MITHaystack/ASTRA/docs/help/README.md

## ASTRA HELP

### When Things Go Wrong

1. Try turning it off and back on again. 
2. Check for loose cables.
3. Try flipping cable orientations.
4. Align to zero, zero and cycle mount power. 

### Mechanical 
- [Stuff is Loose](astra-mechanical.md#Loose)
- [Stuff is Broken](astra-mechanical.md#Broken)
- [Wobbly Tripod](astra-mechanical.md#Tripod)
- [Swiveling Camera](astra-mechanical.md#Camera)
- [Detached Leveling Foot](astra-mechanical.md#Foot)

### Electrical
- [Out of Power](astra-electrical.md#Power)
- [Damaged cables](astra-electrical.md#Cable)
- [Battery is very hot](astra-electrical.md#BatteryHot)
- [Battery won't charge](astra-electrical.md#BatteryCharge)

### Radio
- [Lots of interference](astra-radio.md#Interference)
- [Lots of nothing](astra-radio.md#Nothing)
- [No calibrator](astra-radio.md#Calibrator)
- [No hydrogen line](astra-radio.md#Hline)

### Optical
- [There is Dirt on It](astra-optical.md#Cleaning)
- [The Camera came out](astra-optical.md#Loose)
- [The Camera won't focus](astra-optical.md#Focus)
- [The Images are always noise](astra-optica.md#Noisy)

### Computer
- [Abrupt shutdown](astra-computer.md#Shutdown)
- [SSH fails](astra-computer.md#SSH)
- [RDP fails](astra-computer.md#RDP)
- [RDP is small](astra-computer.md#RDPScreen)
- [No ASTRA hotspot](astra-computer.md#Hotspot)
- [Won't connect to network](astra-computer.md#Network)
- [Updates](astra-computer.md#Updates)

### User Interface
- [Known Issues](astra-ui.md#Bugs)
