MITHaystack/ASTRA/docs/hardware/sdr-carrier.md

# ASTRA - Compute and SDR Enclosure Build 

A dedicated computer and SDR enclosure can be used with ASTRA but it is
often easier to integrate directly into a combined DAQ and Energy unit
box.
