MITHaystack/ASTRA/docs/hardware/computer.md

# ASTRA - Computer 

ASTRA uses an AMD or Intel NUC style computer with a supporting metal case that provides an
NVME M.2 SSD drive. A small enough computer can fit into the Battery / DAQ enclosure. We have
tried comptuers such as the Raspberry Pi 5 but have had reliability and power issues.
