MITHaystack/ASTRA/docs/about/README.md

## About ASTRA

ASTRA occurred because of Joe Lind's Eagle Scout project needing to meet the requests and needs of
the potential users in his High School science program. They wanted a "teaching cart" for astronomy.
The existing Small Radio Telescope really wasn't suitable for their needs or location. At MIT Haystack Observatory, we didn't have quite the right thing so Joe and his father Dr. Frank Lind set out to create a solution and respond to the request. 

ASTRA is the result... 

_To help other people at all times_

# ASTRA History

ASTRA derives from earlier work on the Small Radio Telescope (SRT) and Very Small Radio Telescope (VSRT). These systems were initially developed by Dr. Alan Rogers of MIT Haystack Observatory and documented in his memo series. Many staff members of MIT Haystack Observatory have contributed to these systems and they have been the subject of a number of student projects. 

The specific ASTRA design was developed as part of a Haystack student project by Joe Lind of Groton Dunstable Region High School and Troop 1 West Groton. This project ultimately became a part of an Eagle Scout project by Joe to contribute the second prototype unit to Groton Dunstable Region High School (GDRHS). Early testing and construction of this unit involved contributions from members of Scouting America Troop 1 West Groton. Staff members at MIT Haystack Observatory also contributed to 
the concepts and technologies selected for implementation of ASTRA. These individuals include Ryan
Volz, John Swoboda, and Rigel Cappallo. 

Dr. Frank Lind developed the first prototype design and software in combination with early testing together and concept exploration with Joe Lind. The entire effort was in response to the science teachers of Groton Dunstable High School wanting a smaller and more portable system than an SRT. Hardware integration and system testing was a collaborative effort that spanned more than a year. The Eagle Scout project to duplicate and donate the system spanned about six months from approval to 
completion. 

## Acknowledgements

We would like to acknowledge all those who have donated funds and time to support the development ASTRA. This includes generous support for the donation of the second prototype unit to the GDRHS. Scouts from Troop 1 West Groton also contributed to the system by helping to replicate the prototype unit, assembling components, and helping with testing. The enthusiasm of Haystack staff members during
our testing on site was also welcome and very encouraging. 

Dr. Frank Lind also put in endless hours on nights and weekends testing hardware and developing the software for the system. The Lind family also financially supported aspects of the project outside of the Eagle scout project. 

_Labor omnia vincit_

Joe Lind also earned his stripes as an astronomer, testing in the middle of winter and well below zero, and the heat of summer with heat, humidity, and a lack of shade. 

_Sic itur ad astra_

# ASTRA Open Source Usage and Contributions

ASTRA leverages a number of other commercial and open source projects. 

- [Python]() We have been heavy duty python users since 2001! Read-write Lisp for the win.
- Assorted python packages such as numpy, scipy, aiomqtt, etc. 
- [DigitalRF]() Behind the scenes for RF data capture. Our own one here.
- [Skyplot]() A really first class python package for starcharts and plotting.
- [Nicegui]() As claimed, a really well done asyncio framework graphical interface platform.
- [Marimo]() Python notebooks for on platform manipulation and analysis of data. 

# ASTRA Use of Artificial Intelligence

The ASTRA user interface has made use of the Claude Sonnet 4.6 model for initial vibe coding of the astra-ui portion of the code base. This coding was guided by the Nice Vibes AI coding agent guidelines for the python NiceGUI user interface framework. Other code used in ASTRA has been hand developed. All of it has been modified or edited manually. 

### License

This system and software, unless otherwise noted, is licensed under the BSD 3-clause 
"New" or "Revised" license.
