MITHaystack/ASTRA/docs/projects/README.md

# ASTRA Projects

ASTRA projects are efforts requiring several observing sessions. 
Intermediate lessons require the reduction and analysis of data using on 
platform Marimo notebooks. Advanced lessons require the use of ASTRA
via command line tools and in combination with other software on and
off the platform. 

### Mini Projects - Basic
- [Observing the Sun](projects/astra-project-solar)
- [Observing the Moon](projects/astra-project-lunar)
- [Imaging Andromeda](projects/astra-project-andromeda)
- [Imaging the Pleiades](projects/astra-project-pleiades)
- [Star Cluster Survey](projects/astra-project-star-clusters)

### Mini Projects - Intermediate
- [Detecting Galactic Rotation Curve](projects/astra-project-rotation-curve-detection)
- [Observing Jupiter](projects/astra-project-jovian)
- [Measuring Radio Calibrators](projects/astra-project-calibrators)

### Mini Projects - Advanced
- [Imaging the Galactic Rotation Curve](projects/astra-project-rotation-curve-detection)
- [Imaging The Crab Nebula](projects/astra-project-crab-nebula)
