MITHaystack/ASTRA/docs/observations/radio-obs-example.md

## ASTRA Example Radio Observations

### Background RF

Background data pointed at the horizon with only interference lines visible. 

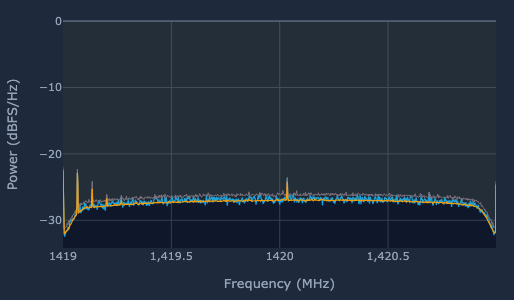
[picture p17: docs/observations/img/astra-background-rf-psd.png]


### Hydrogen Line Detection (Cygnus)

User interface example of live detected 1420.405 MHz Hydrogen Line (21 cm) signal. Pointing was
off of Cygnus. 

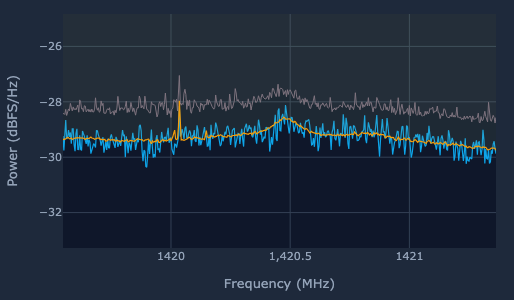
[picture p18: docs/observations/img/astra-hline-rf-example.png]


and a later time with more zoom and integration...

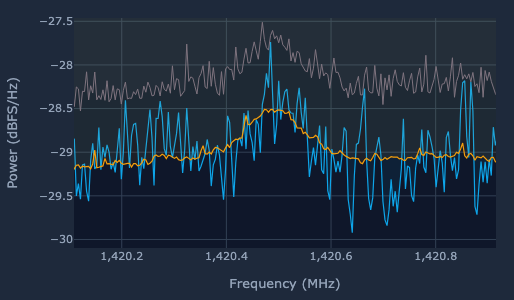
[picture p19: docs/observations/img/astra-hline-rf-zoom-example.png]


### DigitalRF Hydrogen Line (Examples)

Example towards polaris recorded as DigitalRF data capture and post processed with 1 second, 10 second, and 100 second integration lengths. A zoom in is shown for the 100 second data. This kind of
processing can be done on ASTRA itself using Marimo notebooks. 

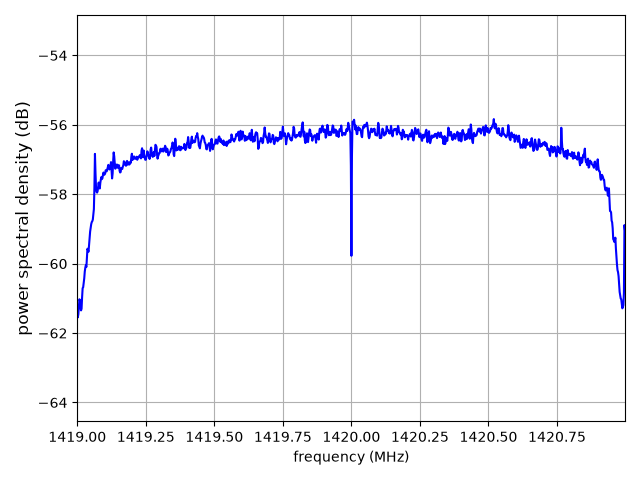
[picture p20: docs/observations/img/astra-polaris-hline-1sec.png]

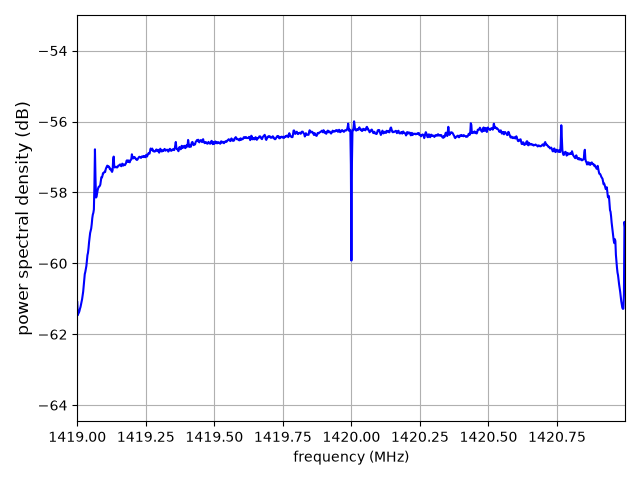
[picture p21: docs/observations/img/astra-polaris-hline-10sec.png]

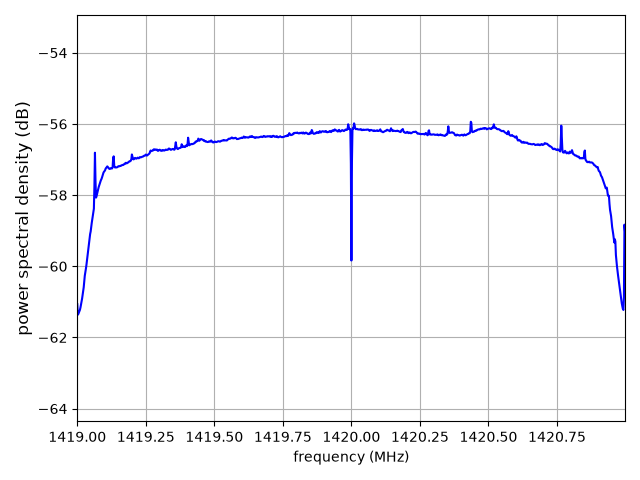
[picture p22: docs/observations/img/astra-polaris-hline-100sec.png]

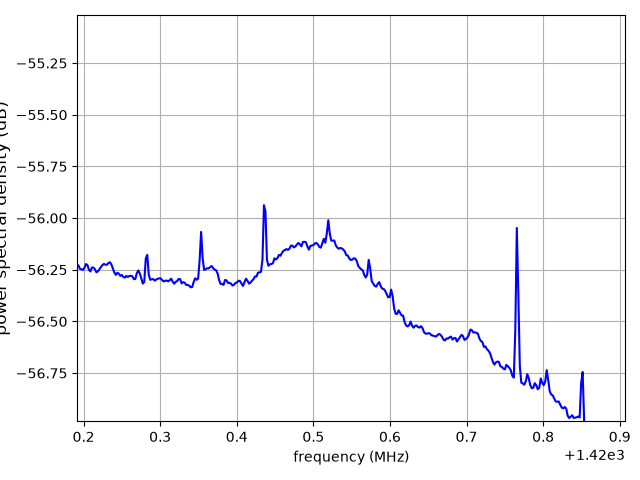
[picture p23: docs/observations/img/astra-polaris-hline-100sec-zoom.png]


Sharp line like features are generally local or self interference. Shielding and ferrites do help with
this in some cases. Getting away from local RFI is generally most effective. 

### Early Drift Scan

Example of DigitalRF collected and post processed zenith pointing drift scan from early testing.
