MITHaystack/ASTRA/docs/hardware/img/aiu/aiu-bracket-attachment.jpg

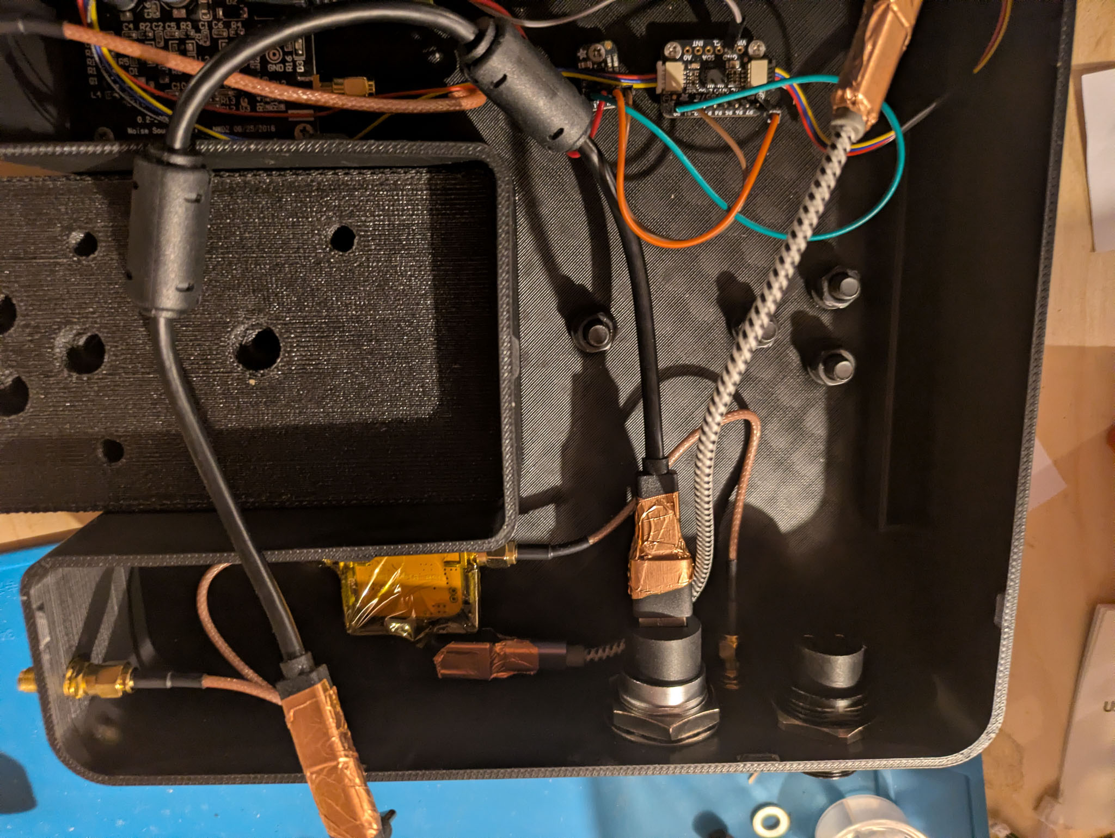
docs/hardware/img/aiu/aiu-bracket-attachment.jpg
