MITHaystack/ASTRA/docs/hardware/img/aiu/aiu-internal-complete.jpg

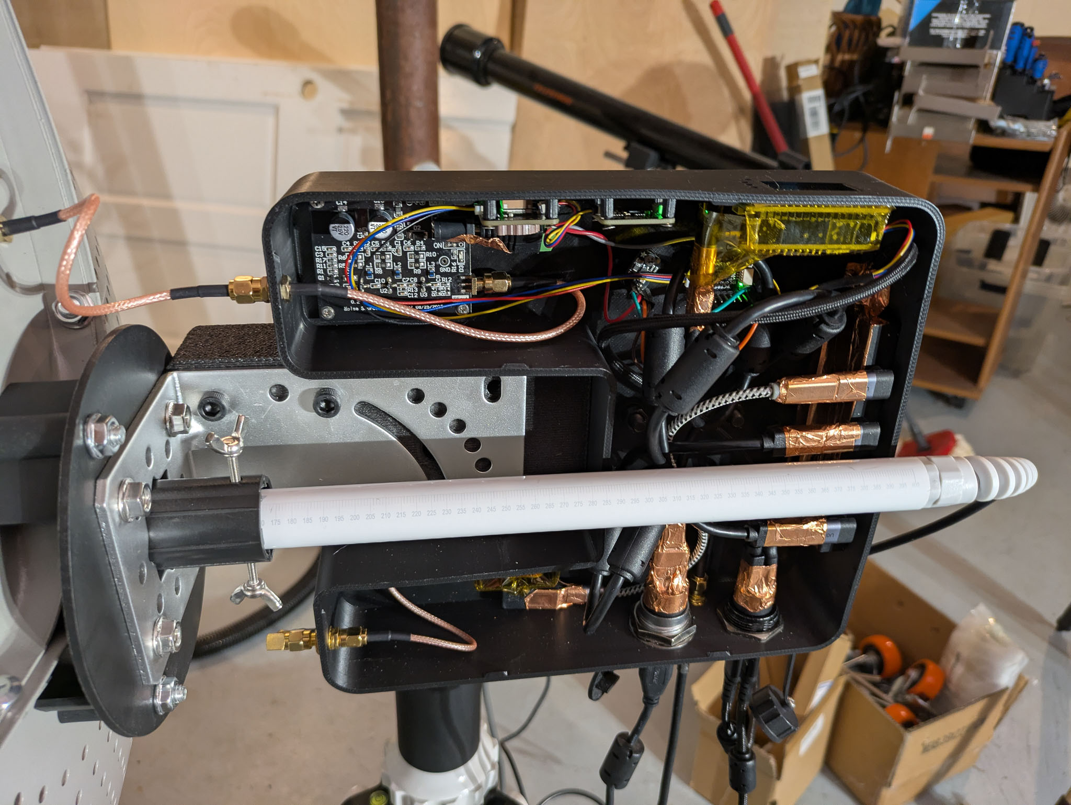
docs/hardware/img/aiu/aiu-internal-complete.jpg
