MITHaystack/ASTRA/docs/hardware/img/aiu/aiu-oled-external.jpg

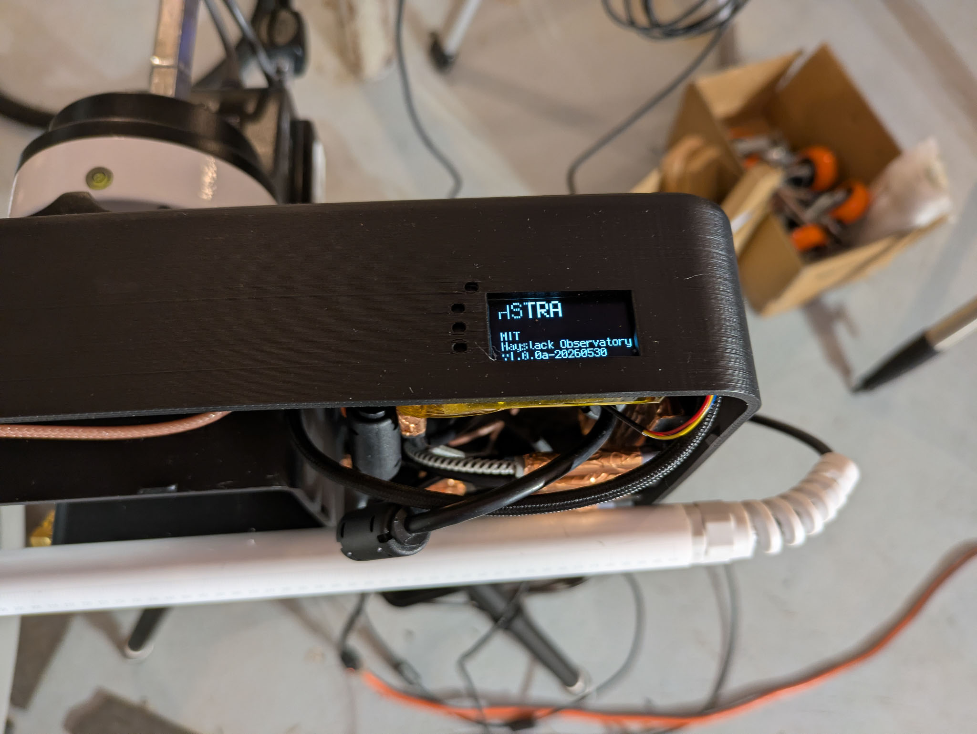
docs/hardware/img/aiu/aiu-oled-external.jpg
