MITHaystack/ASTRA/docs/hardware/img/aiu/aiu-sensors.jpg

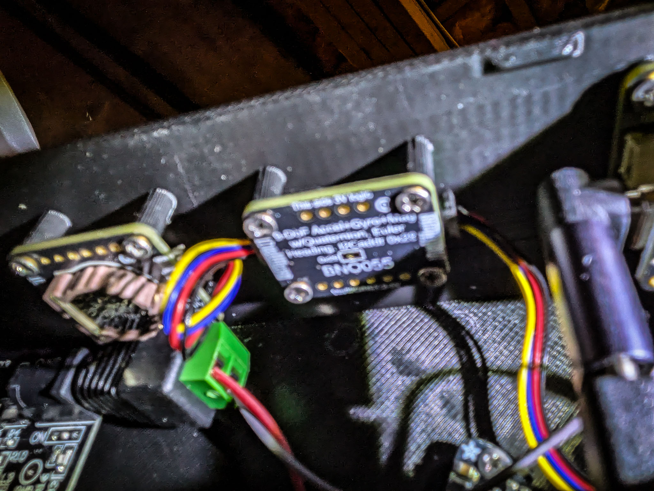
docs/hardware/img/aiu/aiu-sensors.jpg
