MITHaystack/ASTRA/docs/hardware/img/aiu/astra-aiu-internal.jpg

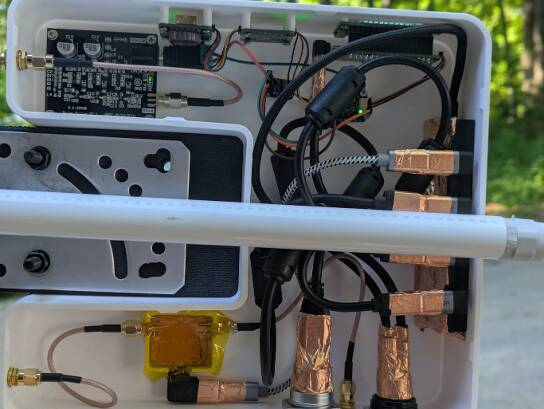
docs/hardware/img/aiu/astra-aiu-internal.jpg
