MITHaystack/ASTRA/docs/hardware/img/antenna/antenna-attachment-rear.jpg

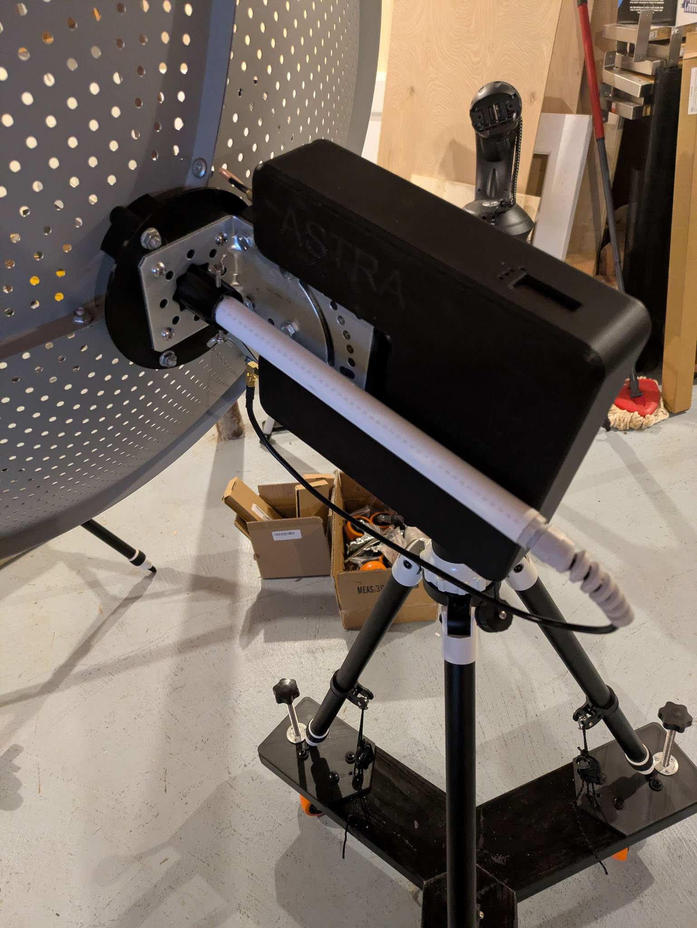
docs/hardware/img/antenna/antenna-attachment-rear.jpg
