MITHaystack/ASTRA/docs/hardware/img/antenna/antenna-dovetail-attachment.jpg

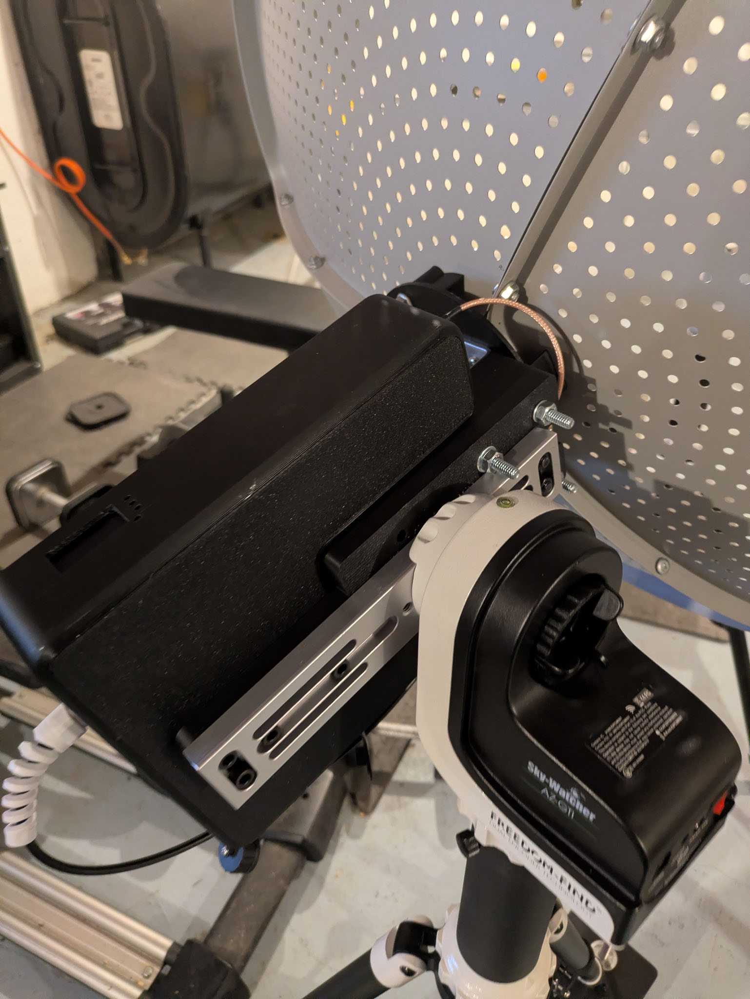
docs/hardware/img/antenna/antenna-dovetail-attachment.jpg
