MITHaystack/ASTRA/docs/hardware/img/antenna/antenna-feed-attachment.jpg

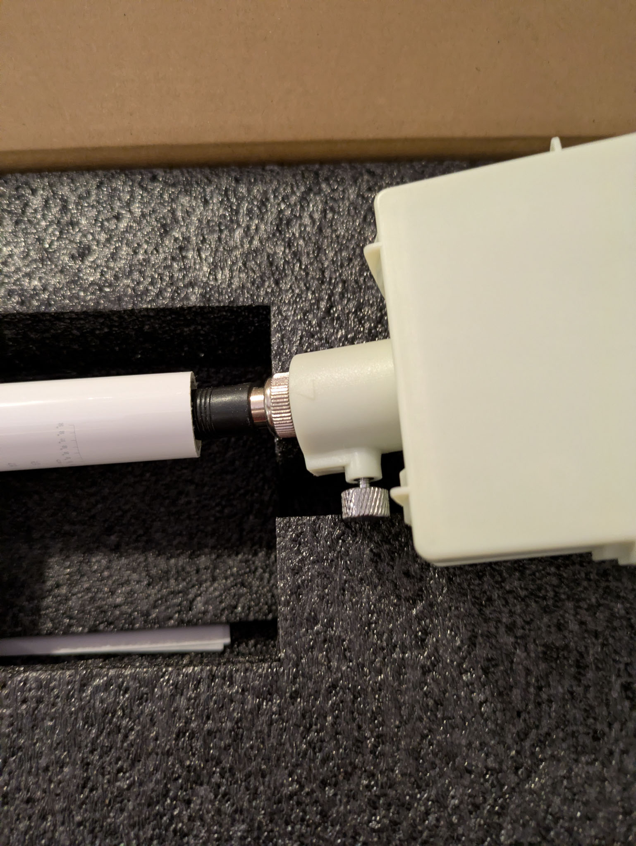
docs/hardware/img/antenna/antenna-feed-attachment.jpg
