MITHaystack/ASTRA/docs/hardware/img/antenna/antenna-feed-position.jpg

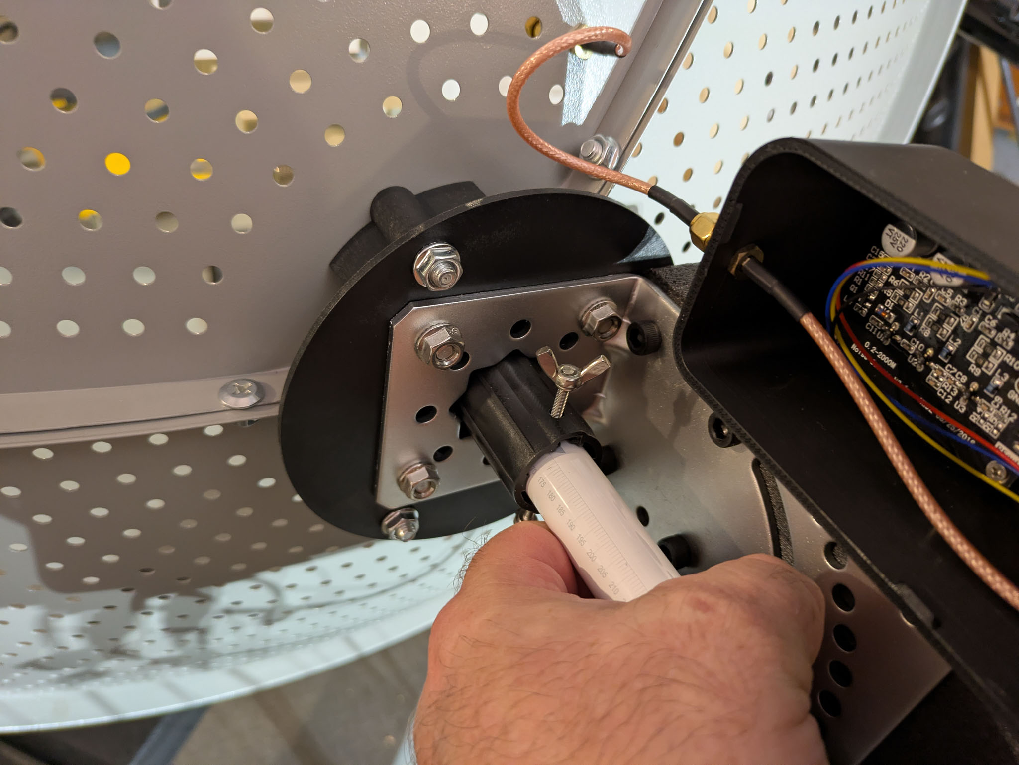
docs/hardware/img/antenna/antenna-feed-position.jpg
