MITHaystack/ASTRA/docs/hardware/img/antenna/antenna-feed-unboxing2.jpg

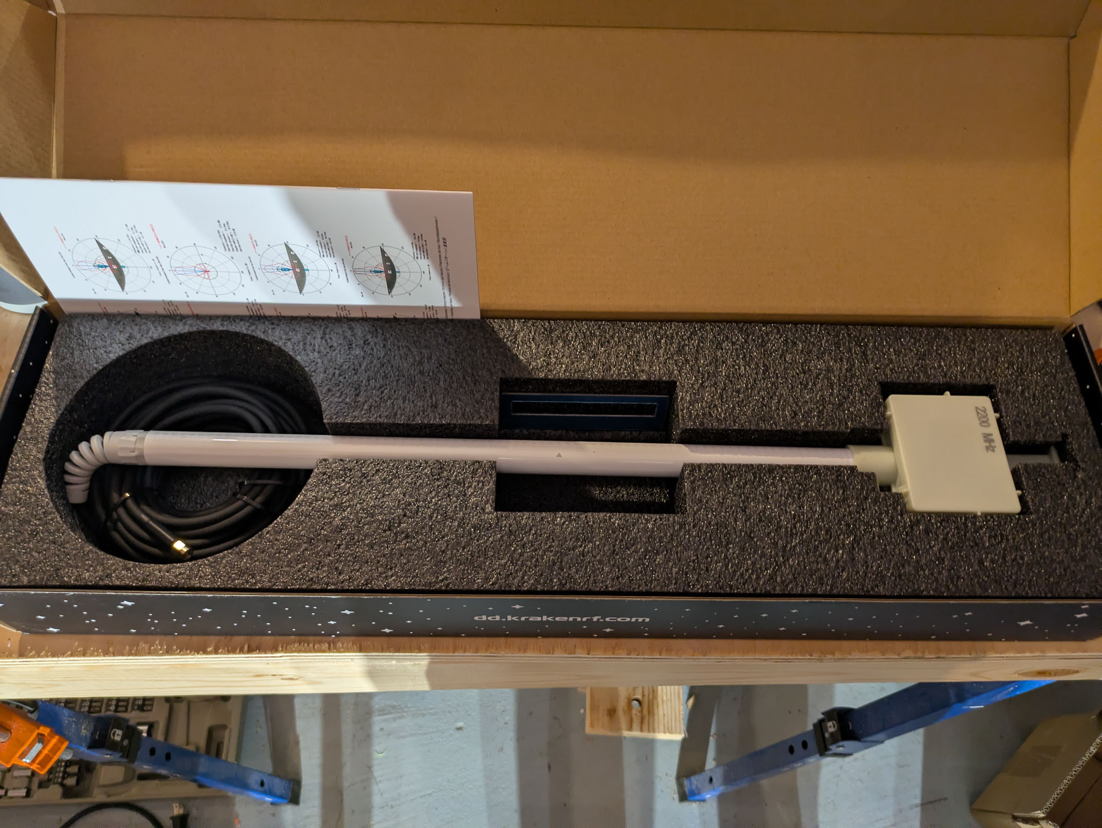
docs/hardware/img/antenna/antenna-feed-unboxing2.jpg
