MITHaystack/ASTRA/docs/hardware/img/antenna/antenna-feed-unboxing.jpg

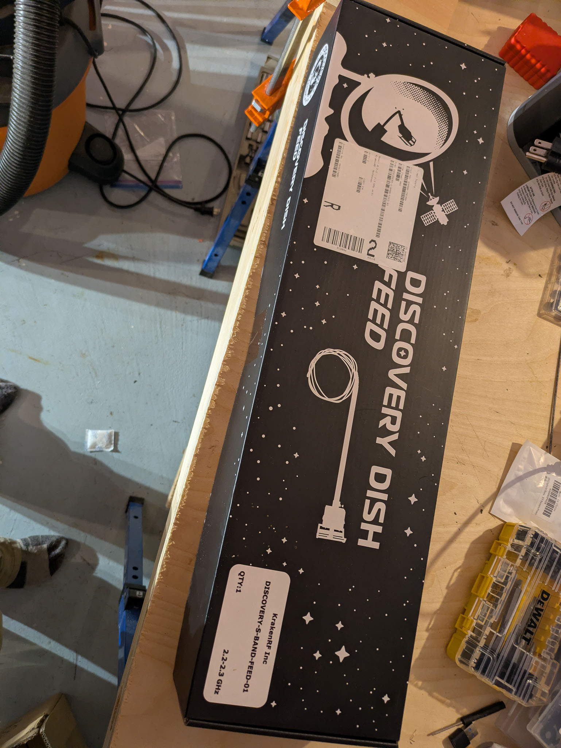
docs/hardware/img/antenna/antenna-feed-unboxing.jpg
