MITHaystack/ASTRA/docs/hardware/img/antenna/antenna-front.jpg

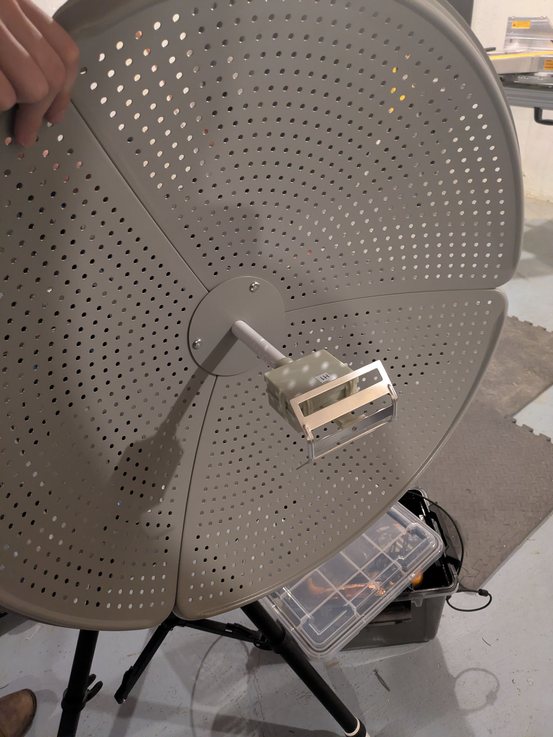
docs/hardware/img/antenna/antenna-front.jpg
