MITHaystack/ASTRA/docs/hardware/img/antenna/antenna-level.jpg

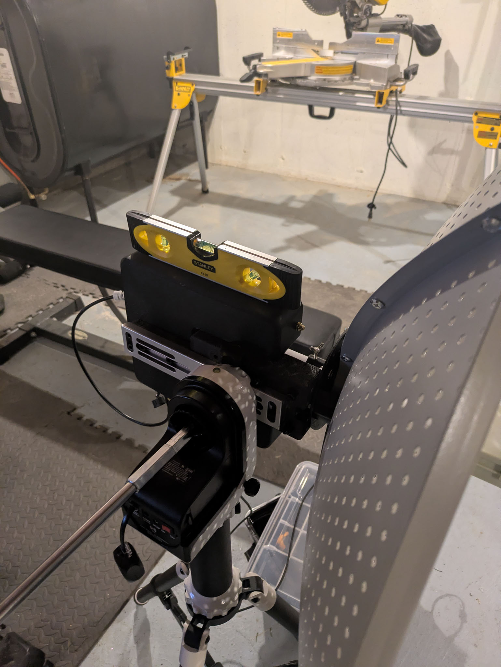
docs/hardware/img/antenna/antenna-level.jpg
