MITHaystack/ASTRA/docs/hardware/img/antenna/antenna-short-cable1.jpg

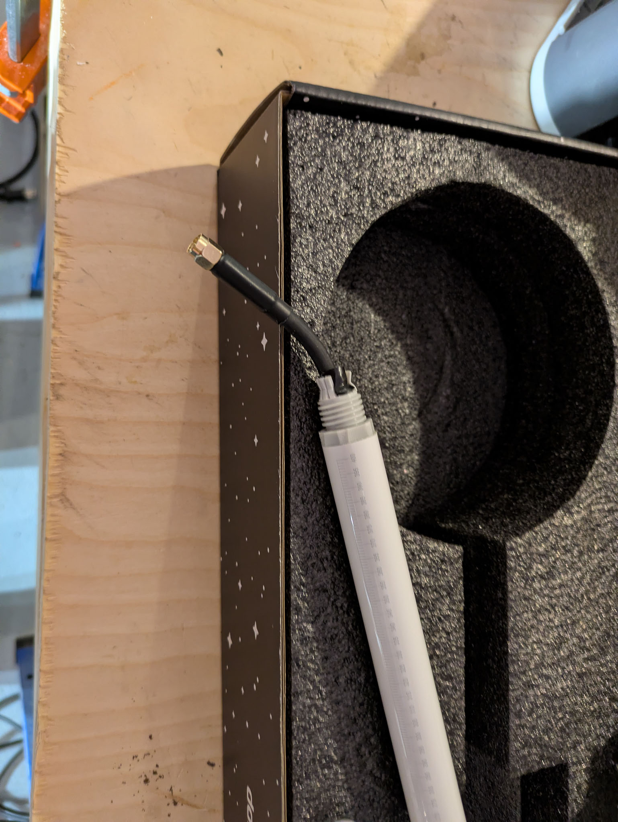
docs/hardware/img/antenna/antenna-short-cable1.jpg
