MITHaystack/ASTRA/docs/hardware/img/antenna/antenna-short-cable2.jpg

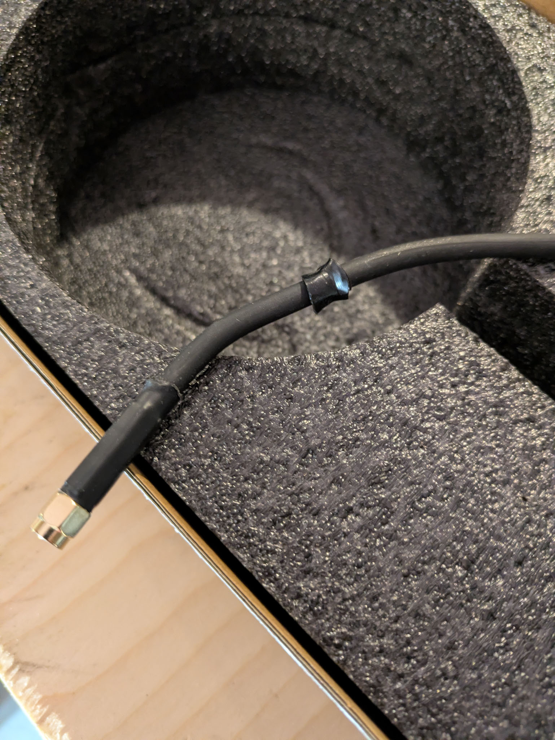
docs/hardware/img/antenna/antenna-short-cable2.jpg
