MITHaystack/ASTRA/docs/hardware/img/antenna/antenna-short-cable3.jpg

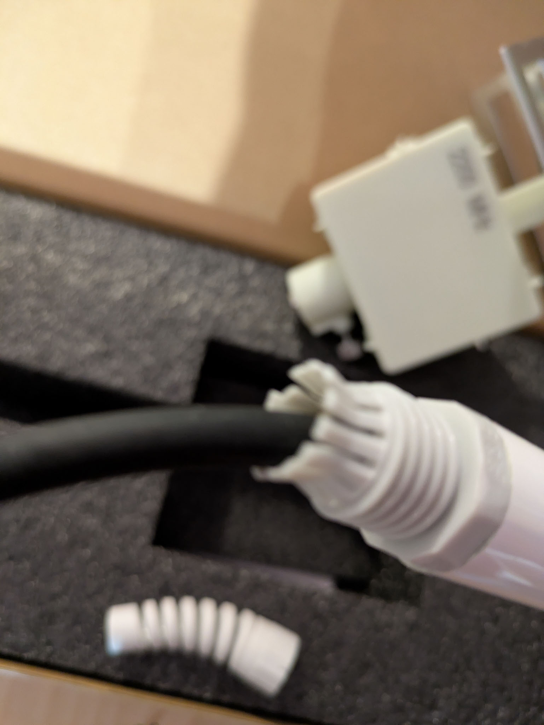
docs/hardware/img/antenna/antenna-short-cable3.jpg
