MITHaystack/ASTRA/docs/hardware/img/antenna/antenna-short-cable4.jpg

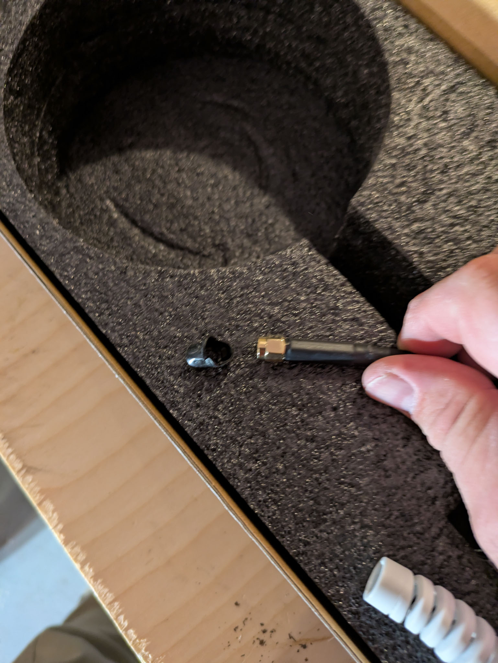
docs/hardware/img/antenna/antenna-short-cable4.jpg
