MITHaystack/ASTRA/docs/hardware/img/antenna/antenna-short-cable5.jpg

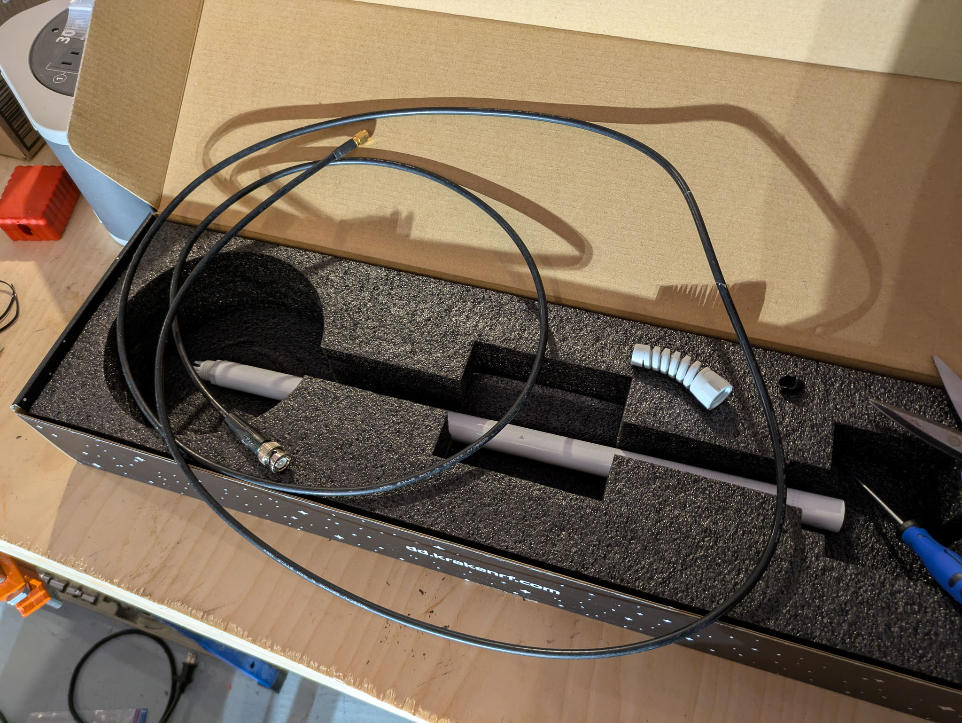
docs/hardware/img/antenna/antenna-short-cable5.jpg
