MITHaystack/ASTRA/docs/hardware/img/antenna/antenna-short-cable6.jpg

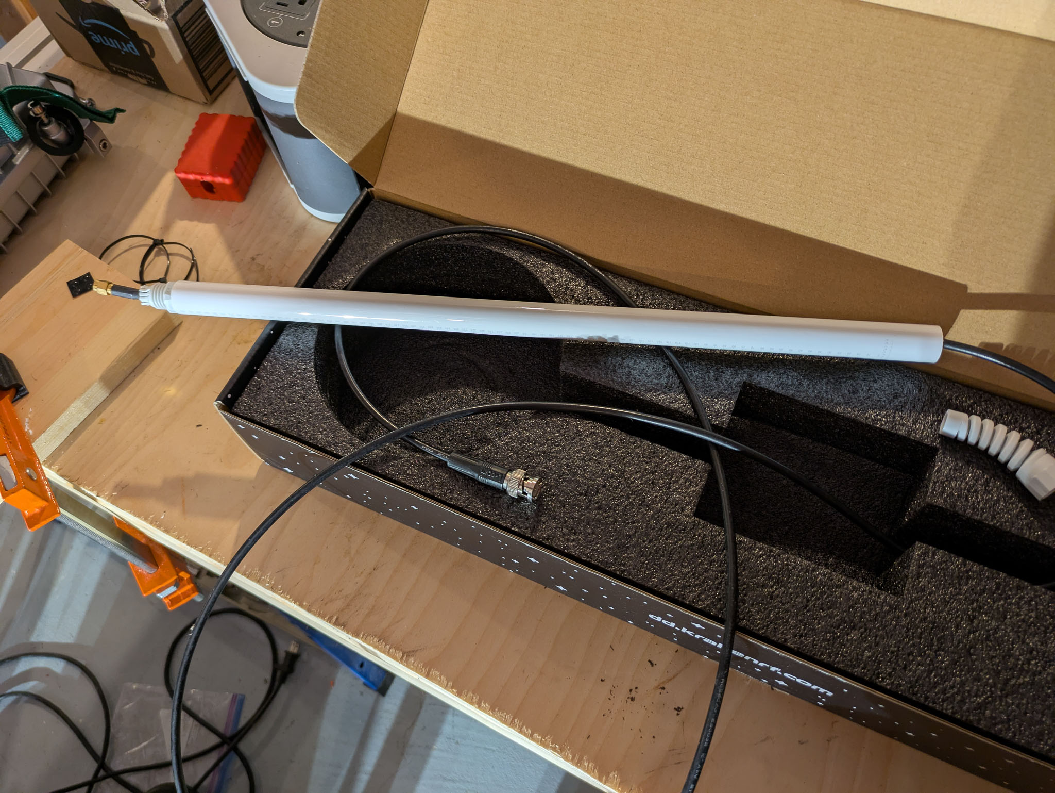
docs/hardware/img/antenna/antenna-short-cable6.jpg
