MITHaystack/ASTRA/docs/hardware/img/antenna/antenna-short-cable7.jpg

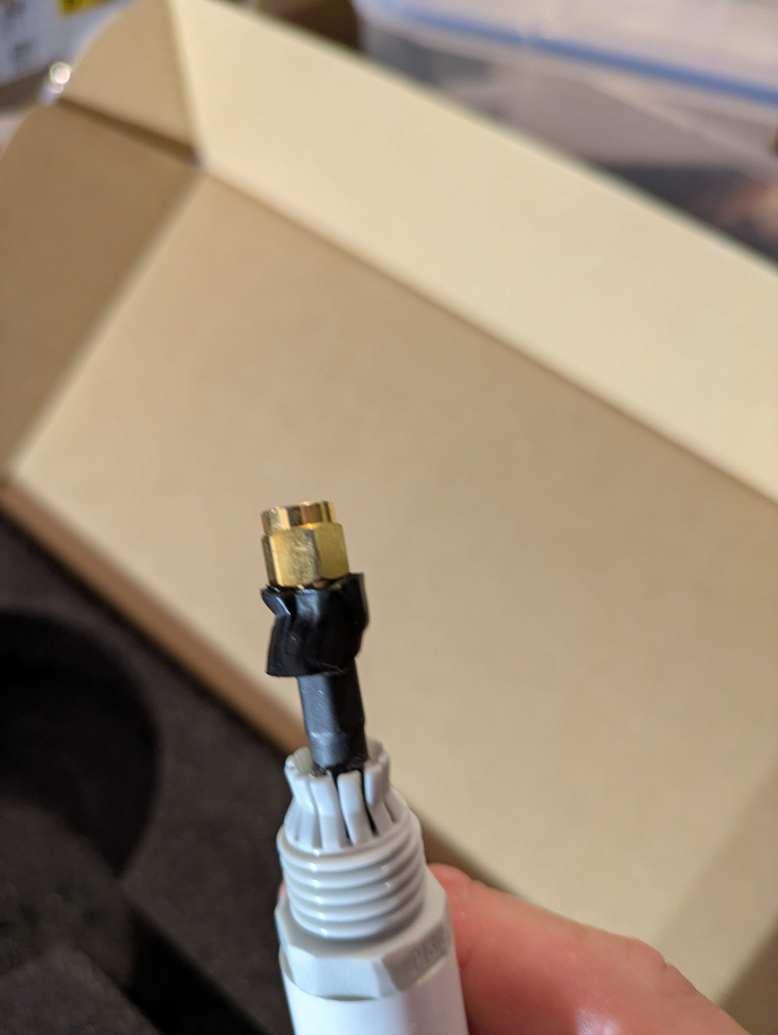
docs/hardware/img/antenna/antenna-short-cable7.jpg
