MITHaystack/ASTRA/docs/hardware/img/antenna/antenna-short-cable-feed.jpg

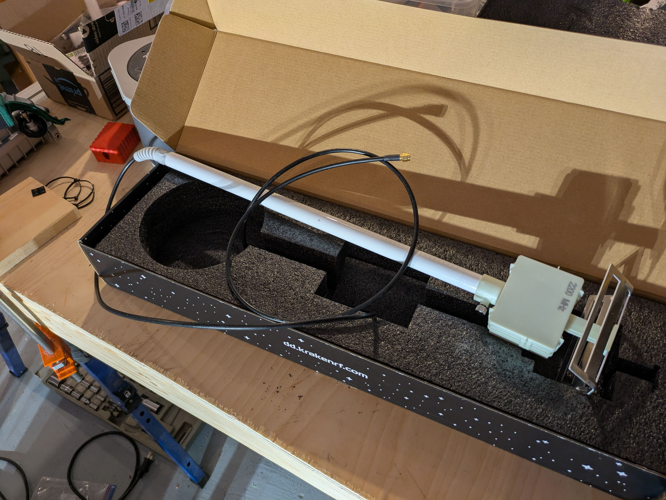
docs/hardware/img/antenna/antenna-short-cable-feed.jpg
