MITHaystack/ASTRA/docs/hardware/img/antenna/antenna-short-relief.jpg

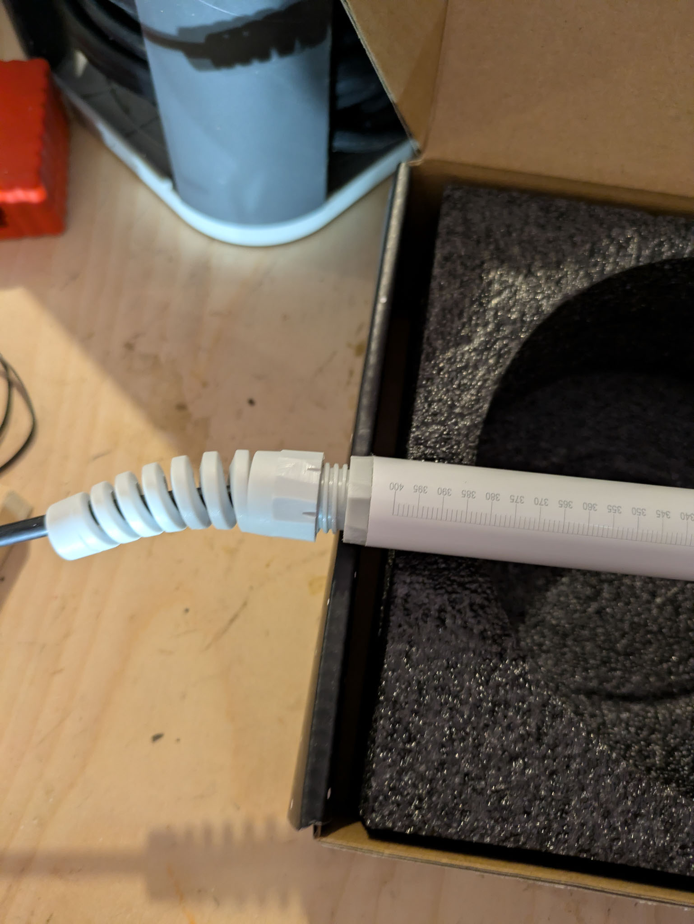
docs/hardware/img/antenna/antenna-short-relief.jpg
