MITHaystack/ASTRA/docs/hardware/img/base/base-align-glue.jpg

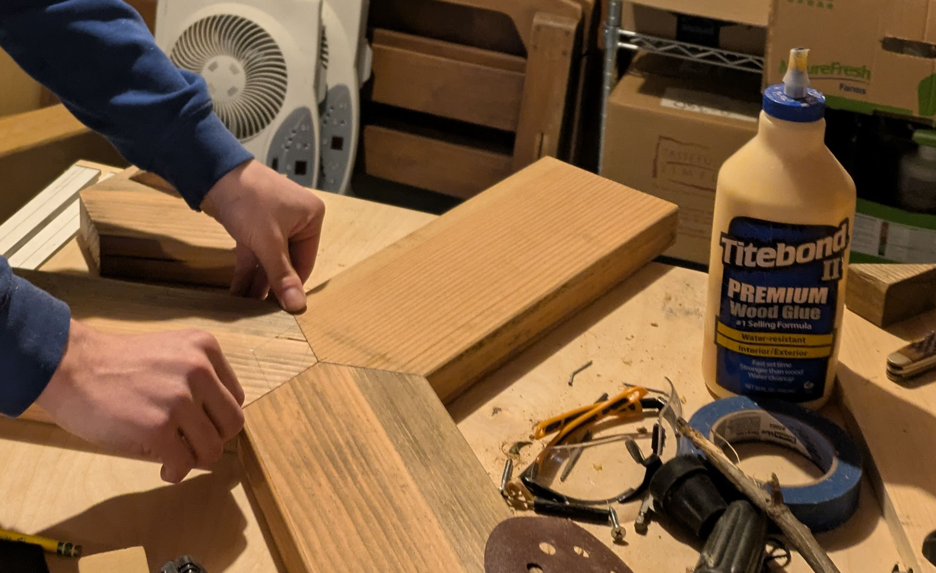
docs/hardware/img/base/base-align-glue.jpg
