MITHaystack/ASTRA/docs/hardware/img/base/base-center-connections.jpg

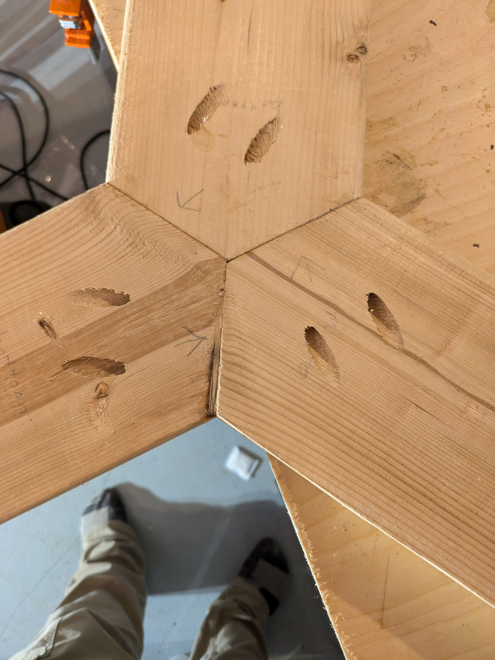
docs/hardware/img/base/base-center-connections.jpg
