MITHaystack/ASTRA/docs/hardware/img/base/base-cut-saw1.jpg

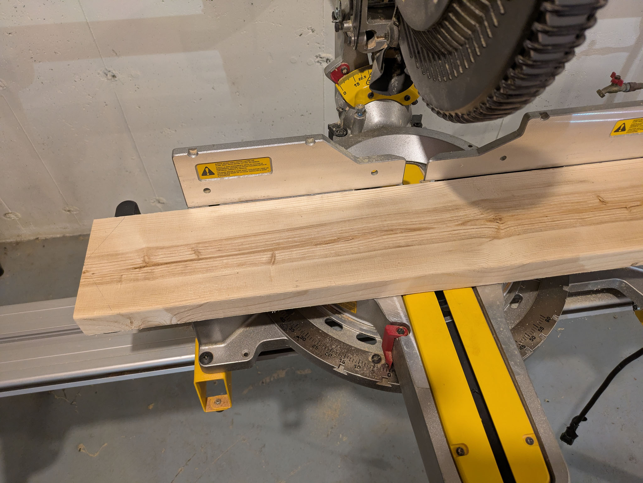
docs/hardware/img/base/base-cut-saw1.jpg
