MITHaystack/ASTRA/docs/hardware/img/base/base-cut-saw2.jpg

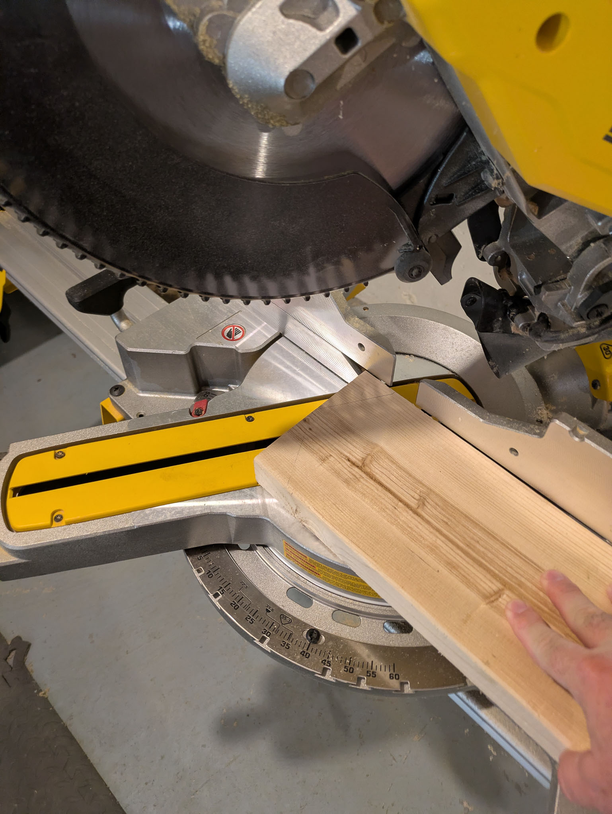
docs/hardware/img/base/base-cut-saw2.jpg
