MITHaystack/ASTRA/docs/hardware/img/base/base-cuts-marked.jpg

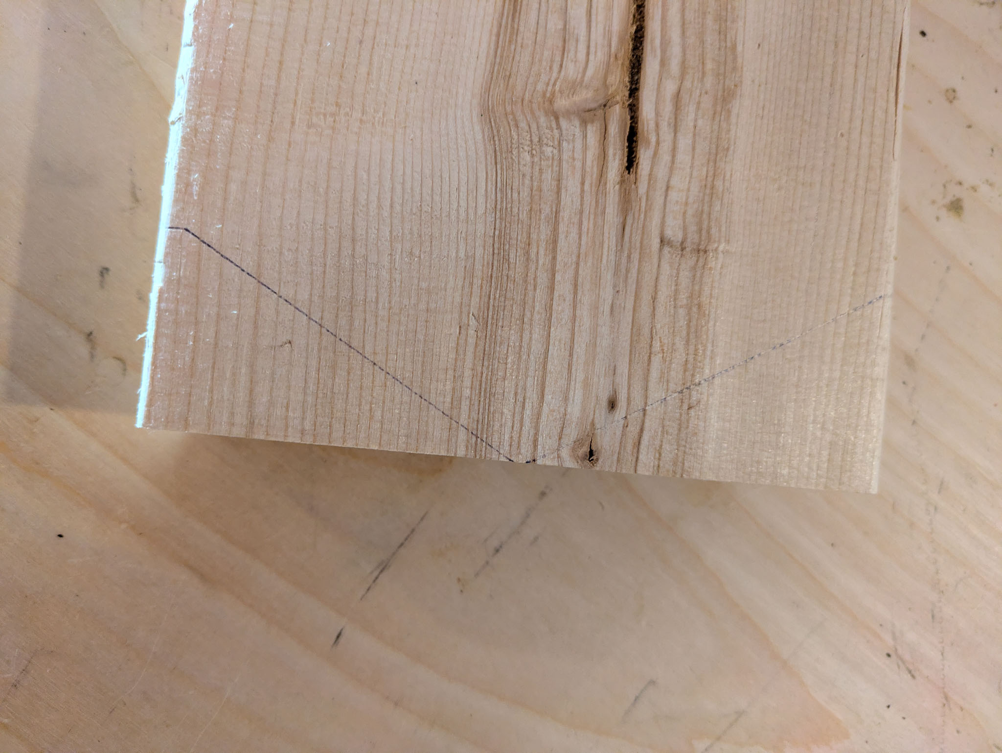
docs/hardware/img/base/base-cuts-marked.jpg
