MITHaystack/ASTRA/docs/hardware/img/base/base-foot-mount2.jpg

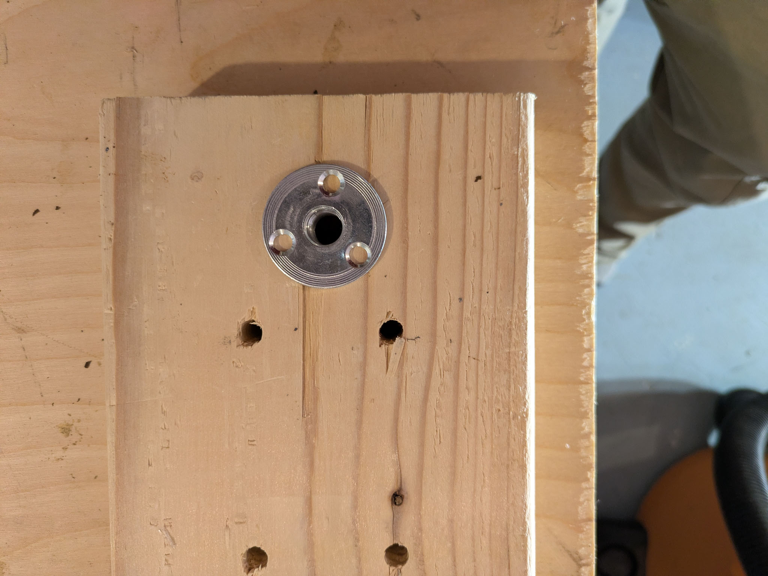
docs/hardware/img/base/base-foot-mount2.jpg
