MITHaystack/ASTRA/docs/hardware/img/base/base-foot-mount.jpg

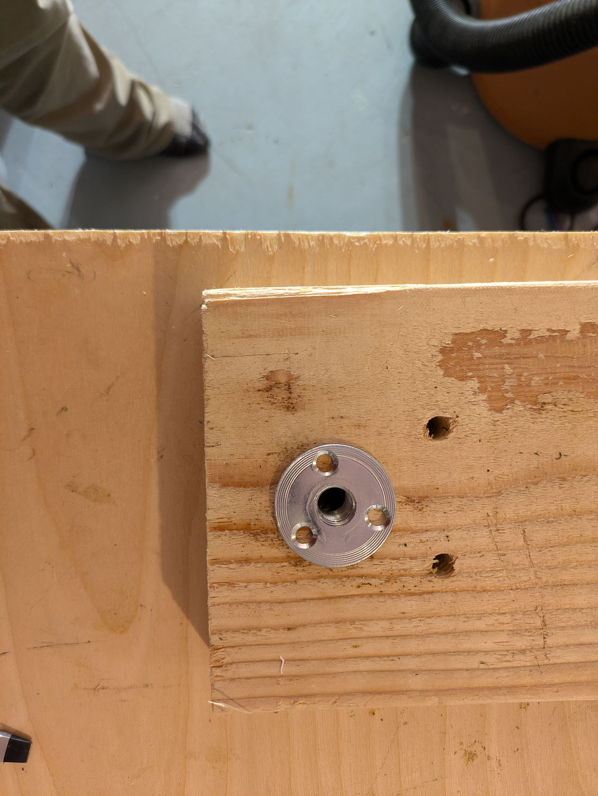
docs/hardware/img/base/base-foot-mount.jpg
