MITHaystack/ASTRA/docs/hardware/img/base/base-hole-pattern.jpg

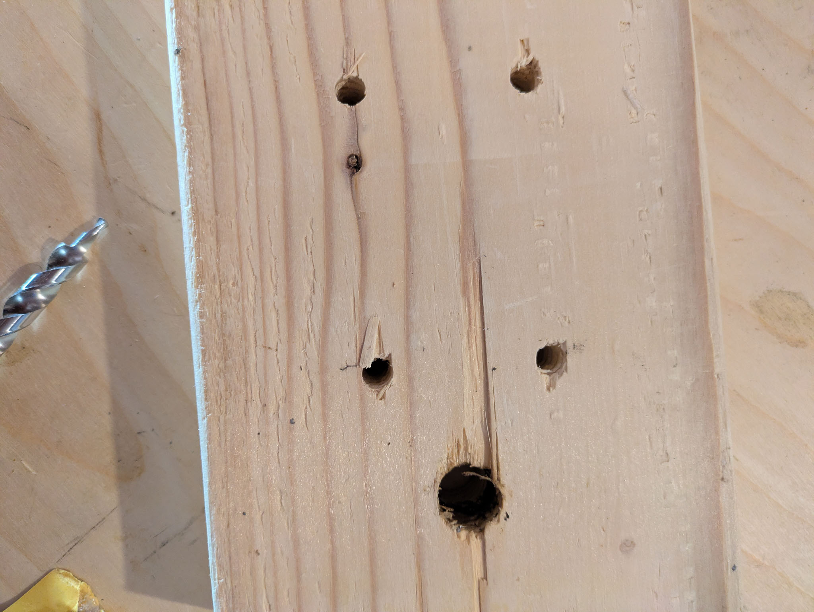
docs/hardware/img/base/base-hole-pattern.jpg
