MITHaystack/ASTRA/docs/hardware/img/base/base-large-wheel-option.jpg

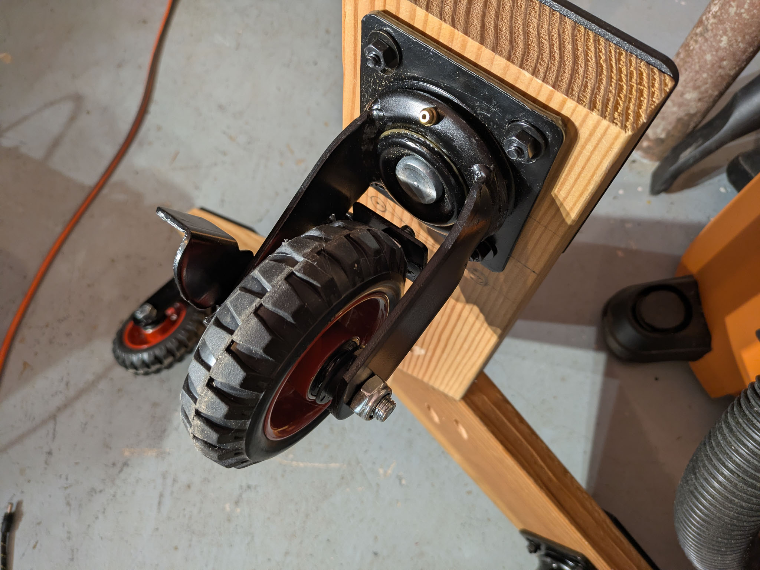
docs/hardware/img/base/base-large-wheel-option.jpg
