MITHaystack/ASTRA/docs/hardware/img/base/base-screw-jig.jpg

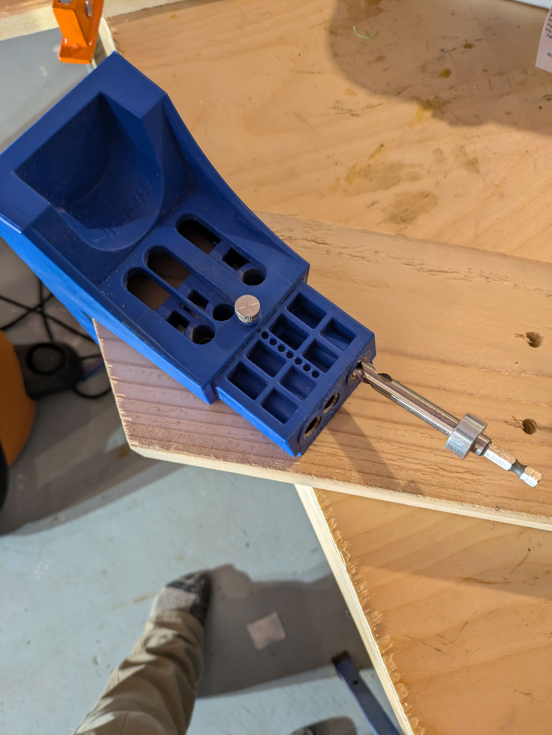
docs/hardware/img/base/base-screw-jig.jpg
