MITHaystack/ASTRA/docs/hardware/img/base/base-section.jpg

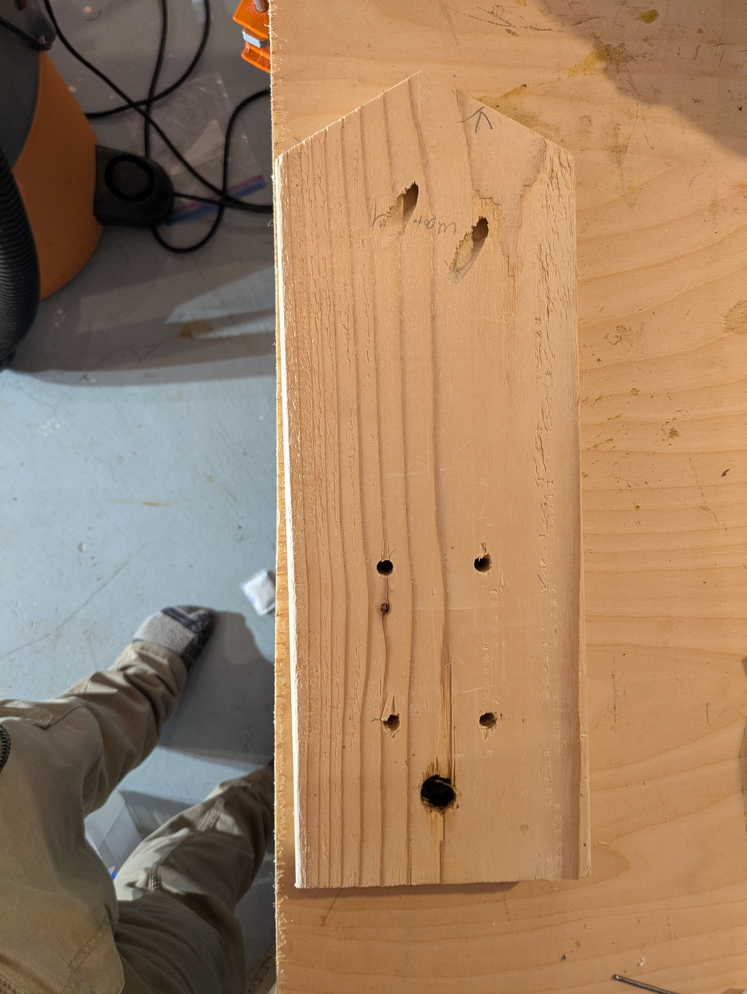
docs/hardware/img/base/base-section.jpg
