MITHaystack/ASTRA/docs/hardware/img/base/base-sections-cut2.jpg

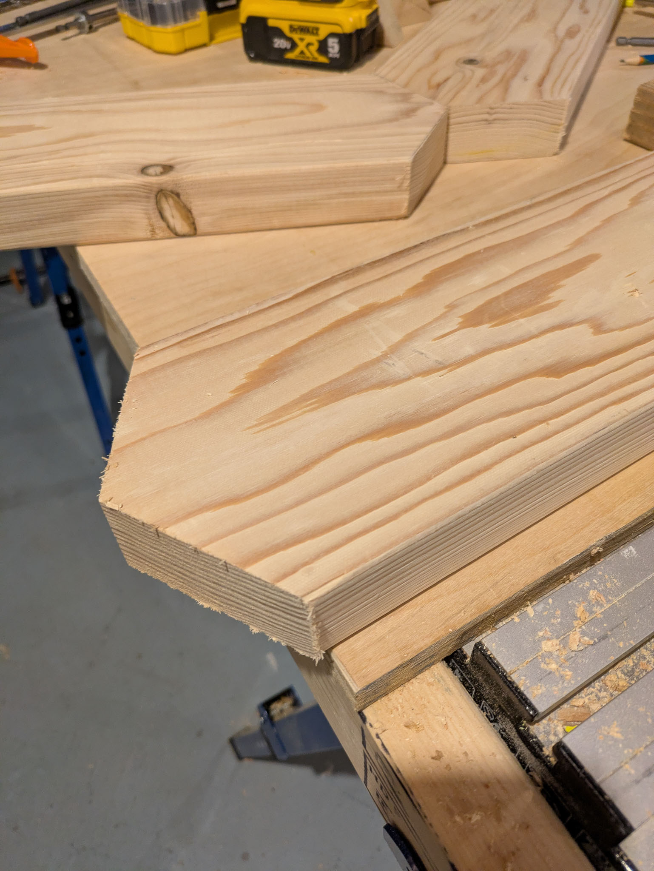
docs/hardware/img/base/base-sections-cut2.jpg
