MITHaystack/ASTRA/docs/hardware/img/base/base-sections-cut.jpg

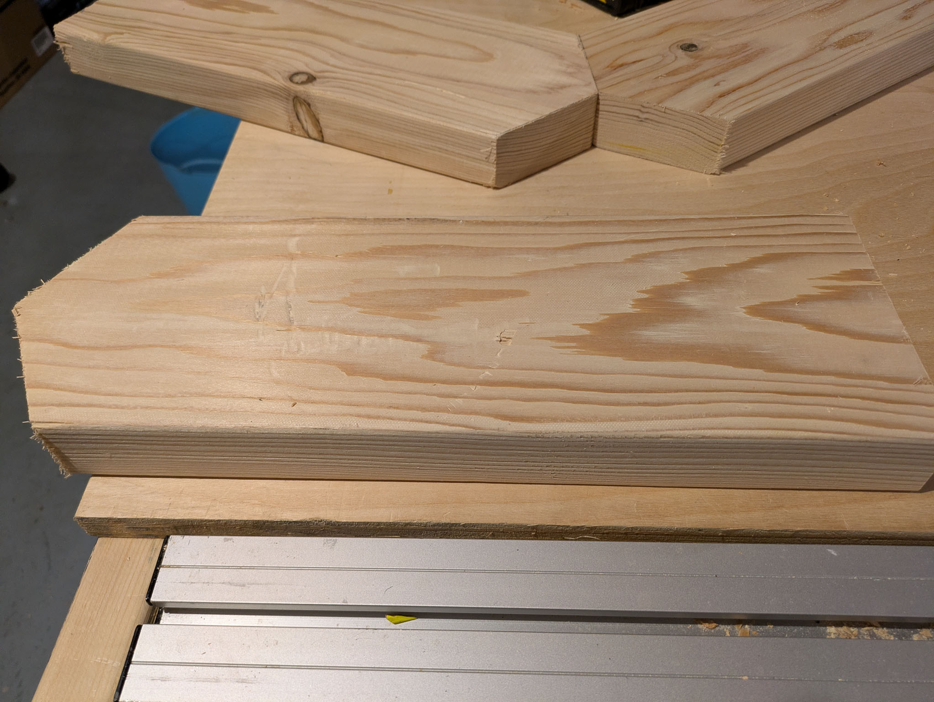
docs/hardware/img/base/base-sections-cut.jpg
