MITHaystack/ASTRA/docs/hardware/img/base/base-template1.jpg

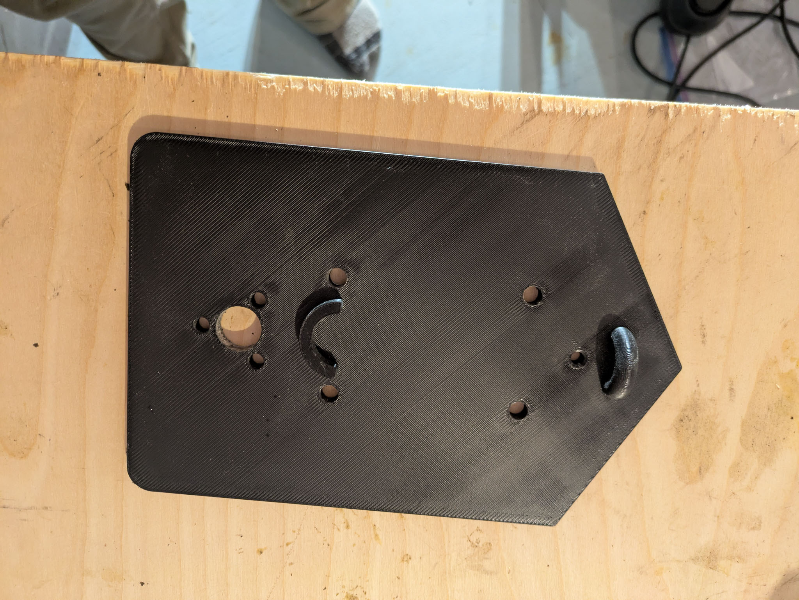
docs/hardware/img/base/base-template1.jpg
