MITHaystack/ASTRA/docs/hardware/img/base/base-template-edge-cuts.jpg

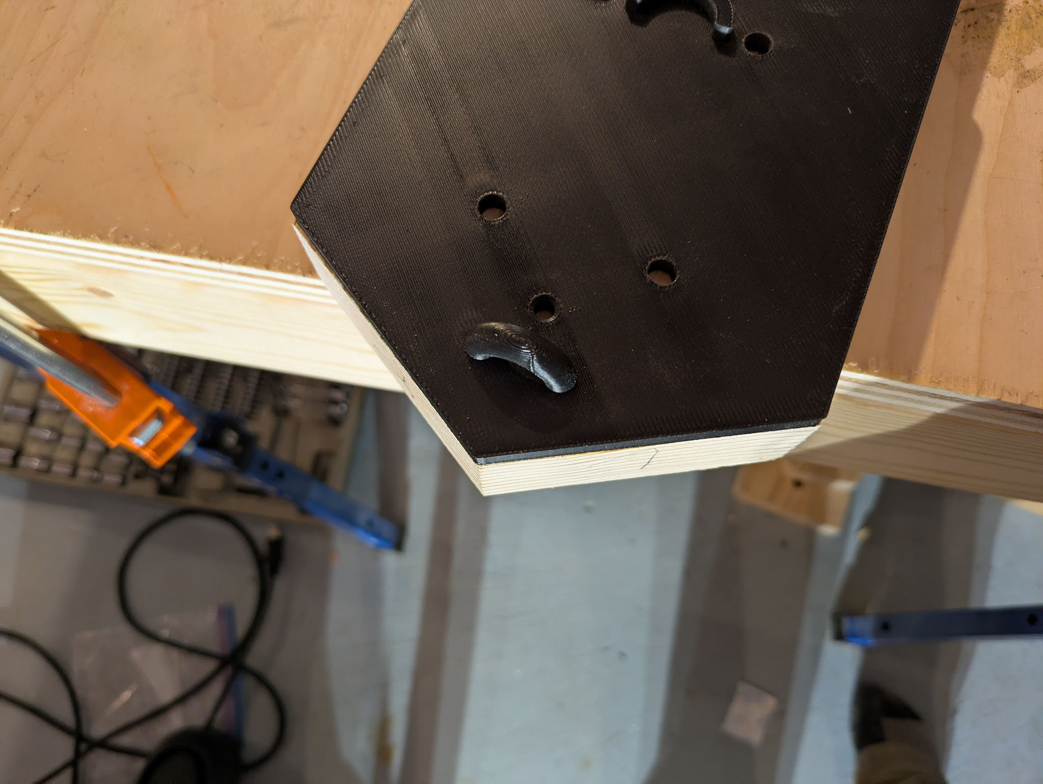
docs/hardware/img/base/base-template-edge-cuts.jpg
