MITHaystack/ASTRA/docs/hardware/img/base/base-template-holes-drilled.jpg

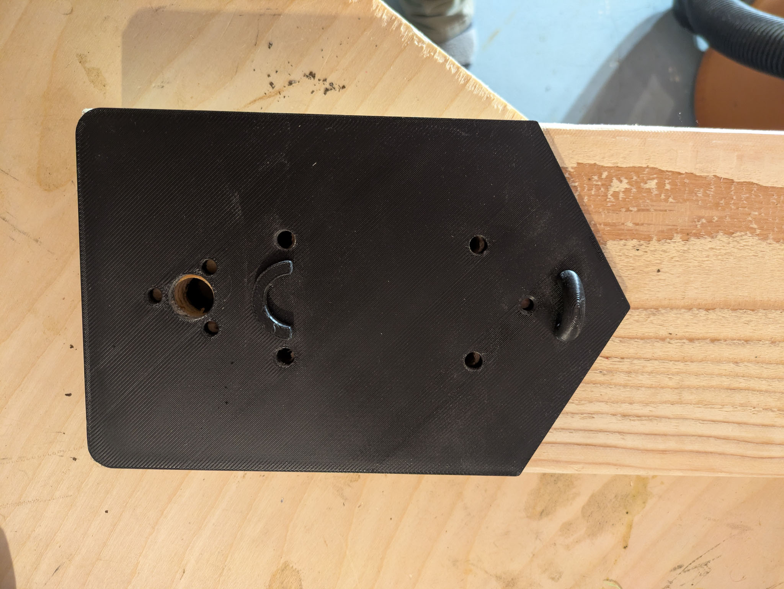
docs/hardware/img/base/base-template-holes-drilled.jpg
