MITHaystack/ASTRA/docs/hardware/img/base/base-template-marking-cuts2.jpg

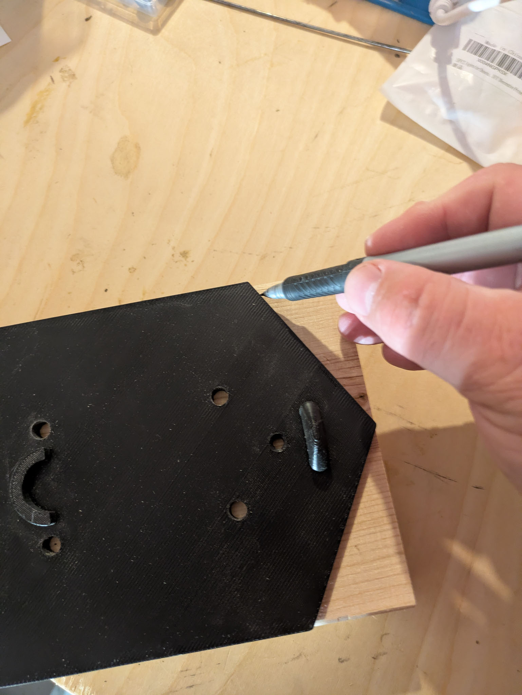
docs/hardware/img/base/base-template-marking-cuts2.jpg
