MITHaystack/ASTRA/docs/hardware/img/base/base-template-marking-cuts.jpg

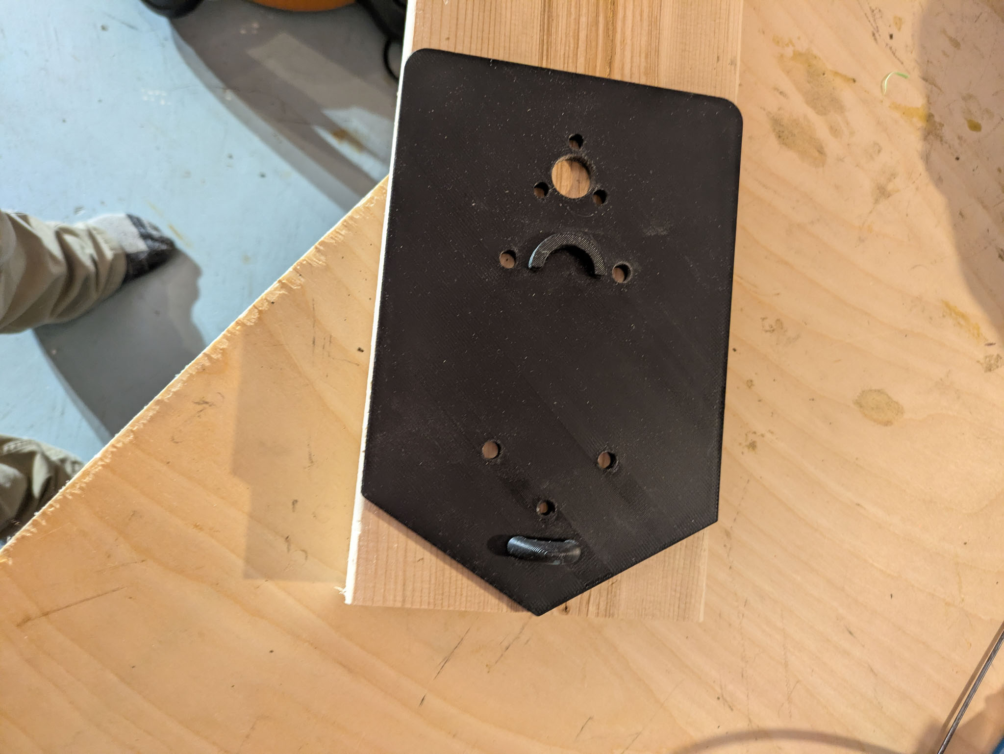
docs/hardware/img/base/base-template-marking-cuts.jpg
