MITHaystack/ASTRA/docs/hardware/img/daq-energy/astra-sdr-connections.jpg

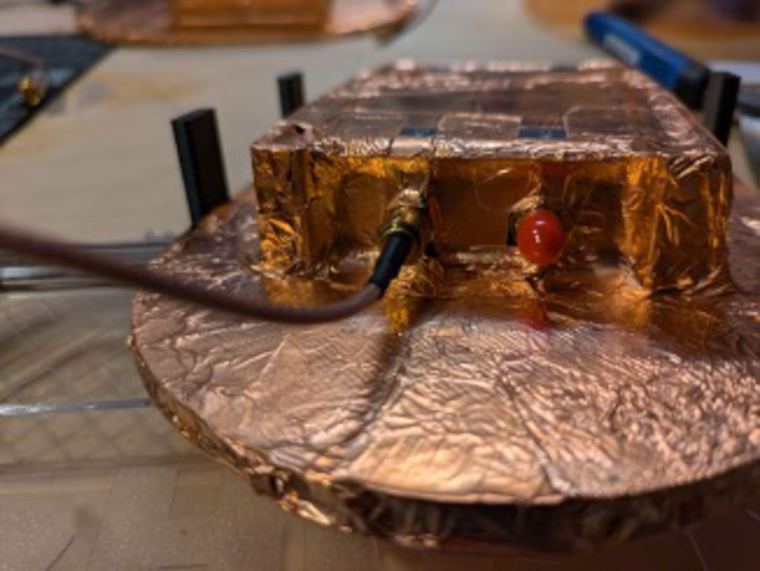
docs/hardware/img/daq-energy/astra-sdr-connections.jpg
