MITHaystack/ASTRA/docs/hardware/img/daq-energy/astra-sdr-cpu-foil.jpg

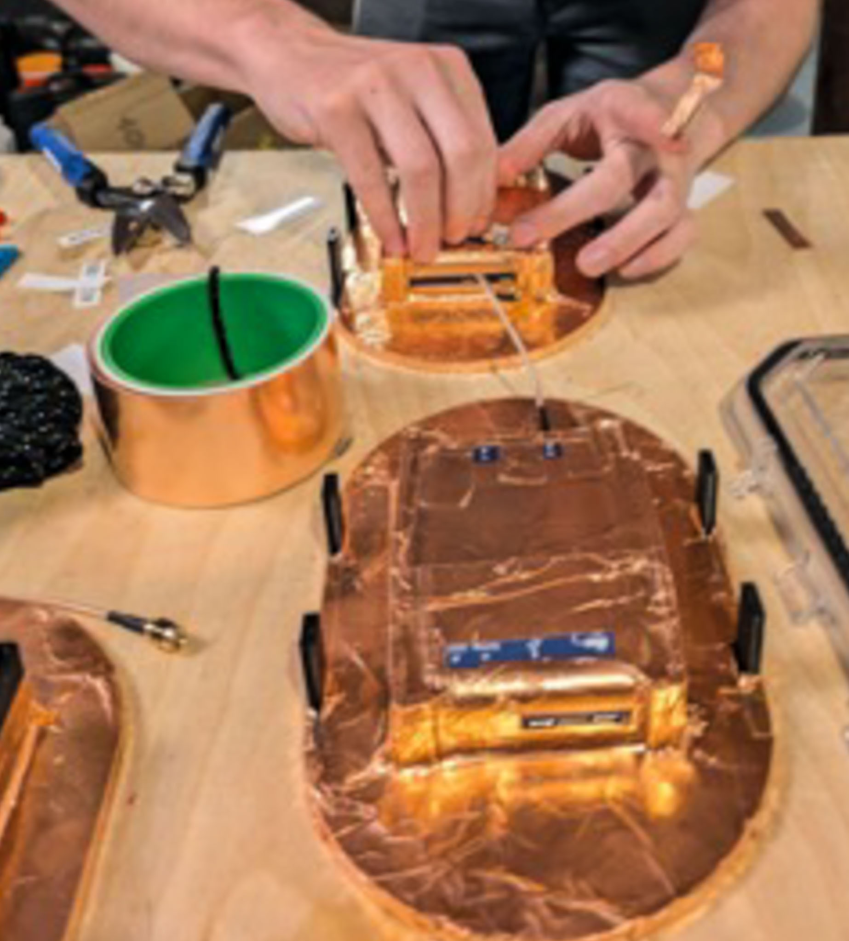
docs/hardware/img/daq-energy/astra-sdr-cpu-foil.jpg
