MITHaystack/ASTRA/docs/hardware/img/daq-energy/astra-sdr-foil1.jpg

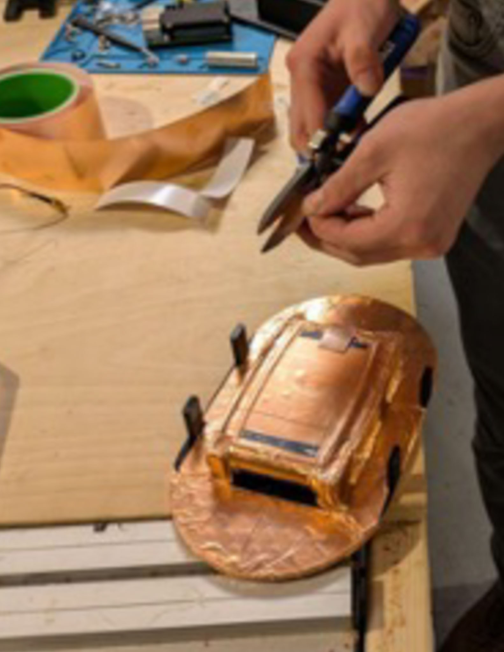
docs/hardware/img/daq-energy/astra-sdr-foil1.jpg
