MITHaystack/ASTRA/docs/hardware/img/daq-energy/daq-drill2.jpg

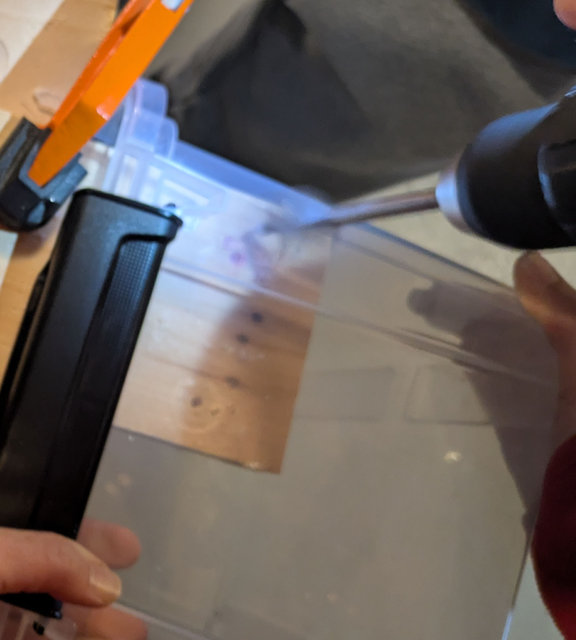
docs/hardware/img/daq-energy/daq-drill2.jpg
