MITHaystack/ASTRA/docs/hardware/img/daq-energy/daq-drill3.jpg

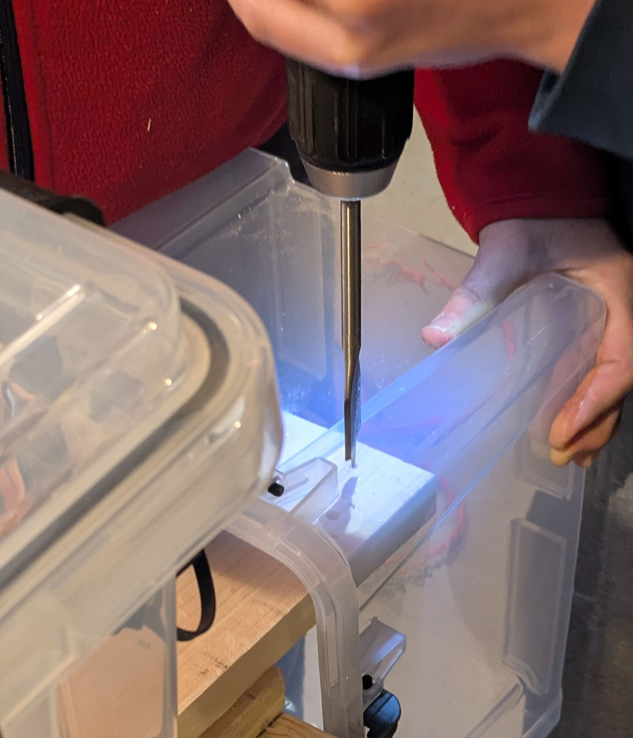
docs/hardware/img/daq-energy/daq-drill3.jpg
