MITHaystack/ASTRA/docs/hardware/img/daq-energy/daq-drill-marking2.jpg

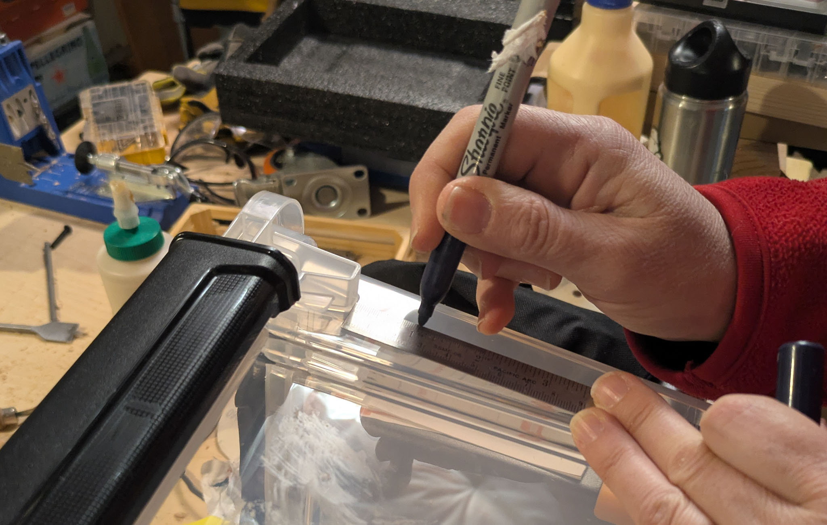
docs/hardware/img/daq-energy/daq-drill-marking2.jpg
