MITHaystack/ASTRA/docs/hardware/img/daq-energy/daq-drill-marking.jpg

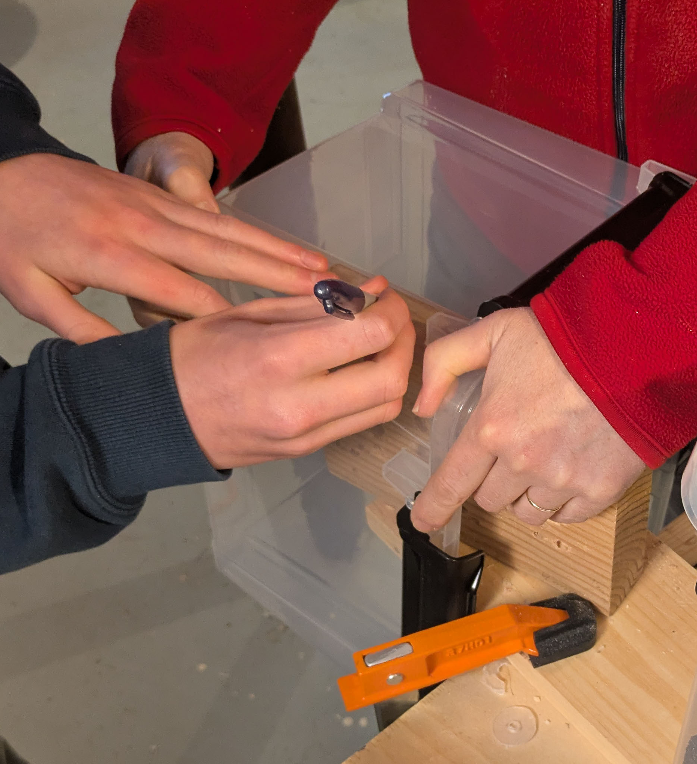
docs/hardware/img/daq-energy/daq-drill-marking.jpg
