MITHaystack/ASTRA/docs/hardware/img/daq-energy/daq-entry-drill1.jpg

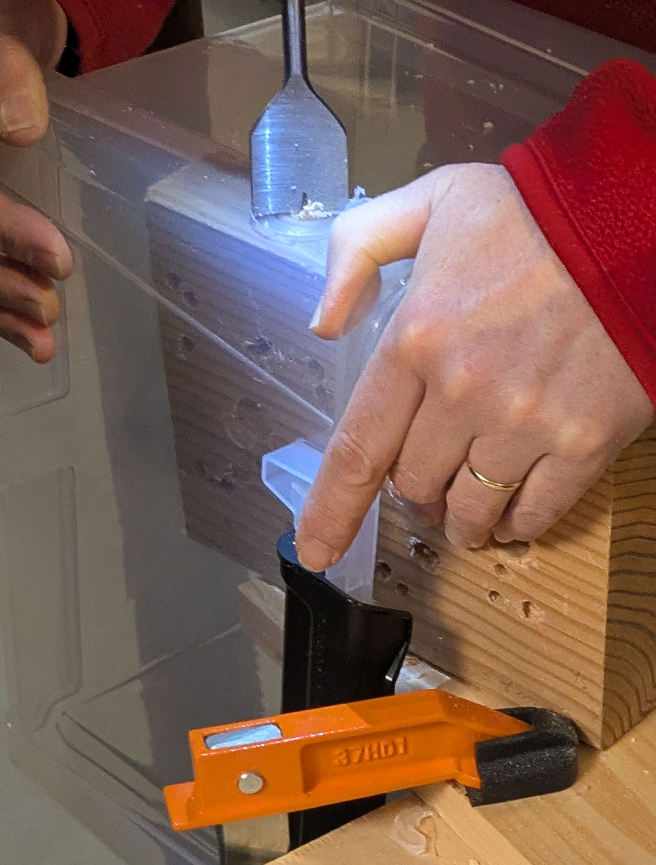
docs/hardware/img/daq-energy/daq-entry-drill1.jpg
