MITHaystack/ASTRA/docs/hardware/img/daq-energy/daq-eu1.jpg

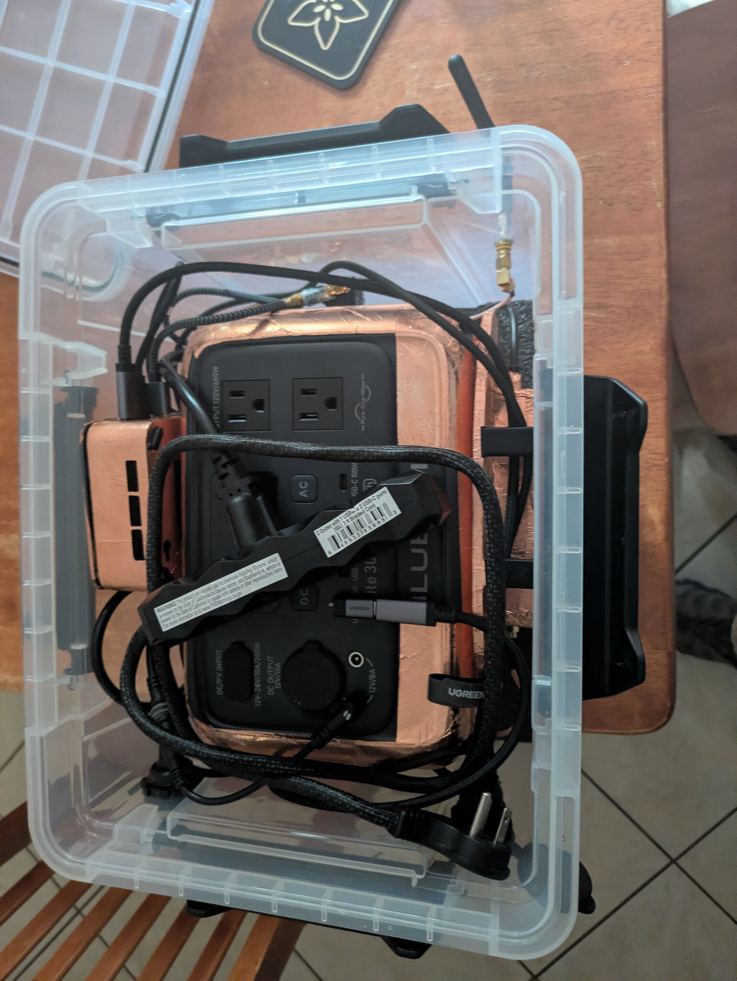
docs/hardware/img/daq-energy/daq-eu1.jpg
