MITHaystack/ASTRA/docs/hardware/img/daq-energy/daq-eu2.jpg

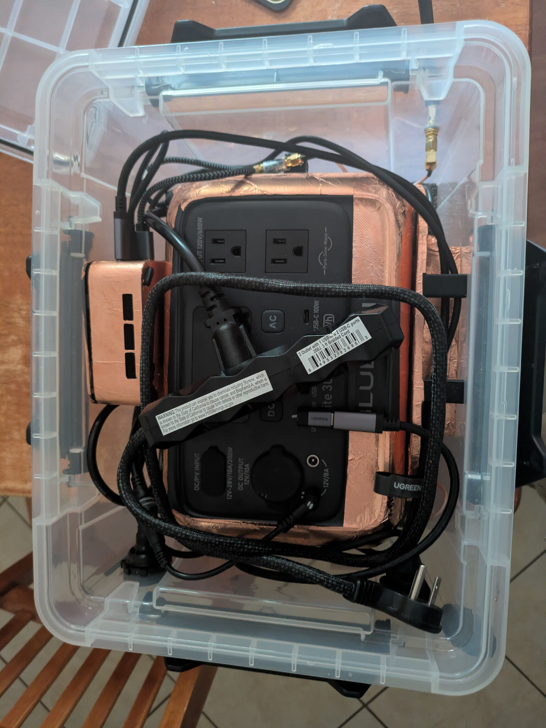
docs/hardware/img/daq-energy/daq-eu2.jpg
