MITHaystack/ASTRA/docs/hardware/img/daq-energy/daq-eu3.jpg

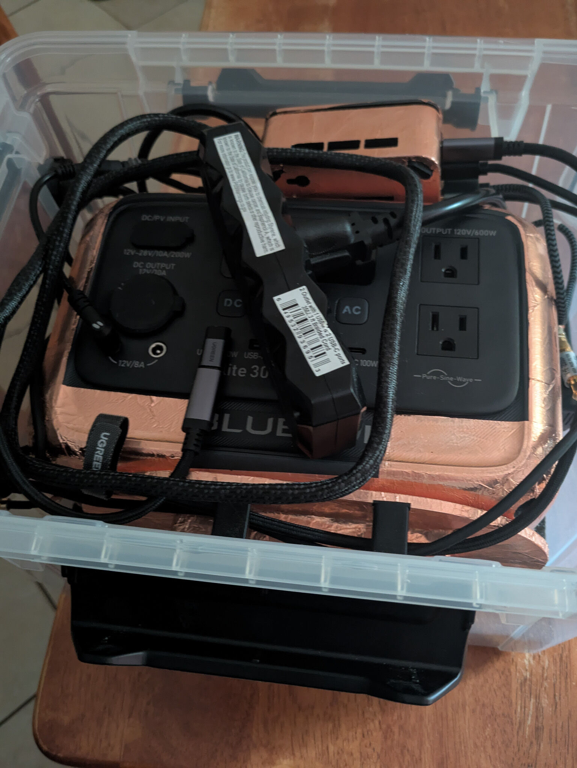
docs/hardware/img/daq-energy/daq-eu3.jpg
