MITHaystack/ASTRA/docs/hardware/img/daq-energy/daq-eu-cable-routing.jpg

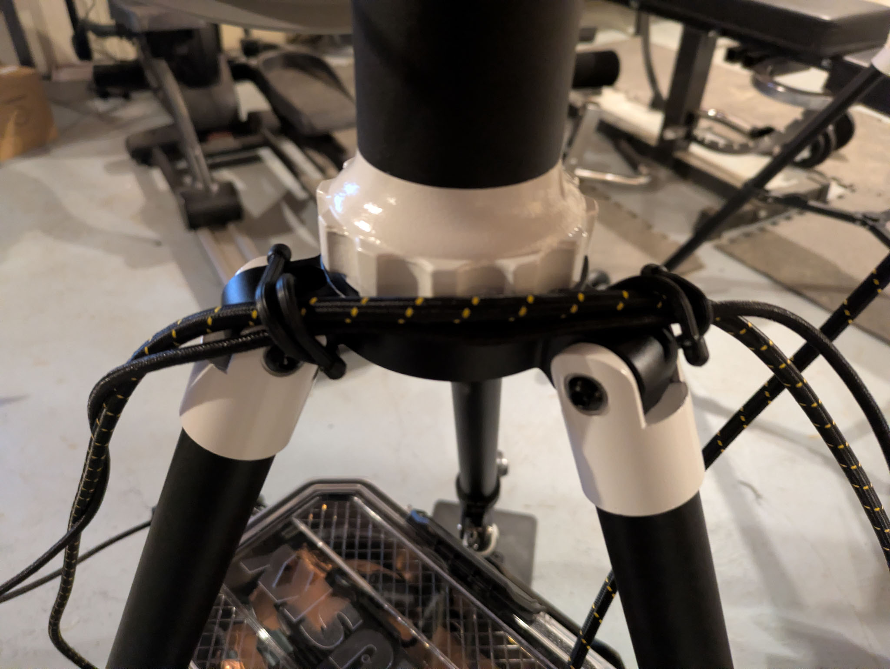
docs/hardware/img/daq-energy/daq-eu-cable-routing.jpg
