MITHaystack/ASTRA/docs/hardware/img/daq-energy/daq-eu-pecron-wired.jpg

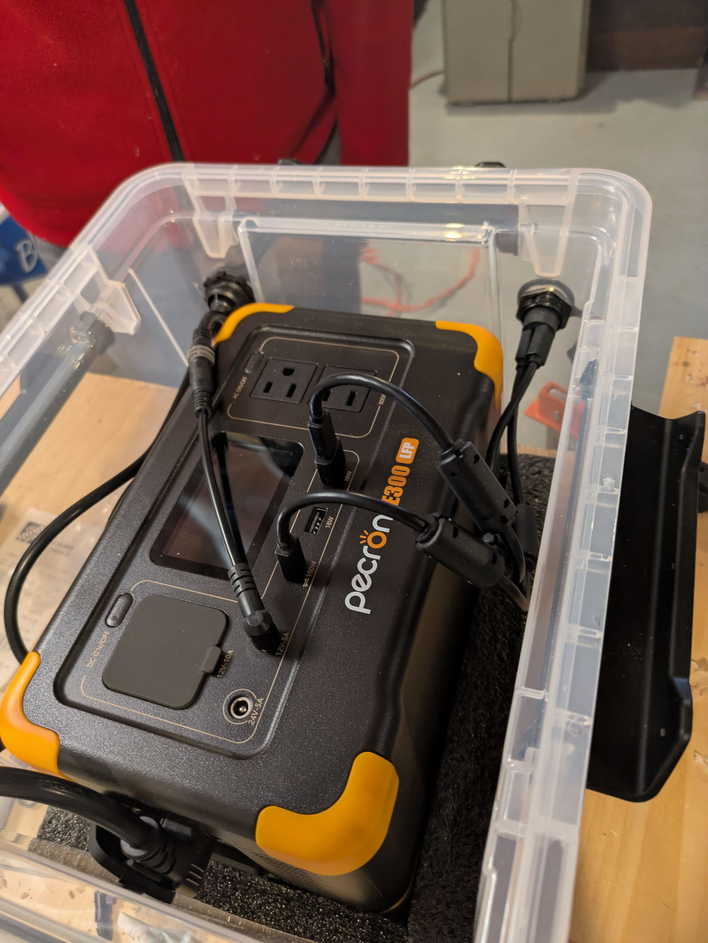
docs/hardware/img/daq-energy/daq-eu-pecron-wired.jpg
