MITHaystack/ASTRA/docs/hardware/img/daq-energy/daq-eu-pectron-usb.jpg

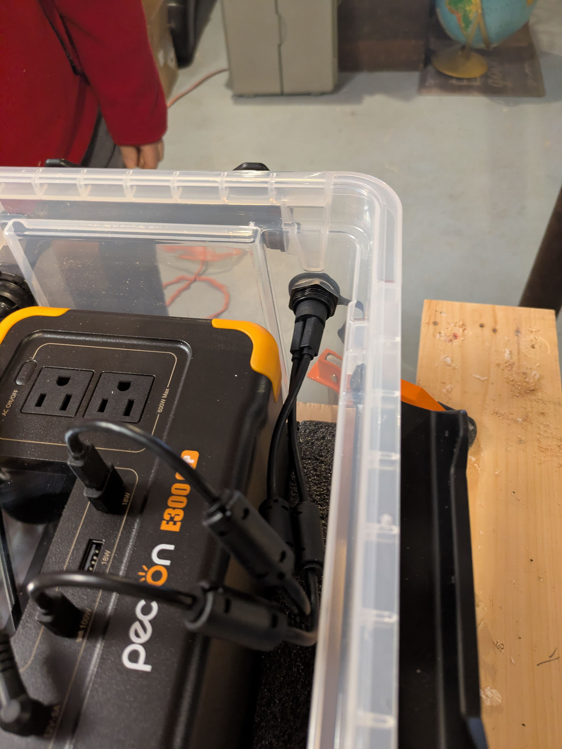
docs/hardware/img/daq-energy/daq-eu-pectron-usb.jpg
