MITHaystack/ASTRA/docs/hardware/img/daq-energy/daq-eu-power-entry.jpg

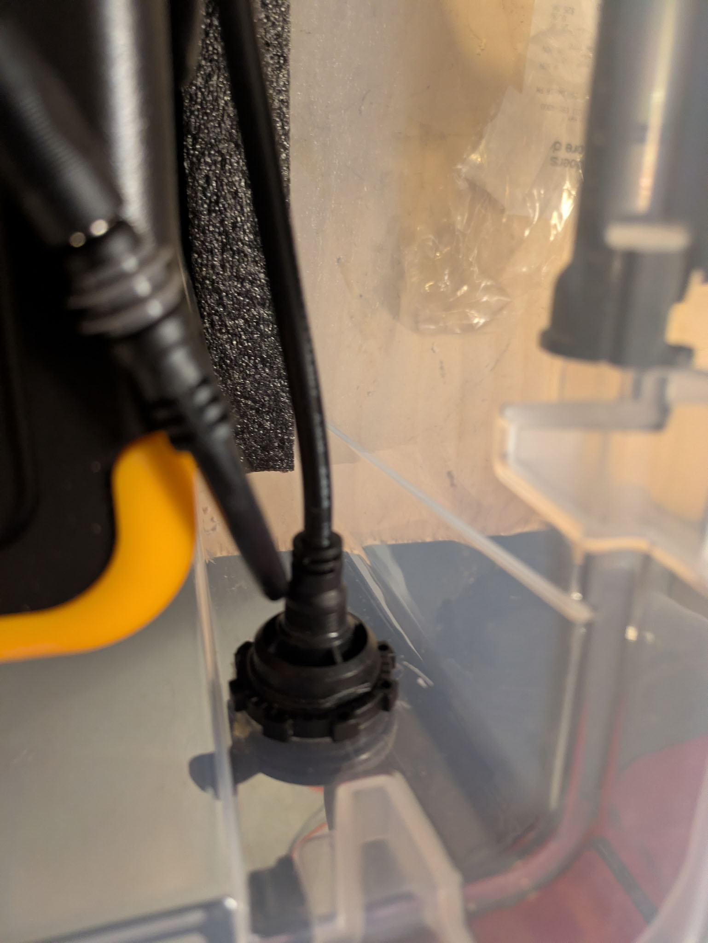
docs/hardware/img/daq-energy/daq-eu-power-entry.jpg
