MITHaystack/ASTRA/docs/hardware/img/daq-energy/daq-eu-usb-entry.jpg

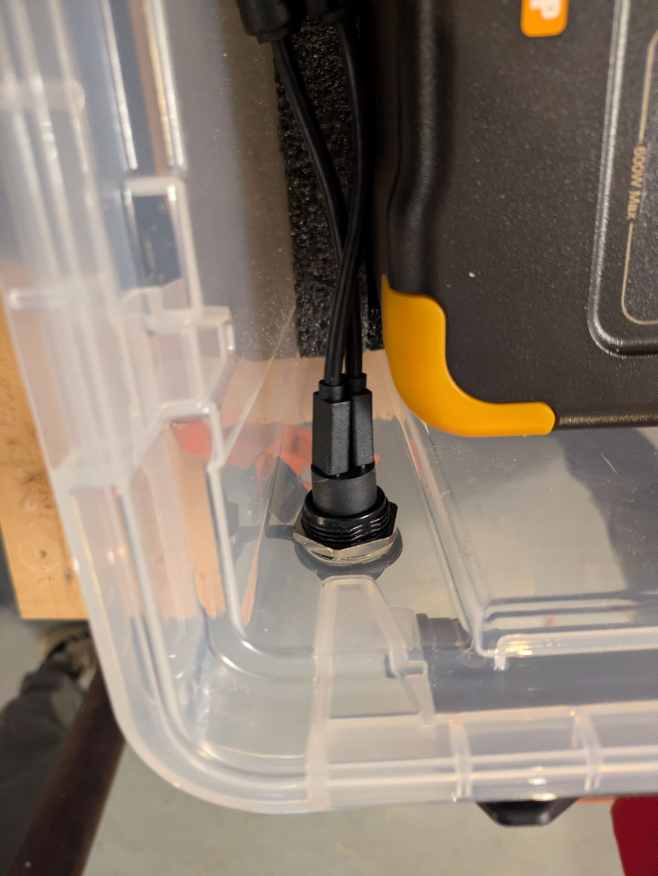
docs/hardware/img/daq-energy/daq-eu-usb-entry.jpg
