MITHaystack/ASTRA/docs/hardware/img/daq-energy/daq-sdr-bracket.jpg

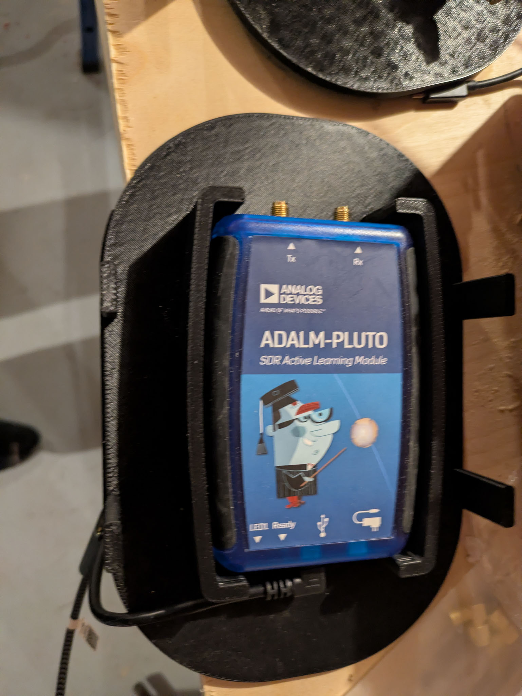
docs/hardware/img/daq-energy/daq-sdr-bracket.jpg
