MITHaystack/ASTRA/docs/hardware/img/daq-energy/daq-usb-entry-close.jpg

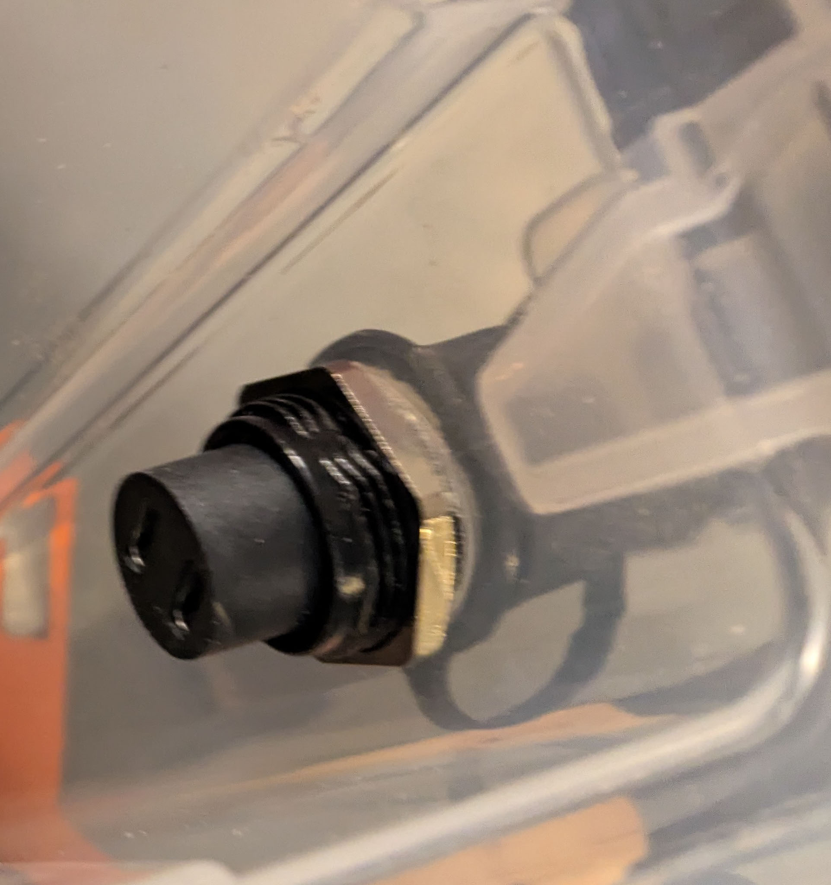
docs/hardware/img/daq-energy/daq-usb-entry-close.jpg
