MITHaystack/ASTRA/docs/hardware/img/mount/mount-attachment.jpg

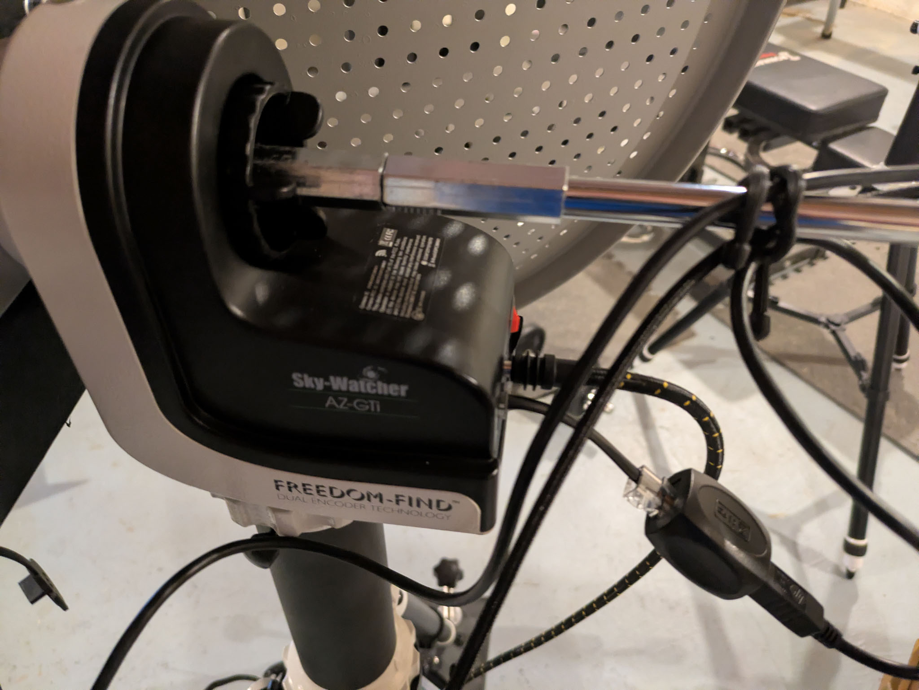
docs/hardware/img/mount/mount-attachment.jpg
