MITHaystack/ASTRA/docs/hardware/img/mount/mount-bracket-aiu-attach.jpg

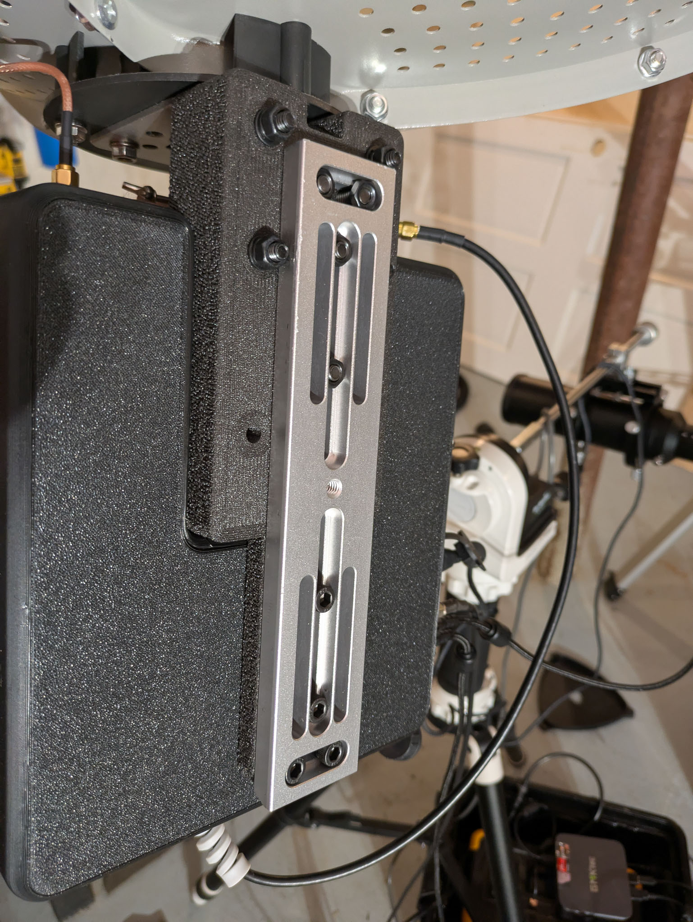
docs/hardware/img/mount/mount-bracket-aiu-attach.jpg
