MITHaystack/ASTRA/docs/hardware/img/mount/mount-bracket-dovetail-attach2.jpg

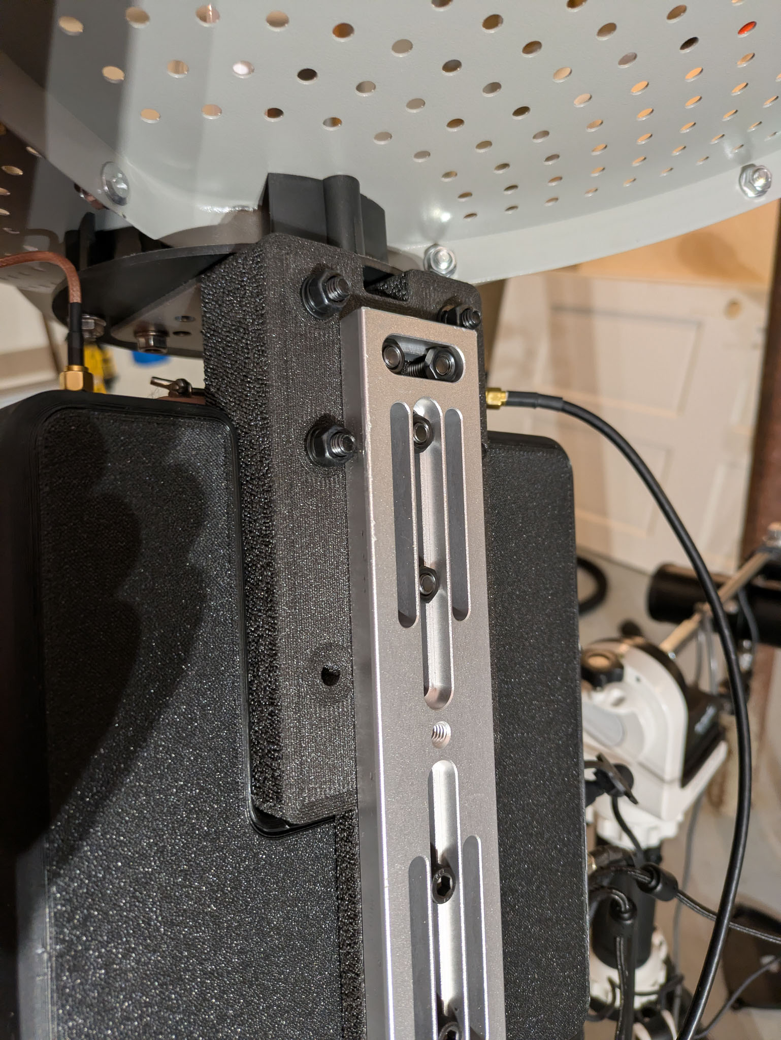
docs/hardware/img/mount/mount-bracket-dovetail-attach2.jpg
