MITHaystack/ASTRA/docs/hardware/img/mount/mount-bracket-dovetail-attach.jpg

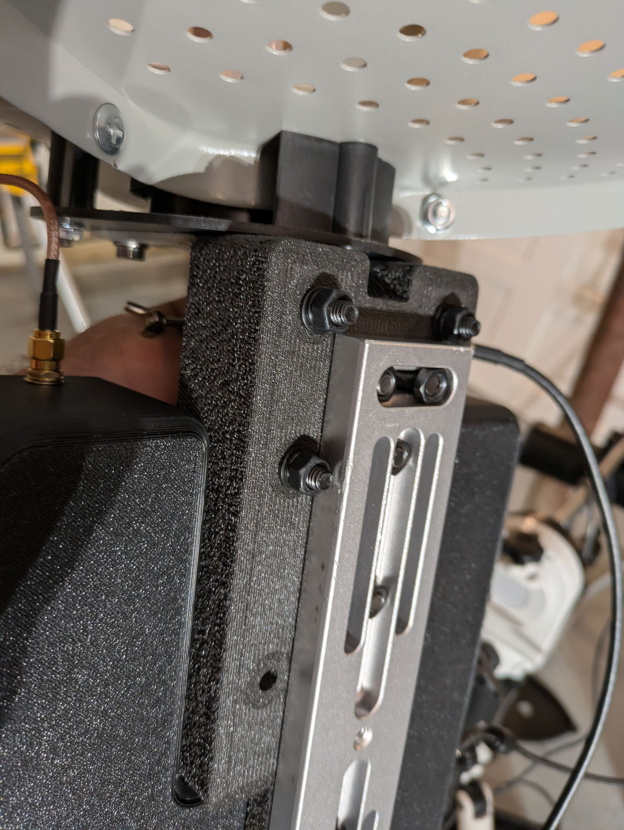
docs/hardware/img/mount/mount-bracket-dovetail-attach.jpg
