MITHaystack/ASTRA/docs/hardware/img/mount/mount-cables.jpg

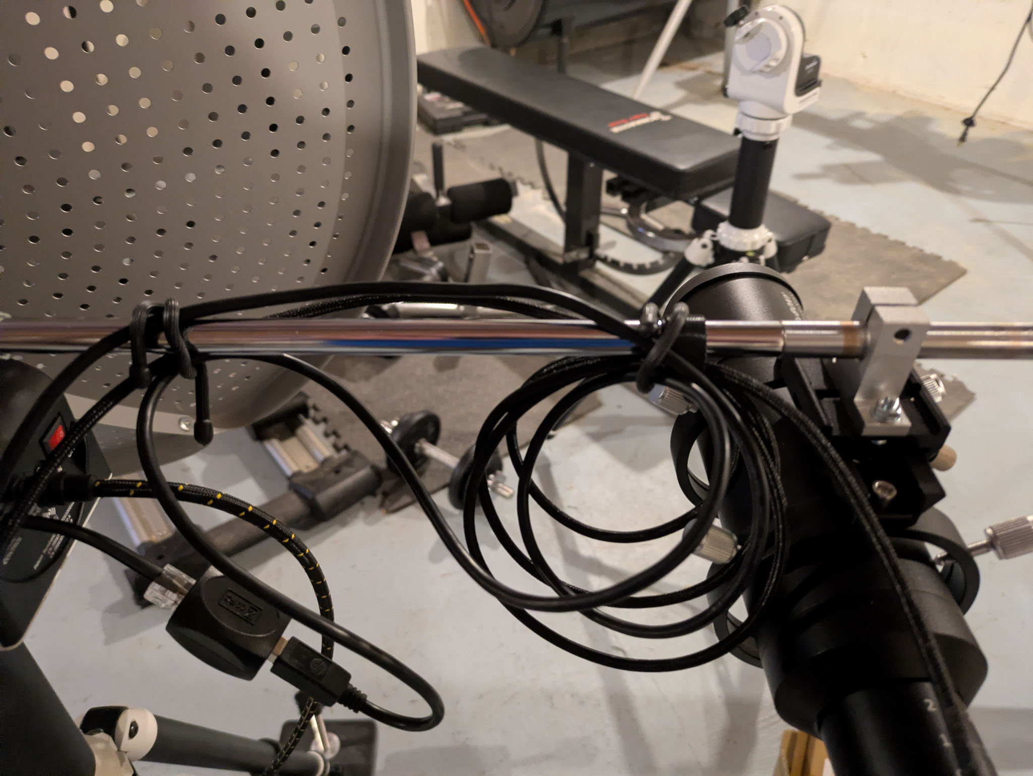
docs/hardware/img/mount/mount-cables.jpg
