MITHaystack/ASTRA/docs/hardware/img/mount/mount-connections.jpg

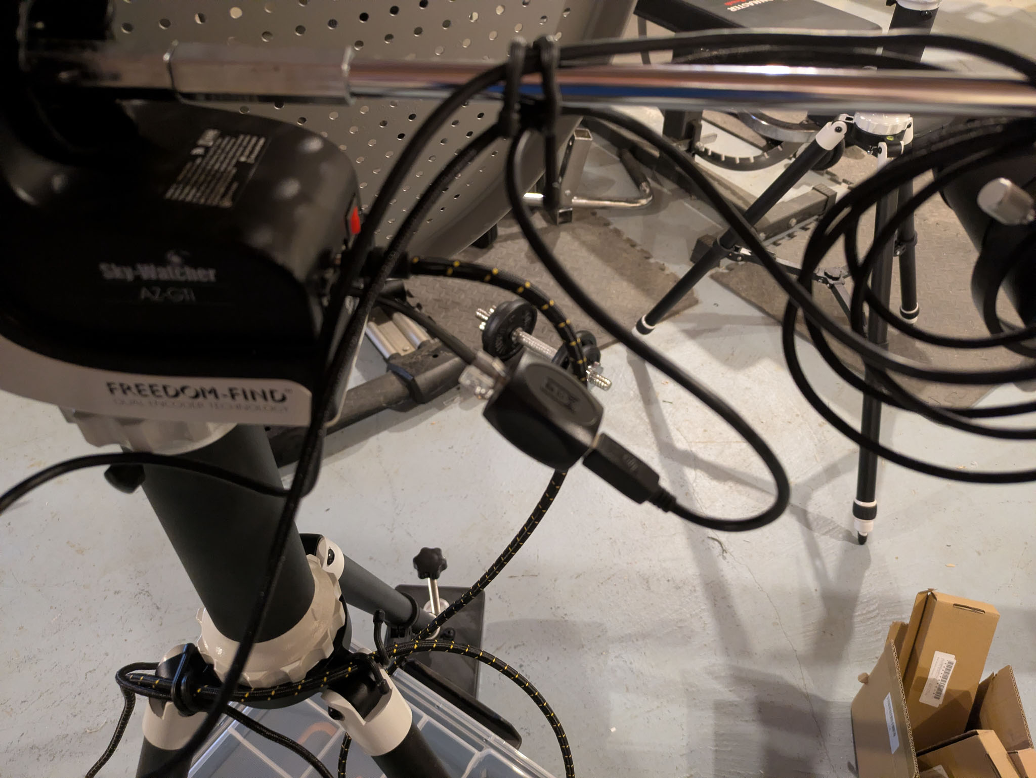
docs/hardware/img/mount/mount-connections.jpg
