MITHaystack/ASTRA/docs/hardware/img/mount/mount-dovetail-attachment.jpg

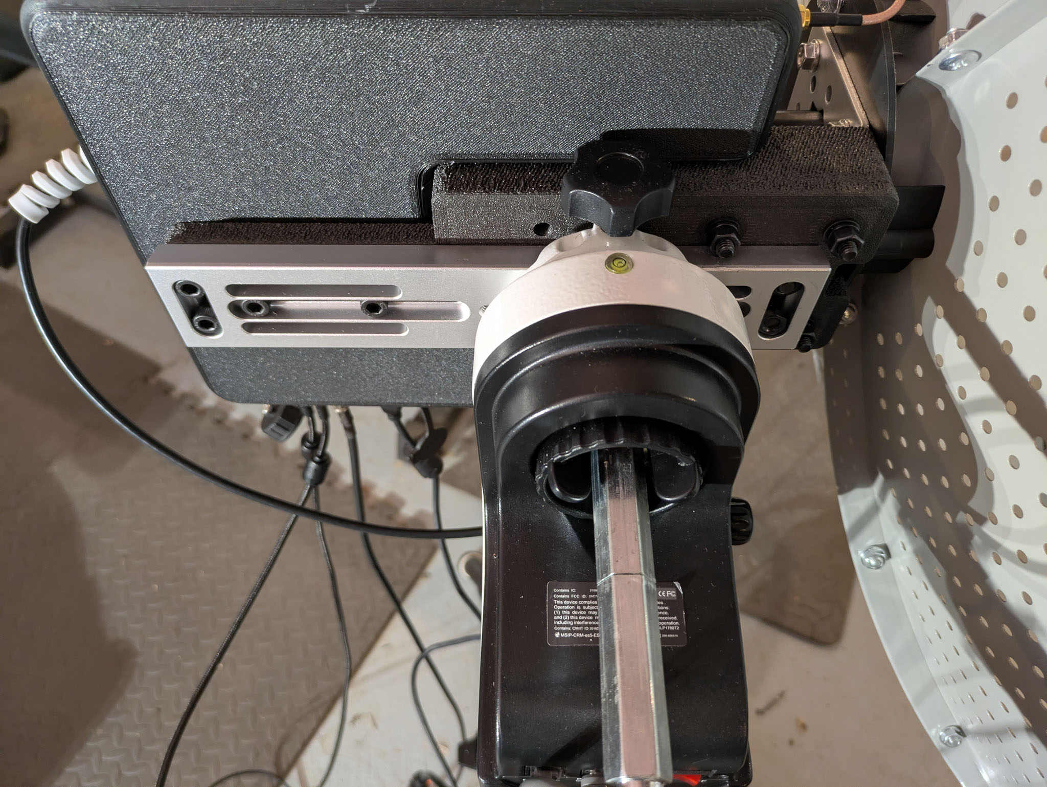
docs/hardware/img/mount/mount-dovetail-attachment.jpg
