MITHaystack/ASTRA/docs/hardware/img/mount/mount-dovetail-orientation.jpg

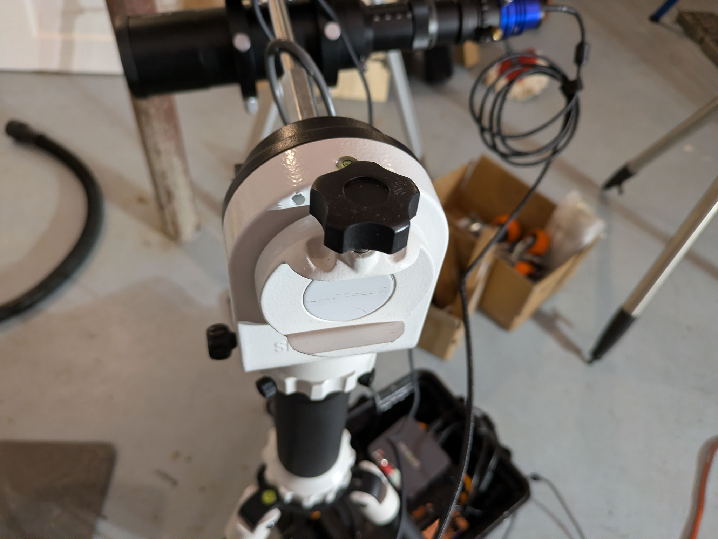
docs/hardware/img/mount/mount-dovetail-orientation.jpg
