MITHaystack/ASTRA/docs/hardware/img/mount/mount-level-attached.jpg

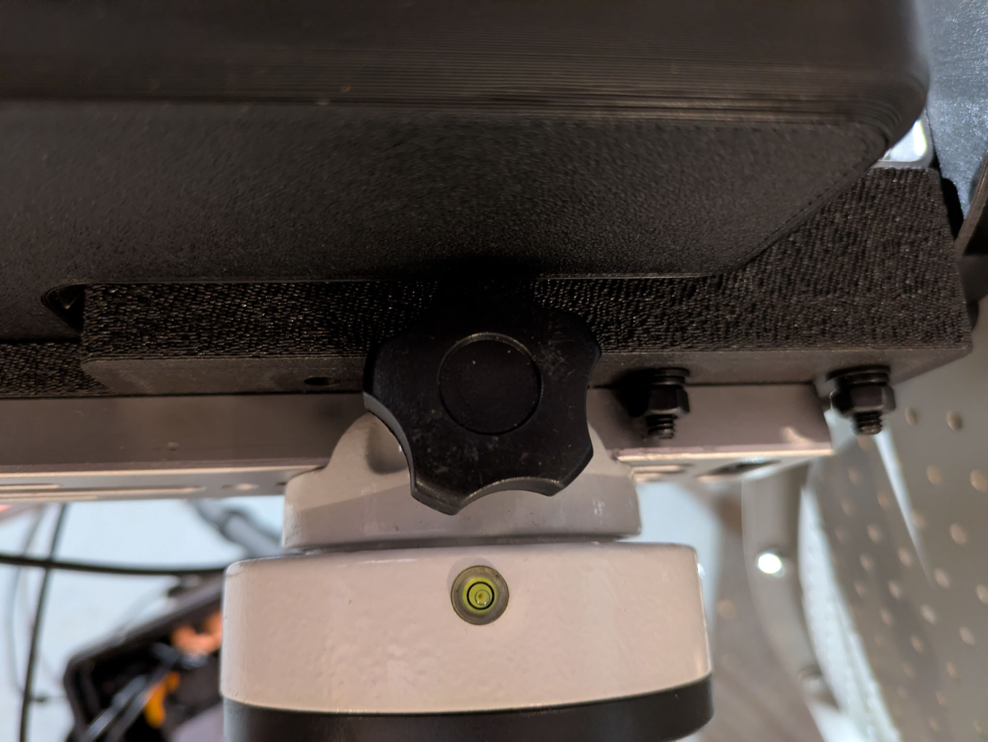
docs/hardware/img/mount/mount-level-attached.jpg
