MITHaystack/ASTRA/docs/hardware/img/mount/mount-transport-ready.jpg

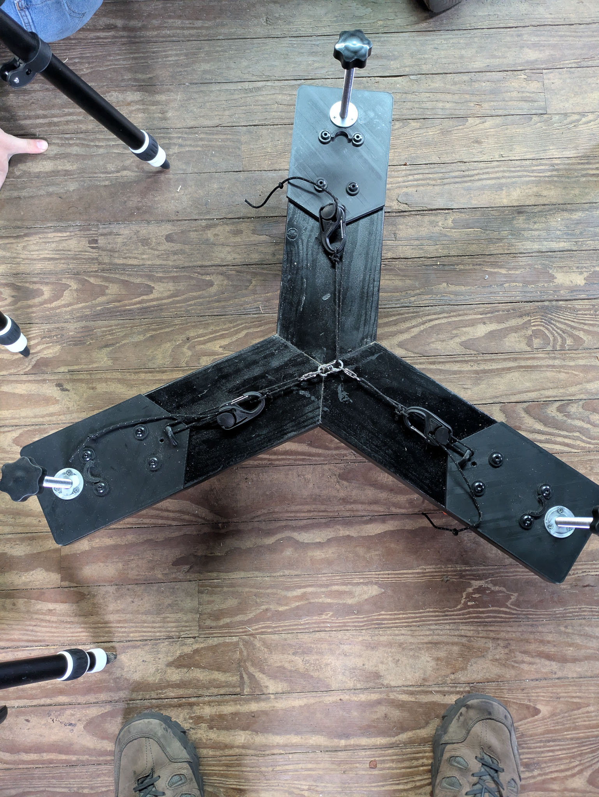
docs/hardware/img/mount/mount-transport-ready.jpg
