MITHaystack/ASTRA/docs/hardware/img/mount/mount-tripod-attachment.jpg

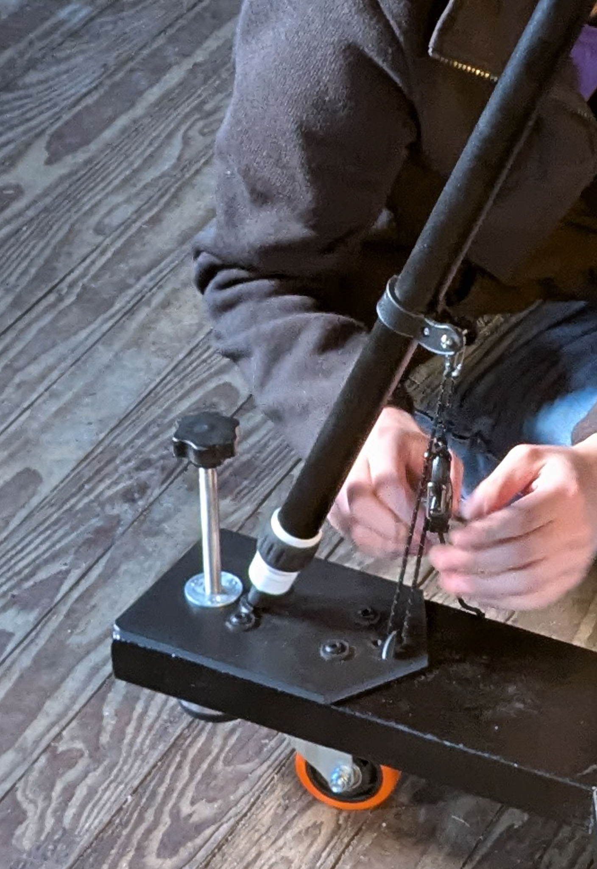
docs/hardware/img/mount/mount-tripod-attachment.jpg
