MITHaystack/ASTRA/docs/hardware/img/mount/mount-with-camera.jpg

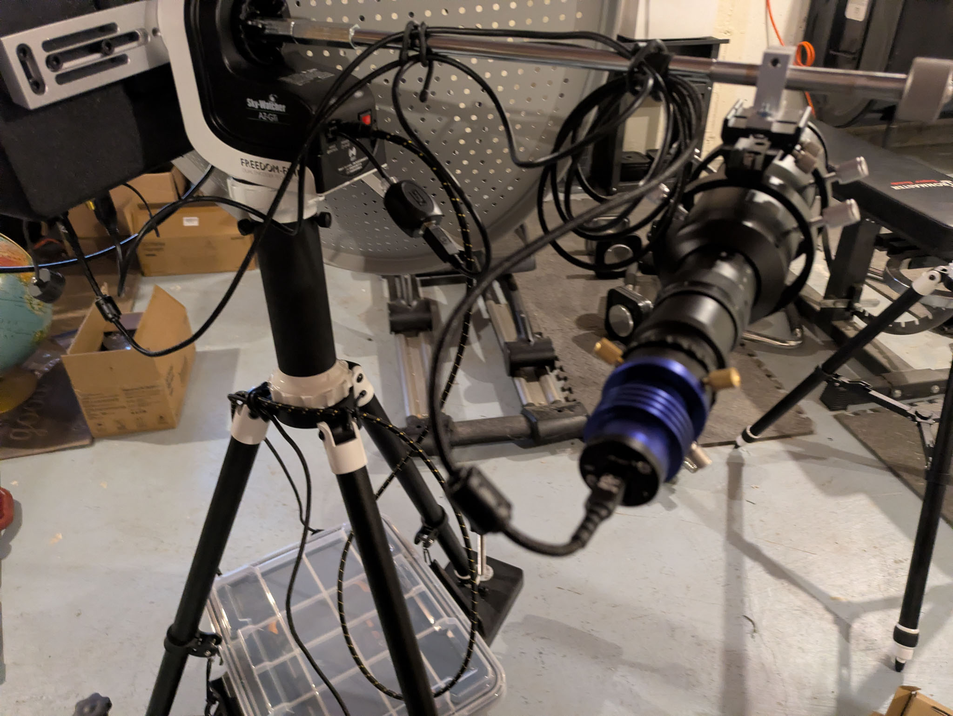
docs/hardware/img/mount/mount-with-camera.jpg
