MITHaystack/ASTRA/docs/hardware/img/optical/optical-focus-length.jpg

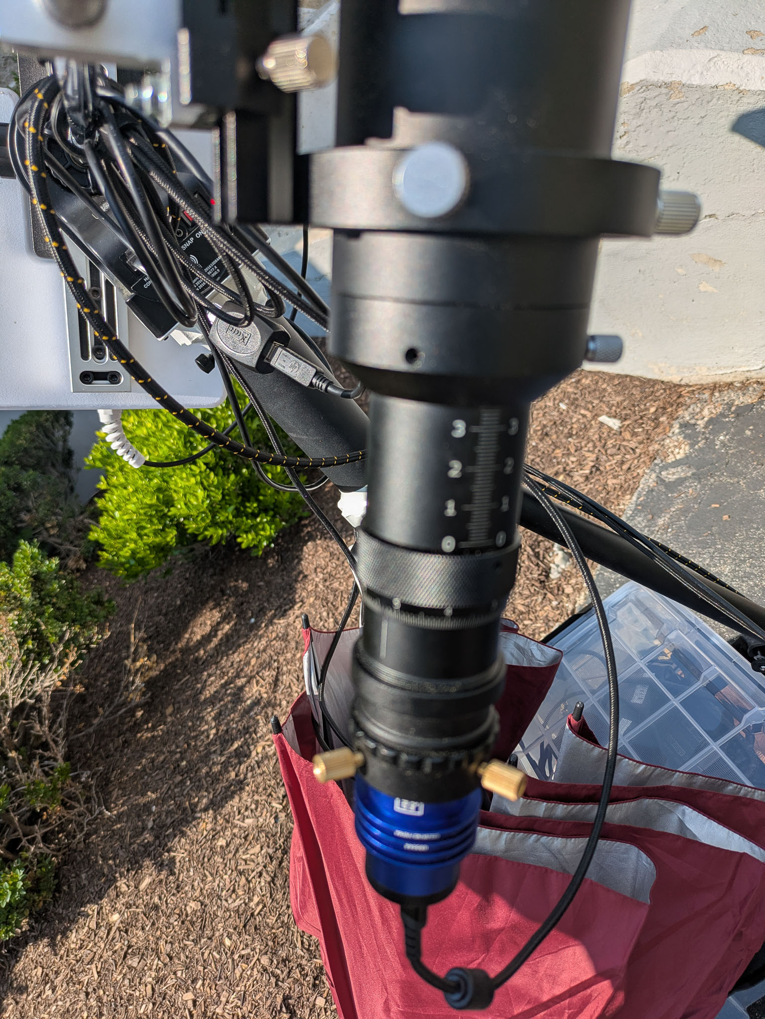
docs/hardware/img/optical/optical-focus-length.jpg
