MITHaystack/ASTRA/docs/hardware/img/optical/optical-imager-configuration.jpg

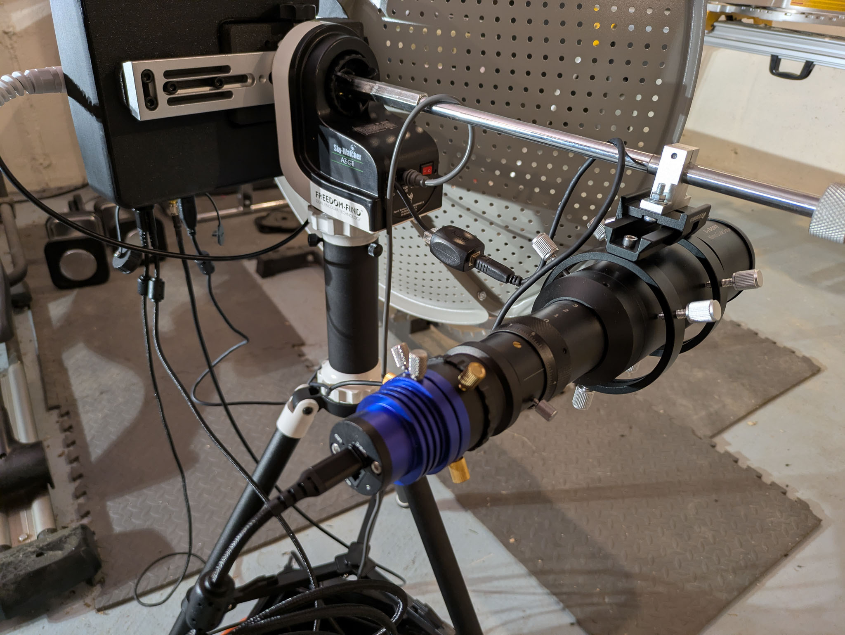
docs/hardware/img/optical/optical-imager-configuration.jpg
