MITHaystack/ASTRA/docs/hardware/img/optical/optical-level.jpg

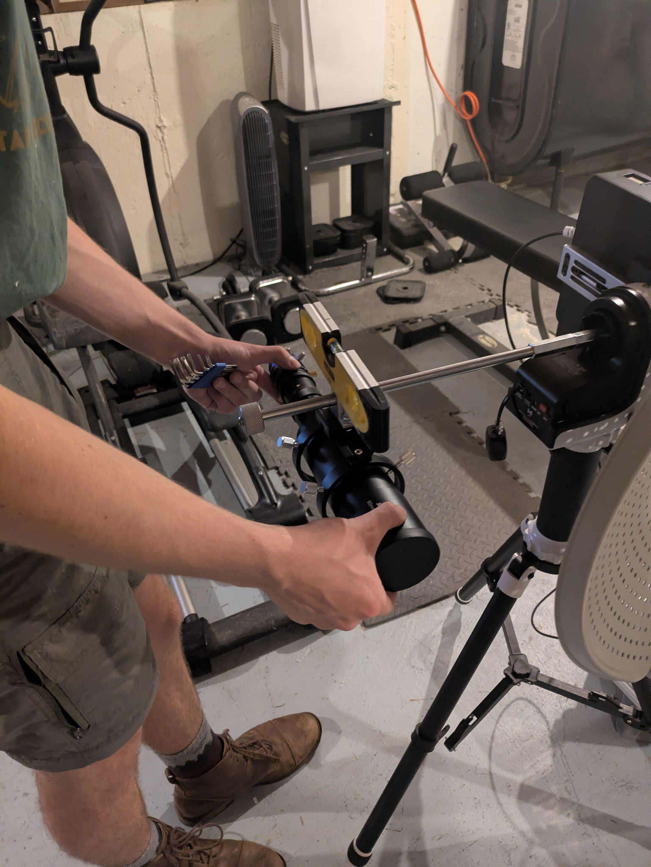
docs/hardware/img/optical/optical-level.jpg
