MITHaystack/ASTRA/docs/hardware/img/system/astra-and-srt.jpg

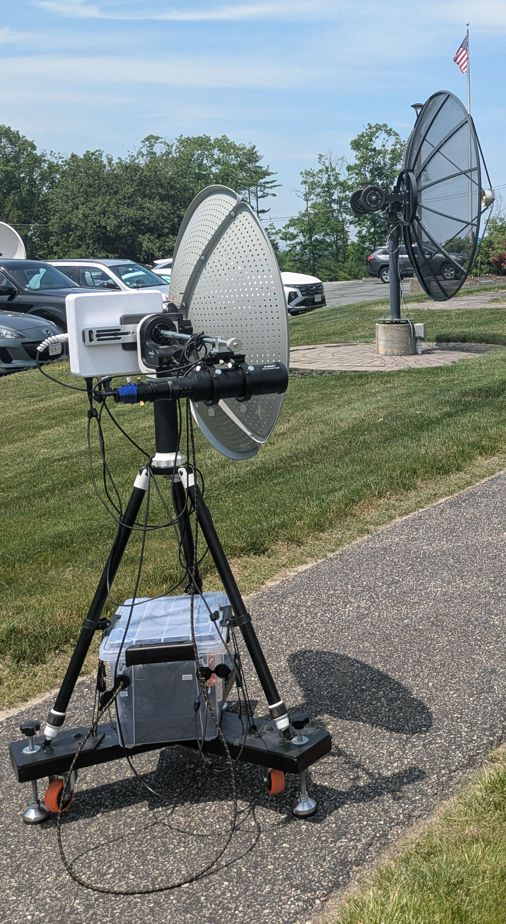
docs/hardware/img/system/astra-and-srt.jpg
