MITHaystack/ASTRA/docs/hardware/img/system/astra-front.jpg

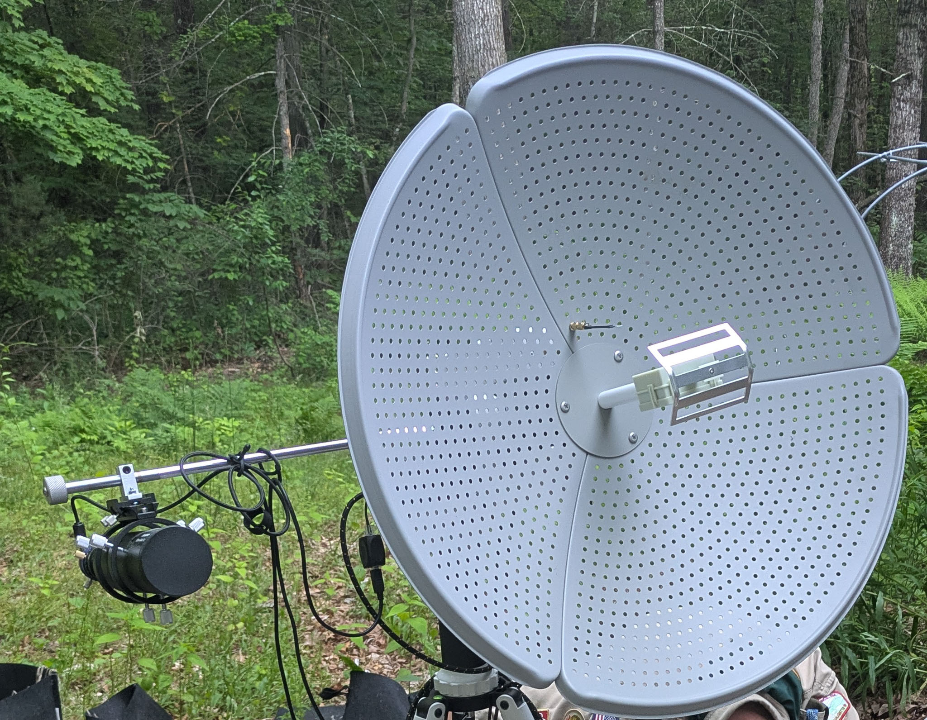
docs/hardware/img/system/astra-front.jpg
