MITHaystack/ASTRA/docs/hardware/img/system/astra-leveling2.jpg

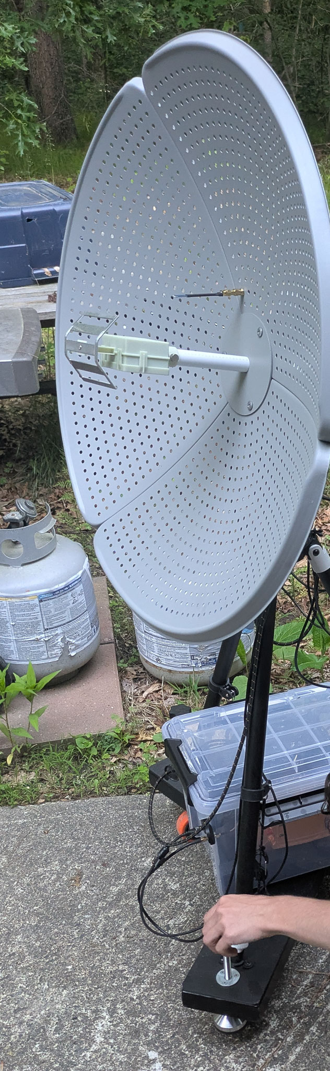
docs/hardware/img/system/astra-leveling2.jpg
