MITHaystack/ASTRA/docs/hardware/img/system/astra-leveling.jpg

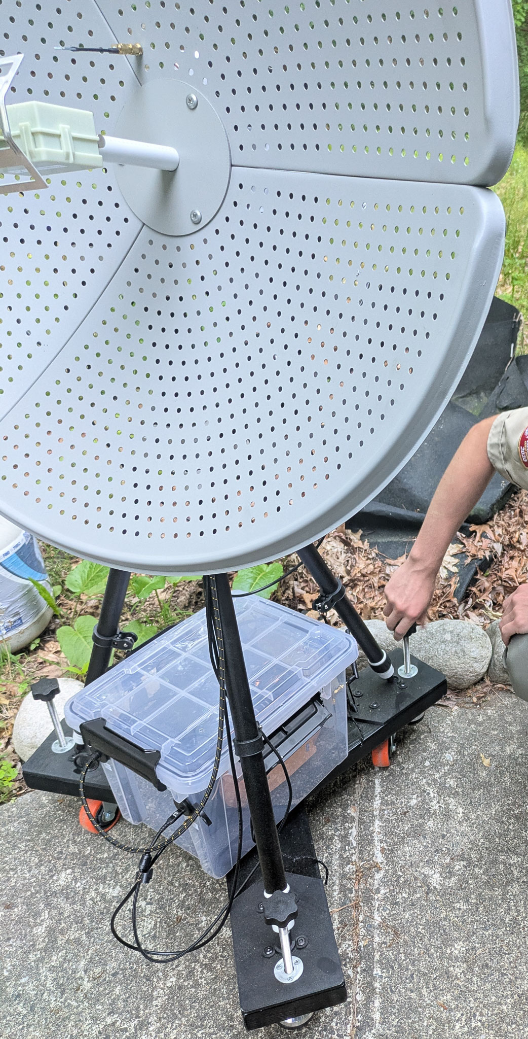
docs/hardware/img/system/astra-leveling.jpg
