MITHaystack/ASTRA/docs/hardware/img/system/astra-side.jpg

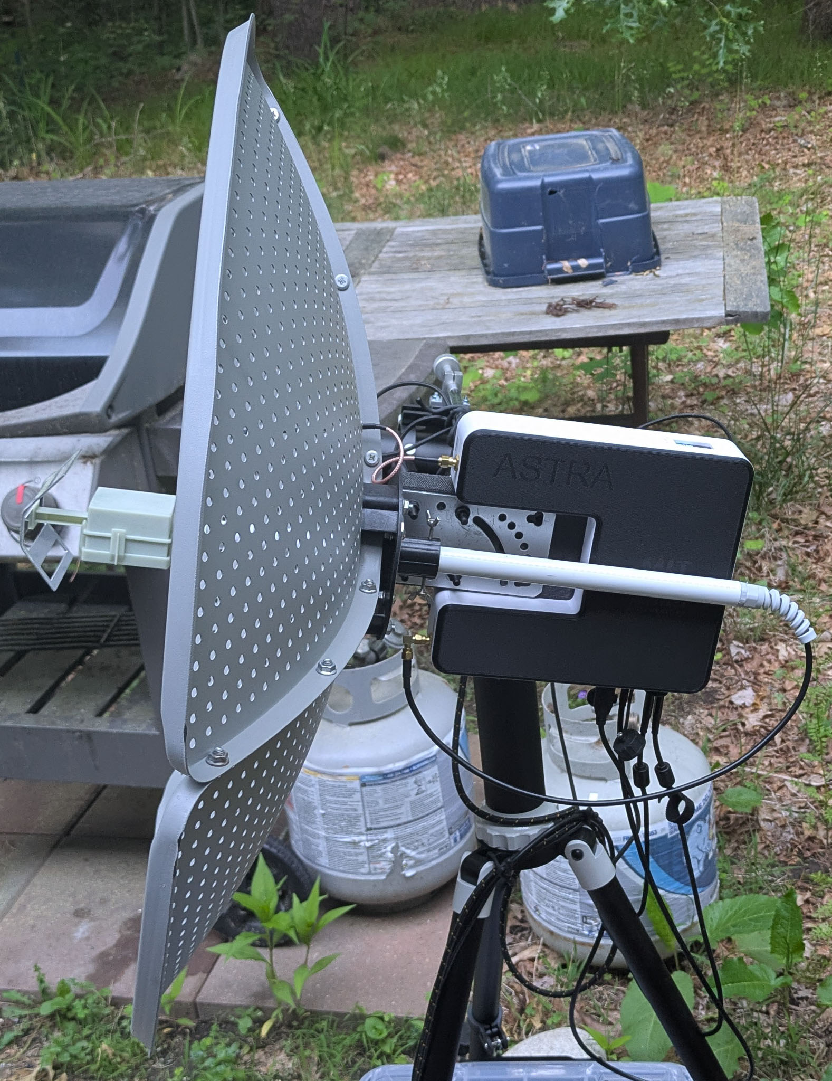
docs/hardware/img/system/astra-side.jpg
