MITHaystack/ASTRA/docs/hardware/img/system/astra-system-aligning.jpg

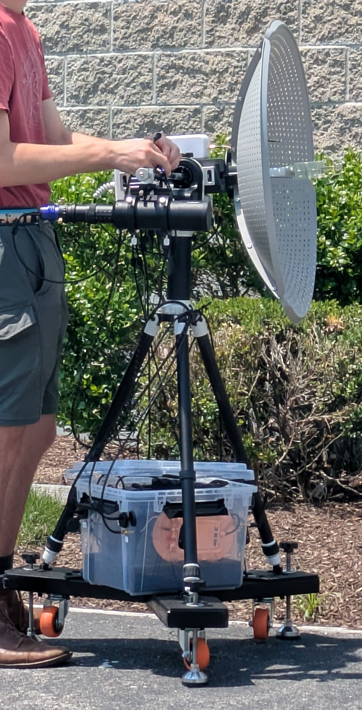
docs/hardware/img/system/astra-system-aligning.jpg
