MITHaystack/ASTRA/docs/observations/img/astra-polaris-hline.png

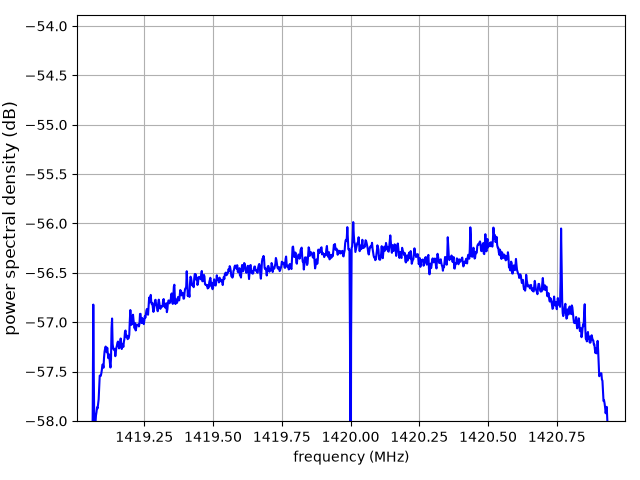
docs/observations/img/astra-polaris-hline.png
