MITHaystack/ASTRA/docs/hardware/bom/astra-bom.csv

 |  | ASTRA Design Options |  |  |  | $2,985
 |  |  |  | Production Unit
Production Ordered | Single Unit Cost | Subsystem | Component | Brand | Model | Cost
 | For Donations
 |  | Mount |  |  |  |  | $717.40
 |  |  | Tripod trolley | Custom from Wood | Custom Build | 50 |  | https://www.cloudynights.com/forums/topic/753718-another-scope-dolly-build/
X | $10 |  | Kreg Screws | Amazon or Depot | Pocket hole screw #8 2 1/2" | $10 |  | https://www.amazon.com/dp/B0CJBWCZ4D/
x | $9 |  | 1/4 - 20 bolt 2 1/2 inches | Amazon or Depot | 1/4-20 x 2-1/2" Flat Head Hex Socket Cap Screws, 304 Stainless Steel 18-8 Furniture Bolts, Black Zinc Finish | $9 |  | https://www.amazon.com/dp/B0DG2C4XNN?ref=ppx_yo2ov_dt_b_fed_asin_title
x | $6 |  | 3/4" OD, 1/4" ID rubber washer | Amazon | Flat Rubber Washers for Bolts Spacers, 3/4" OD x 1/4" ID x 1/8 Inch Thickness | $6 |  | https://www.amazon.com/dp/B0BJPF9QMZ?ref=ppx_yo2ov_dt_b_fed_asin_title&th=1
x | $7 |  | 1/4" x 1 " stainless washer | Amazon | 1/4 x 1'' (50 Pack) Black Oxide Stainless Steel Fender Washers, 1'' OD, (18-8) | $7 |  | https://www.amazon.com/dp/B0FJ1FR5PM?ref=ppx_yo2ov_dt_b_fed_asin_title&th=1
x | $8 |  | 1/4 - 20 hexagon nuts | Amazon | 1/4''-20 (50 Pack) Hex Head Nuts, Black Oxide 304 Stainless Steel 18-8 Hexagon Nuts, | $8 |  | https://www.amazon.com/dp/B0FJ5DM8M3?ref=ppx_yo2ov_dt_b_fed_asin_title&th=1
x | $10 |  | 1/4 -20 nylon lock nuts | Amazon | 1/4-20 Nylon Insert Hex Lock Nuts Locknuts, 304 Stainless Steel 18-8, Black Oxide | $10 |  | https://www.amazon.com/dp/B0BY4XVN4B?ref=ppx_yo2ov_dt_b_fed_asin_title&th=1
 | $0 |  | 3D printed trolley guides / brackets | PLA | Custom 3D print | $3 |  | Used for marking base wood for cutting
X | $20 |  | 3 inch casters with double lock | Amazon | WBD WEIBIDA 3 Inch Swivel Caster Wheels with Brake, Safety Dual Locking | $20 |  | https://www.amazon.com/dp/B0FQBXW8WF?ref=ppx_yo2ov_dt_b_fed_asin_title&th=1
X | $31 |  | M12 leveler feed with removable bolt | Amazon | D60xM12x50mm leveler foot | $24 |  | https://www.amazon.com/dp/B0F48FN6ZR?ref=ppx_yo2ov_dt_b_fed_asin_title&th=1
X | $23 |  | M12 x 1.75 200mm bolt | Amazon | M12x1.75x200mm hex head screw bolt | $23 |  | https://www.amazon.com/dp/B0FBR87XKY?ref=ppx_yo2ov_dt_b_fed_asin_title
X | $4 |  | M12 T-Nut | Amazon | M12 carbon steel round base screw in Tnut | $4 |  | https://www.amazon.com/dp/B0D6R3MKWF?ref=ppx_yo2ov_dt_b_fed_asin_title&th=1
X | $15 |  | M12 Handle for rod | Amazon | M12 star shaped clamping handle | $15 |  | https://www.amazon.com/dp/B07QC15F6J?ref=ppx_yo2ov_dt_b_fed_asin_title
X | $38 |  | Conterweight bar and end | Counterweight end | BR13, BN12, BR124 | $38
X | $26 |  | Dovetail mount (vixen rail) | Amazon | Astromainia dovetail | $26 |  | https://www.amazon.com/Astromania-Deluxe-Dovetail-Plate-Length/dp/B01LZ377Z1
 |  |  | 3d printed dovetail to antenna bracket | PETG-CF | Custom 3D print | $4
X | $525 |  | Goto Mount and Tripod | Skywatcher | AZ-GTi | $440 |  | ML-33 with Logo for Haystack Donation Version / Larger Dish
X | $9 |  | Mini Stainless Carbiner (3 per base) | Nite Ize / Amazon | S-beaner micro lock | 9 |  | https://www.amazon.com/dp/B082YS61HB?ref=ppx_yo2ov_dt_b_fed_asin_title&th=1
X | $12 |  | CamJam tensioner (3 per base) | Nite Ize / Amazon | Camjam | 12 |  | https://www.amazon.com/dp/B082YS61HB?ref=ppx_yo2ov_dt_b_fed_asin_title&th=1
 |  | Enclosure |  |  |  |  | $306
X | $82 | Must be metal lined | Battery Enclosure | Sterilite | 19qt gasket box clear | $12 |  | https://www.gregory.com/gear-organization/gear-boxes/alpaca-gear-box-25/157817XXXX.html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
 | $4 |  | 3D Printed Bracket (filament cost) | 3D Print Home | Custom 3D Box Brackets | $10 |  | Used to hold battery enclosure on base
 | $10 |  | MISC items / cable management | N/A | MISC (e.g. zip ties, etc) | $10
X | $9 |  | SMA to RPSMA Adapter Kit | Amazon / Superbat | Superbat SMA Female/Male to RP-SMA Female/Male RF Coaxial Coax Adapter | $9
X | $8 |  | SMA Coax Cable RG 402 | Amazon | 15cm SMA Male to Male Coaxial Cable 6" RG405 50 Ohm | $8 |  | https://www.amazon.com/POBADY-Coaxial-Cable-Pigtail-Extension/dp/B0CDGQP84J
X | $7 |  | SMA Feedthrough Bulkhead w/gasket | Amazon | SMA Bulkhead Adapter Female Coupler 2-Pack Waterproof | $7 |  | https://www.amazon.com/exgoofit-Waterproof-Bulkhead-Connetor-Antennas/dp/B0D66Y7C6J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
X | $20 | Seal internally with EMI tape | DC Power for Mount | Amazon | Starlink Mini 5521 RV entry | $20 |  | Waterproof Wall Socket Passthrough for Starlink Mini, Aluminum DC 5.5 x 2.1 | https://www.amazon.com/Waterproof-5521Connector-Replacement-Satellite-Campervan/dp/B0GM1BJMSB
x | $36 | 3 | USB3 Dual Bulkhead C + C | Amazon | Penglin Dual USB C Panel Mount | $36
x | $9 |  | 5525 to 5521 DC converter | Amazon | DC5.5X 2.1mm Female to DC 5.5X 2.5mm Male Power Extension Cable 90 Degree Right Angle DC 5525 Male | $9 |  | https://www.amazon.com/HCFeng-Extension-DC5521Female-Security-Monitor/dp/B0C2KQYL91
X | $26 |  | 12V DC Cable 5521 to 5521 | Amazon | Starlink braided 5521 DC / DC Cable | $26 |  | https://www.amazon.com/gp/product/B0FWQ7TY77/ref=ewc_pr_img_1?smid=A16JE9YMQJ0G3W&th=1
X | $8 |  | USB Cable for biasT and LNA | Amazon | UCEC Dual Micro USB Splitter | $8 |  | https://www.amazon.com/UCEC-Splitter-Charge-Devices-Single/dp/B01713KLSY?s=electronics
X | $16 | 3 | USB Cable for SDR, WiFI, bias Split | Amazon | SUNGUY 5Gbps USB 3.0 Extension Cable, 1FT USB A Male to Female Extender Cord | $24
x | $26 | 5 | USB C to C cable for CPU to bulkhead, Battery to Bulkhead, RP2040 switch | Amazon / Digirig | Shielded Short USB-C to USB-C Cable with Ferrites | $26 |  | https://www.amazon.com/Shielded-Short-USB-C-Cable-Ferrites/dp/B0BJ1BF5YQ?srs=37071732011
x | $7 |  | USB A to C Adapters | Amazon / uGreen | UGREEN USB to USB C Adapter 3Pack, | $7 |  | https://www.amazon.com/UGREEN-Adapter-10Gbps-Converter-Samsung/dp/B0CY1Y3TSQ
x | $40 | 3 | USB C to C Cable with Ferrites (all external USB) | Amazon / Digirig | Shielded 2m USB-C to USB-C cable | $40 |  | https://www.amazon.com/Digirig-Shielded-USB-C-Cable-Ferrites/dp/B0FMC8V8J9?srs=37071732011
x | $13 |  | USB A 2.0 to C short | Amazon / Digirig | Shielded short USB A to C cable | $13 |  | https://www.amazon.com/Digirig-Shielded-Short-USB-C-Ferrites/dp/B0BJ182J9J
X | $4 |  | Short Outdoor Power Cable | Amazon | 1ft 12 gauge short outdoor extension cord | $4 |  | https://www.amazon.com/dp/B0DCYWGTHP?ref=ppx_yo2ov_dt_b_fed_asin_title
X | $7 |  | Short Indoor Right Angle Power Cable | Amazon | 1 ft NEMA 5-15 right angle power cable | $7 |  | https://www.amazon.com/dp/B0CC5M8Y2X?ref=ppx_yo2ov_dt_b_fed_asin_title
 |  |  | Power Extension Cord Reel (outdoor) | Home Depot | HDX 30 foot cord reel | $30
 |  | Power |  |  |  |  | $293
X | $149 | 6.1 inch height | LiFePO4 Battery Power Station | Bluetti | Elite 30 V2 | $219
X | $13 | EMI Copper Tape | copper foil tape for EMI | Amazon | 2 inch copper foil tape | $13 |  | https://www.amazon.com/dp/B0DY1BNSPL?ref=ppx_yo2ov_dt_b_fed_asin_title
X | $17 | EMI Faraday Cloth | 2" faraday EMI cloth | Amazon | 2" x65.6' Faraday Cloth Conductive Adhesive Tape | $17 |  | https://www.amazon.com/dp/B0CQX3Y7LH?ref=ppx_yo2ov_dt_b_fed_asin_title
x | $34 | Copper mesh |  | Amazon | 8 Inch x 100 Feet Pure Copper Mesh Roll | $34 |  | https://www.amazon.com/dp/B0FMJZSG99?ref=ppx_yo2ov_dt_b_fed_asin_title&th=1
X | $10 | Kapton Tape | 2" kapton tape | Amazon | 2 inch / 50mm 6 yd kapton tape | $10 |  | https://www.amazon.com/dp/B07D5RRXTS?ref=ppx_yo2ov_dt_b_fed_asin_title
 |  | Computer |  |  |  |  | $499
 |  |  | AMD Compuger | Amazon | GMKtec G10 Ryzen 5 3500U | $320 |  | https://www.amazon.com/dp/B0FR8S6CBW?ref_=ppx_hzsearch_conn_dt_b_fed_asin_title_7&th=1
X | $52 | 1 | WiFI Filter | Mouser / Minicircuits | VHF-2000+ | $39
X | $29 |  | WiFI USB Dongle | Amazon | AWUS036ACS | $29
X | $10 |  | USB C 4 port hub | Amazon | Ugreen USB C Hub 4 ports 3.2 | $16
X | $12 |  | RP2040 Feather Board | N/A | N/A | $12
X | $8 |  | Feather stacking header | N/A | N/A | 2
X | $30 |  | GNSS Receiver + Antenna QT | adafruit | PA1010D | $30
X | $35 |  | IMU 9DoF fusion QT | adafruit | BNO055 | 30
X | $15 |  | OLED Display Featherwing | N/A | 4650 | 15
x | $3 | 3 | Stemma QT Cable 100mm | N/A | N/A | 3
 | $2 |  | 3D printed AI Unit enclosure | custom 3d printed | PETG-CF | 3 |  | EMI paint coating on interior with screen mesh
 |  | Radio |  |  |  |  | $793
X | $129 | RF HAM DESIGN 1.0M? | Antenna | KrakenRF | Discovery Dish | $129 |  | Solar cooker for haystack version
X | $109 | RF HAM DESIGN 1.0M? | Feed | KrakenRF | H-line Feed | $109
X | $50 |  | Bias-T | GPIO Labs | usb-c bias-T | $50
X | $70 |  | RF Filter (H-line) | Minicircuits / Mouser | VBFZ-1400-S+ | $70
 | $70 |  | RF Filter (L-band) | Minicircuits / Mouser | VBFZ-1690-S+ | $70
 | $70 |  | RF Filter (S-band) | Minicircuits / Mouser | VBFZ-2340-S+ | $70
X | $230 |  | Software Radio | Analog Devices | Pluto SDR | $230
X | $24 |  | RF Calibration Noise Source | Amazon | NWDZ | $24 |  | https://www.amazon.com/dp/B078J57BJB?ref=ppx_yo2ov_dt_b_fed_asin_title
X | $3 |  | RF Calibrator Boost Regulator w/ Enable | Adafruit | 5644 | $3 |  | https://www.adafruit.com/product/5644
X | $5 |  | Stemma GPIO | Adafruit | 5545 | $5
X | $85 |  | EMI tape / shielding mesh | Amazon |  | $25 |  | Cost is for all materials
X | $8 |  | SMA Male to Male connector | Amazon / RFAdapter | SMA 5 Pack SMA Male to Male Adapter | $8 |  | https://www.amazon.com/Adapter-Coupler-Coaxial-Connector-RFAdapter/dp/B07XFNKCFH
 |  | Astrophotography |  |  |  |  | $376
X | $80 |  | Telescope | Svbony | SV106 | $80
X | $230 |  | Primary Imager | QHY | QHY5III715C | $230
X | $16 |  | Focuser Adapter (1.25 inch to M42 x 0.75) | Svbony | RM | $16 |  | https://www.amazon.com/dp/B07DPPF756?ref_=ppx_hzod_title_dt_b_fed_asin_title_0_0
 |  |  | Damping Gel / Lubricant
X | $20 |  | Lunar Filter | Svbony | Moon Filter | $20
X | $20 |  | UV Filter | Svbony | UV IR cut | $20
X | $8 |  | Solar Isolation Filter | Amazon | material | $8
 |  |  | 3d printed solar filter holder | custom | material | $1
 |  |  | 3d printed bahtinov mask | custom | material | $1
