MITHaystack/ASTRA/models/astra-sv-solar-filter-retainer.stl

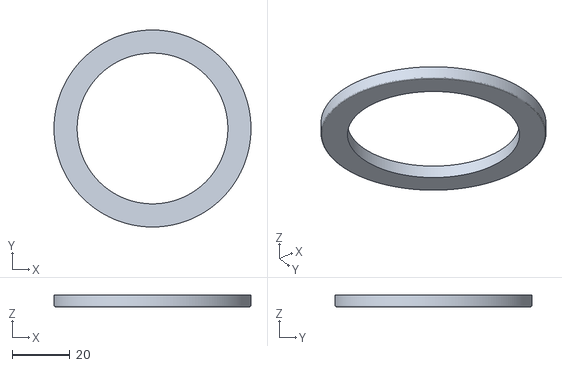
[picture p104: CAD file, 2026-10-19]
models/astra-sv-solar-filter-retainer.stl
68.0 x 68.0 x 4.00
