MITHaystack/ASTRA/models/astra-sdr-spacer.stl

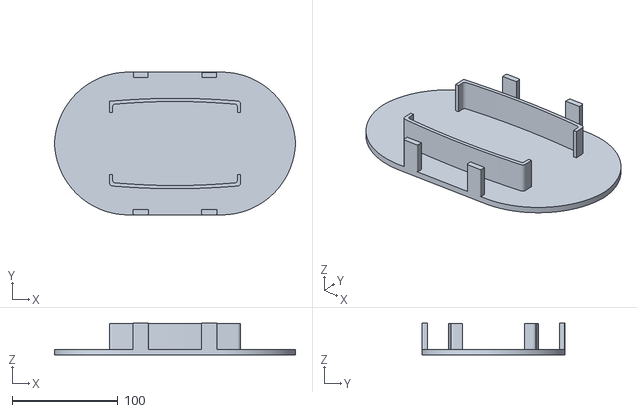
[picture p105: CAD file, 2026-10-19]
models/astra-sdr-spacer.stl
227.9 x 135.0 x 30.0
