MITHaystack/ASTRA/models/astra-sv-solar-filter-body.stl

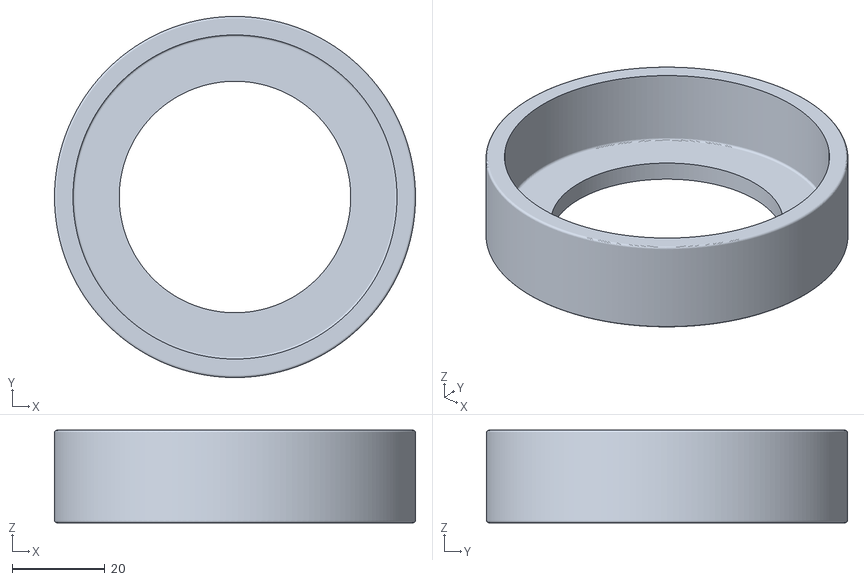
[picture p106: CAD file, 2026-10-19]
models/astra-sv-solar-filter-body.stl
78.0 x 78.0 x 20.0
