MITHaystack/ASTRA/models/astra-ai-bracket-enclosure-lid.stl

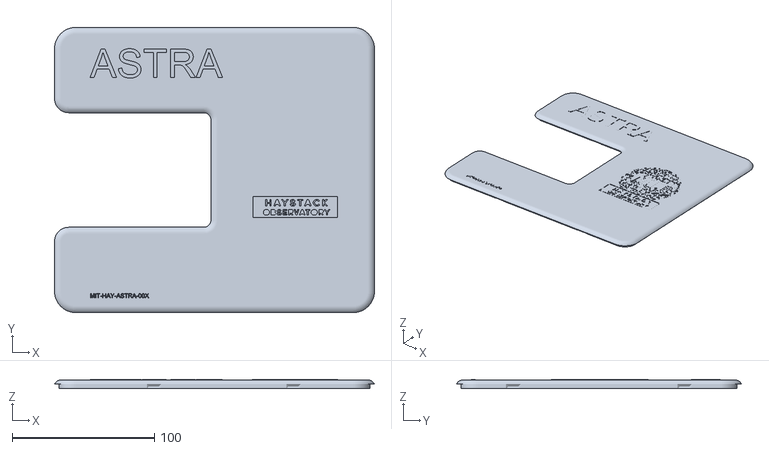
[picture p107: CAD file, 2026-10-19]
models/astra-ai-bracket-enclosure-lid.stl
225.0 x 200.5 x 6.25
