MITHaystack/ASTRA/models/astra-base-template.stl

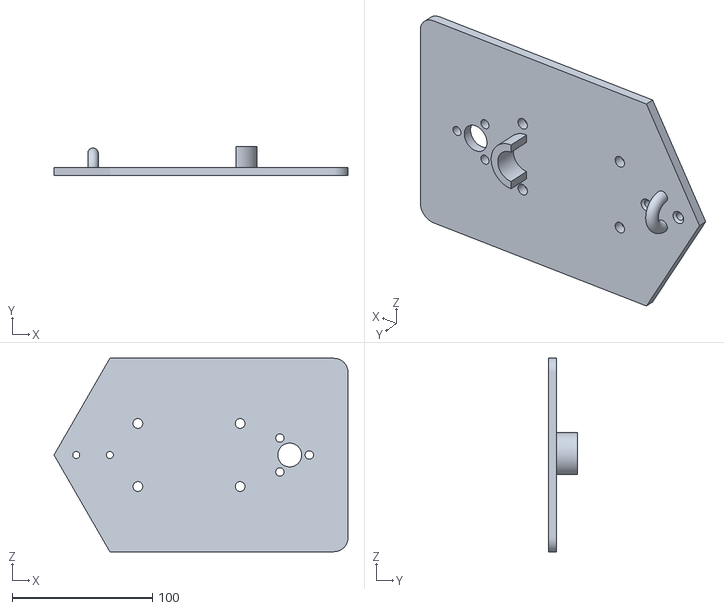
[picture p108: CAD file, 2026-10-19]
models/astra-base-template.stl
209.9 x 21.0 x 138.1
