MITHaystack/ASTRA/models/astra-ai-bracket-enclosure.stl

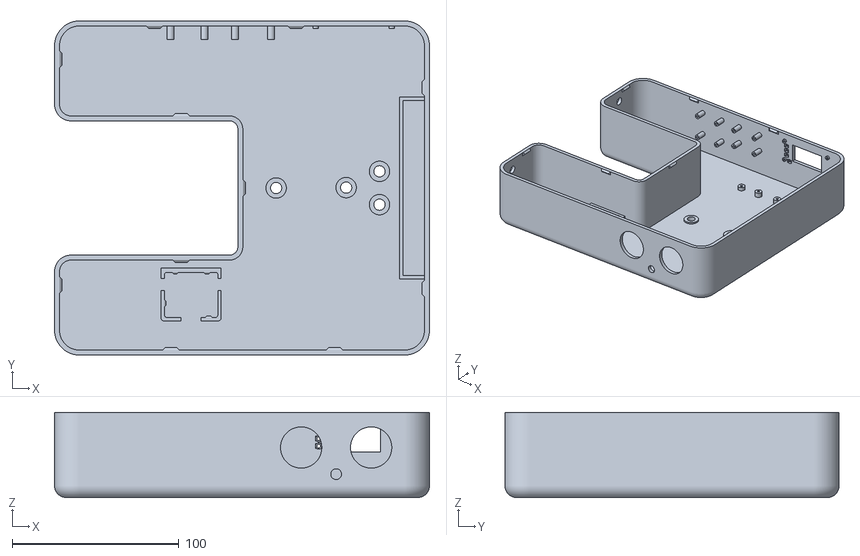
[picture p109: CAD file, 2026-10-19]
models/astra-ai-bracket-enclosure.stl
225.0 x 200.5 x 51.0
