MITHaystack/ASTRA/models/astra-ai-bracket.stl

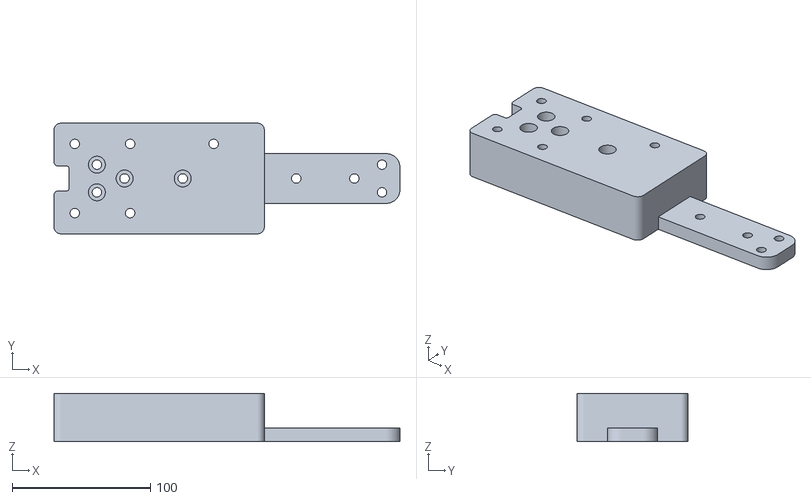
[picture p110: CAD file, 2026-10-19]
models/astra-ai-bracket.stl
250.0 x 80.0 x 35.0
