MITHaystack/ASTRA/(list of files, cad)

Other CAD files:
models/astra-ai-bracket-lid.f3z
models/astra-ai-bracket.f3d
models/astra-base-template.f3d
models/astra-sdr-spacer.f3d
models/astra-sv-solar-filter-body.f3d
models/astra-sv-solar-filter-retainer.f3d
