MITHaystack/ASTRA/docs/lessons/astra-setup/README.md

## ASTRA Setup and Transport

## Parts
ASTRA can be broken down into several different units. They are:
### - Antenna Interface (AI) and dish
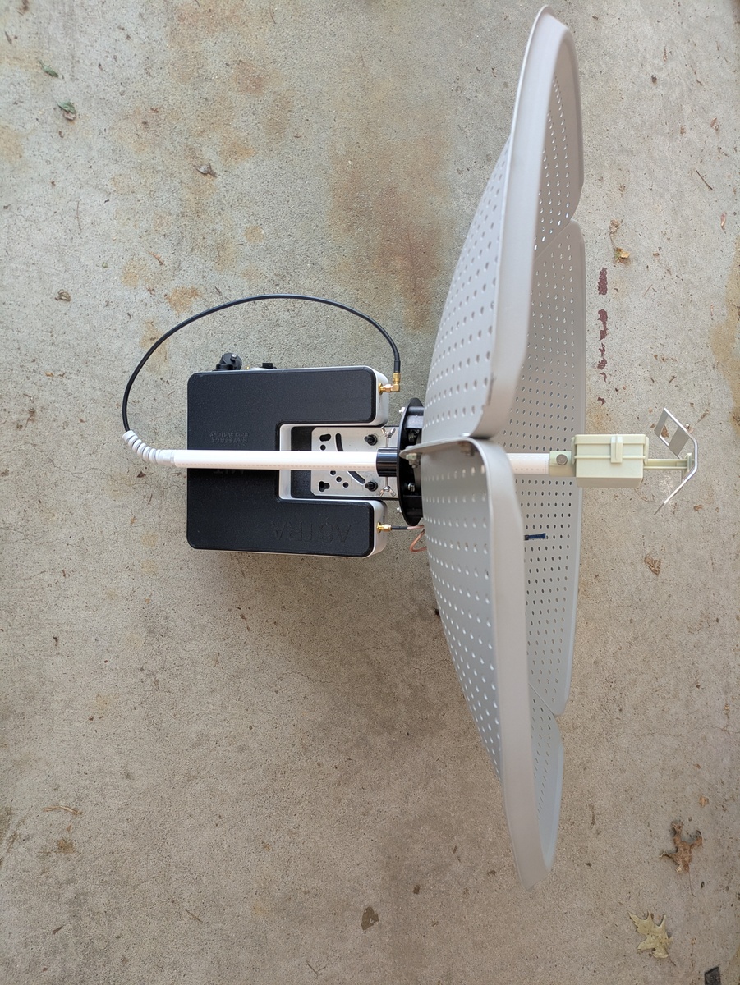
[picture p111: docs/lessons/astra-setup/img/ai_dish.jpg]


In the AI, there is a GPS, IMU, bias tee, noise diode and rp2040 controller. The GPS provides location and time data. The IMU provides orientation and magnetic field data. the bias tee provides power to the antenna. The noise diode connects to the smaller antenna inside the dish, and when activated sends out noise to calibrate the antenna and to test to see if the antenna can see the outside world. THe rp2040 controls all of these except for the bias tee, which is always on. The dish focuses the light to the feed, allowing for the light to be converted into electricity.

### - Tripod and mount
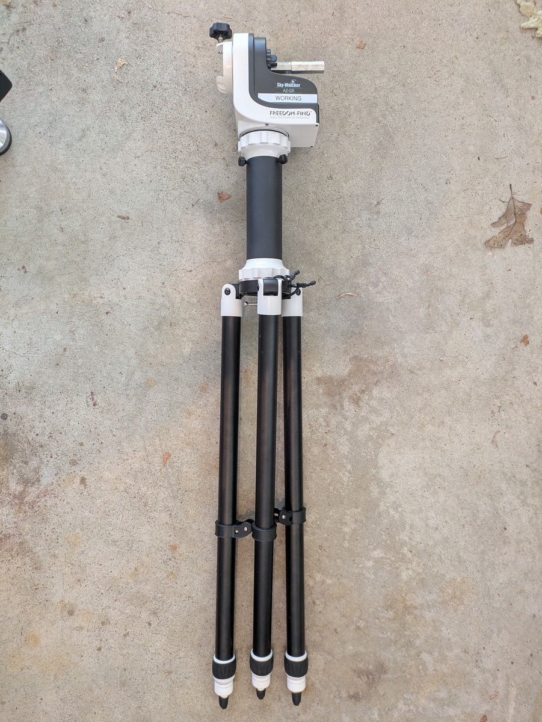
[picture p112: docs/lessons/astra-setup/img/tripod.jpg]


The mount allows for automated movement of the telescopes.

### - Optical telescope, counterweight, and CCD
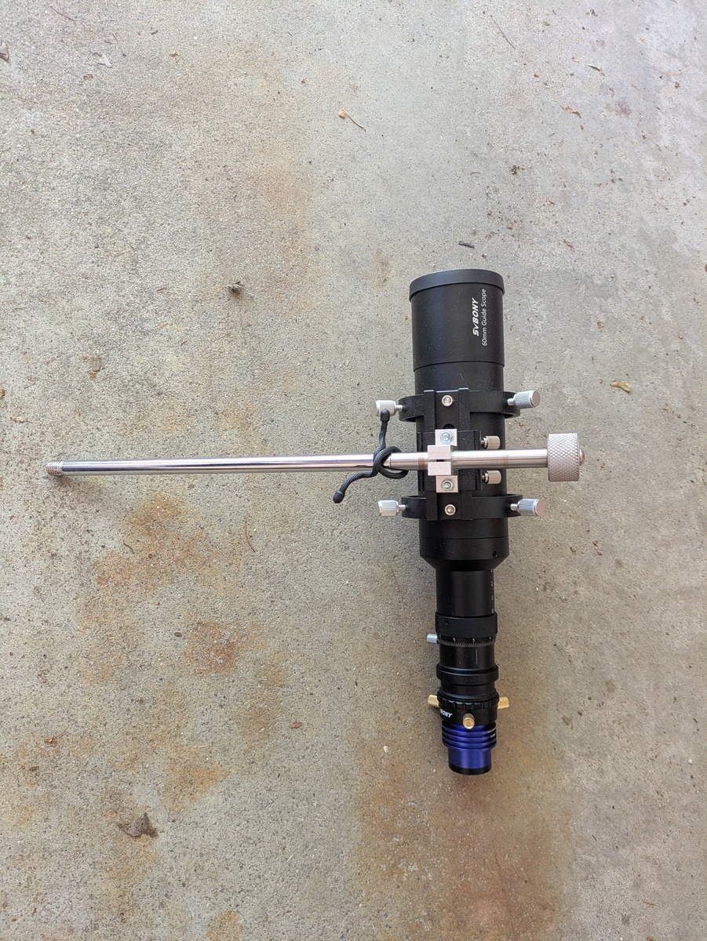
[picture p113: docs/lessons/astra-setup/img/ccd.jpg]


The optical telescope focuses light, magnifying the sky. The counterweight balances the load on the mount, reducing motor strain and risk of tipping. The CCD is effectively a camera without a lens.

### - Energy Box
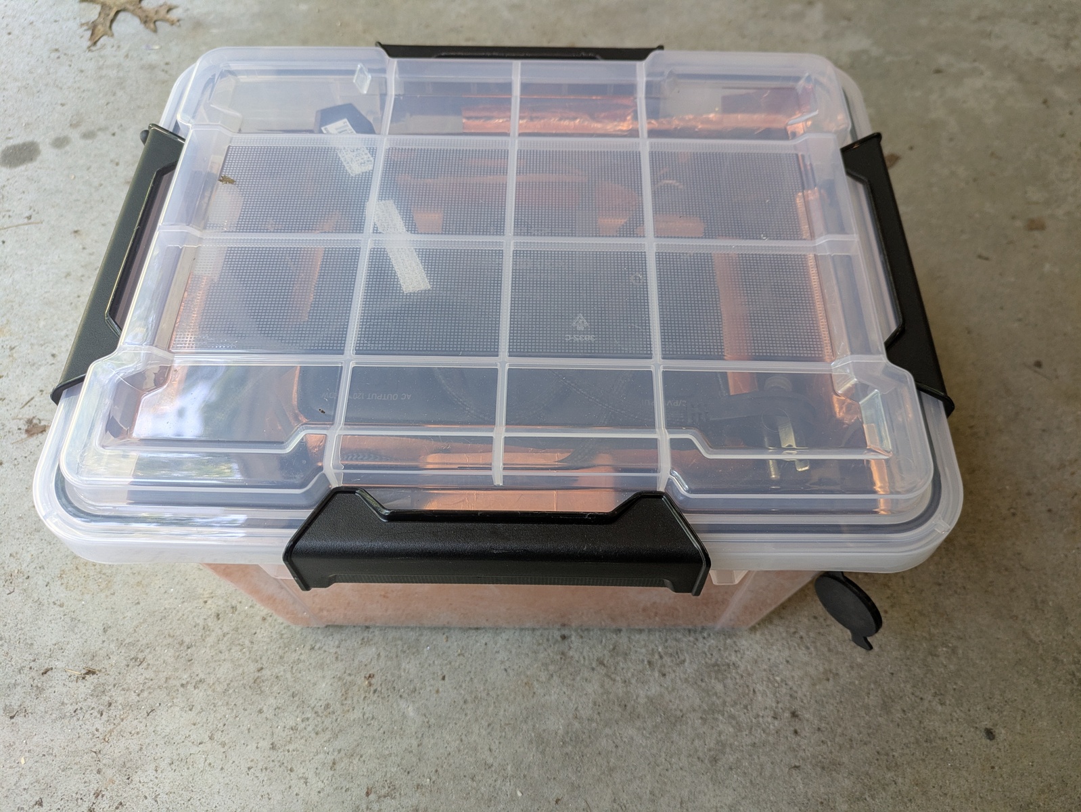
[picture p114: docs/lessons/astra-setup/img/energy_box.jpg]


The energy box contains a battery, software defined radio, wifi antenna, and main computer. THe battery provides power to the entire unit. The software defined radio takes the analog signal from the antenna and converts it into digital signal. The wifi antenna broadcasts a wifi network.
### - Base
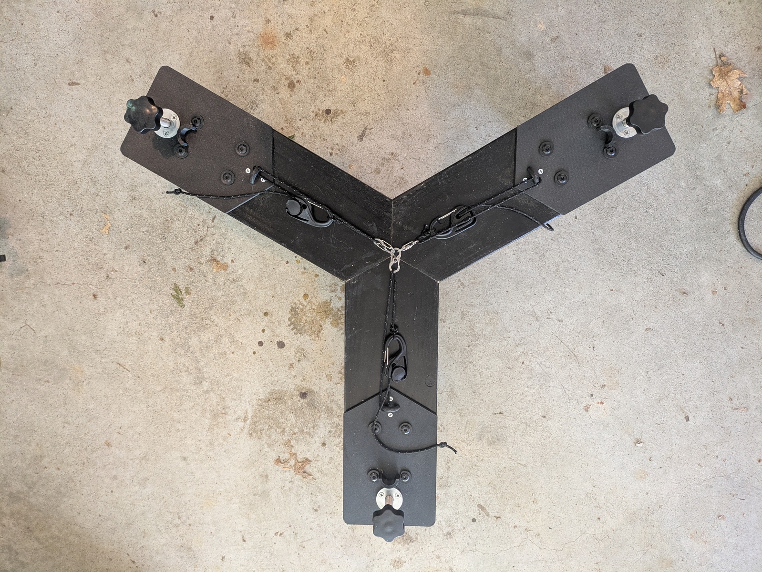
[picture p115: docs/lessons/astra-setup/img/base.jpg]


The base allows for moving of the entire unit, and has adjustable feet for ease of leveling. 

## Setup:
1. Place the base in or near the location where you will be observing with ASTRA.

2. Disconnect the s-clips from each other on the base.

3. Place the legs of the tripod into the half cups of the plastic plate on the base. Connect the s-clips to the bolts attached to the legs of the tripod. Tighten the cam locks.
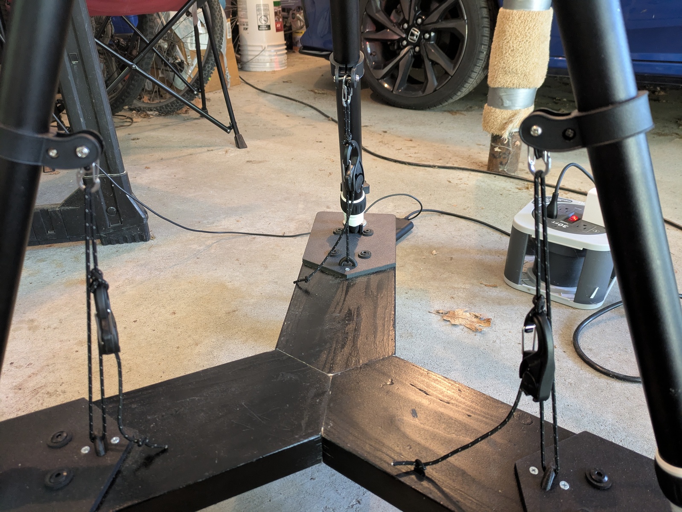
[picture p116: docs/lessons/astra-setup/img/tripod_tied_down.jpg]


4. Screw on the rod with the optical telescope, counterweight, and CCD.
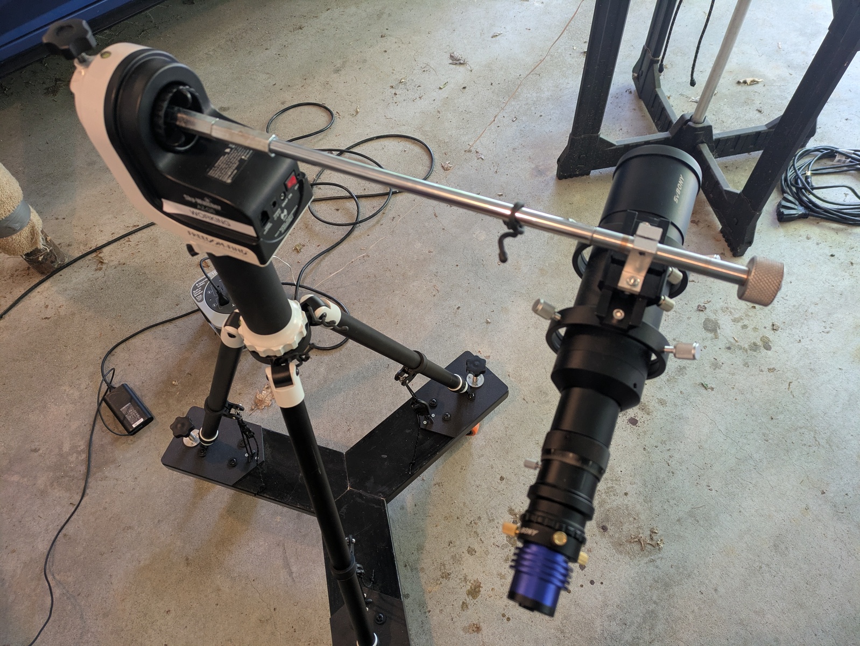
[picture p117: docs/lessons/astra-setup/img/ccd_attached.jpg]


5. Slide the AI's dovetail rail into the mount, almost as far as it will go, and tighten the set screw on the mount.
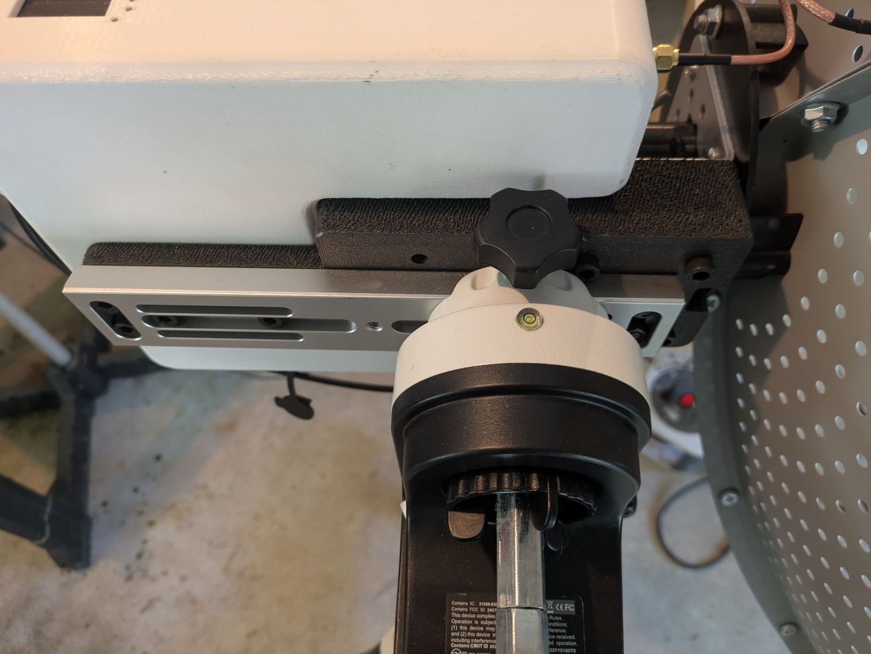
[picture p118: docs/lessons/astra-setup/img/ai_attached.jpg]


6. Slide the Energy Unit onto the base. Face the side with the ports away from the tripod leg that the box was inserted towards. You may need to push the tie downs a little bit.
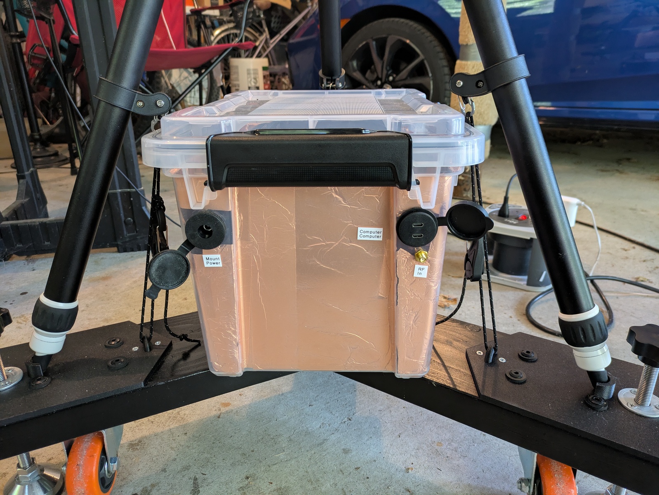
[picture p119: docs/lessons/astra-setup/img/energy_box_in.jpg]


7. Route the cables. For the cables from the Energy Unit, make sure that most of the slack in the cables is on the mount side of the cable ties. To prevent the ASTRA unit from disconnecting its CCD or mount, make sure that there is some slack in those cables.

### Cable Routes:

    a. Mount DC cable
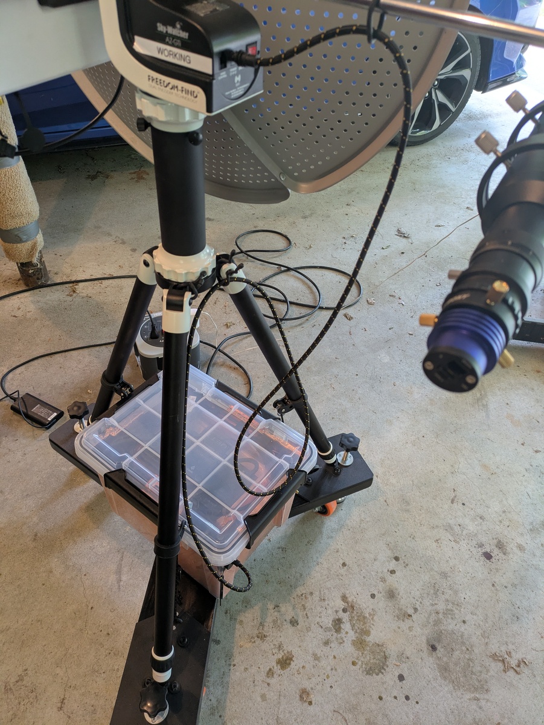
[picture p120: docs/lessons/astra-setup/img/route_mount_dc.jpg]


    b. AI USB-C cable
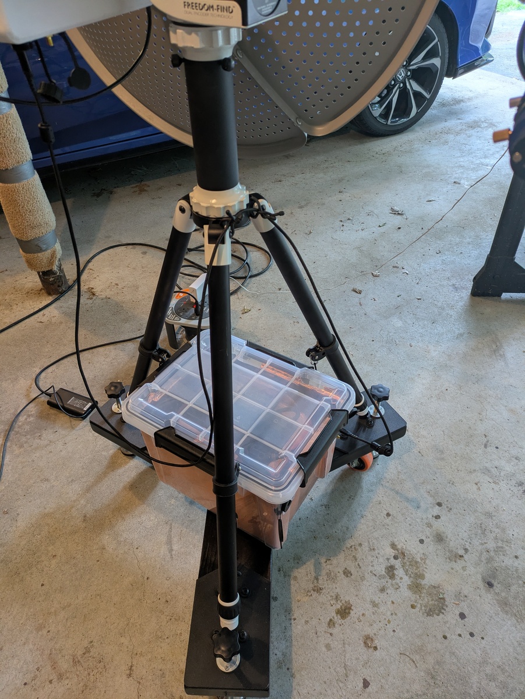
[picture p121: docs/lessons/astra-setup/img/route_ai_usbc.jpg]


    c. Energy Unit coaxial cable
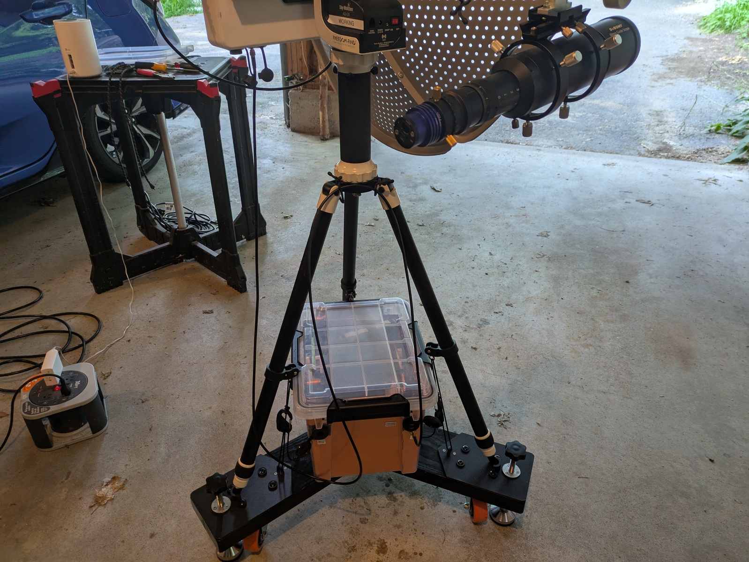
[picture p122: docs/lessons/astra-setup/img/route_energy_box_coax.jpg]


    d. CCD USB-C cable
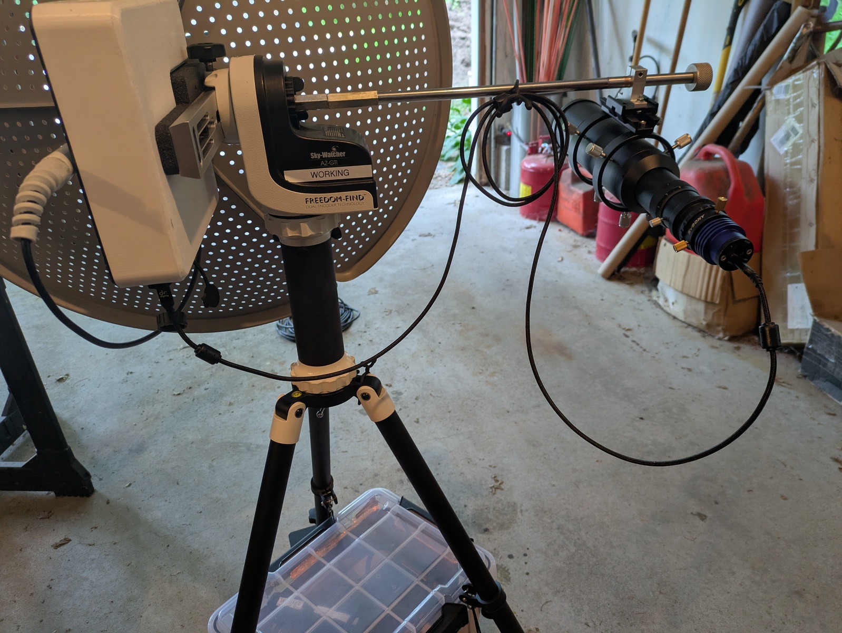
[picture p123: docs/lessons/astra-setup/img/route_ccd_usbc.jpg]


    e. Mount control USB cable
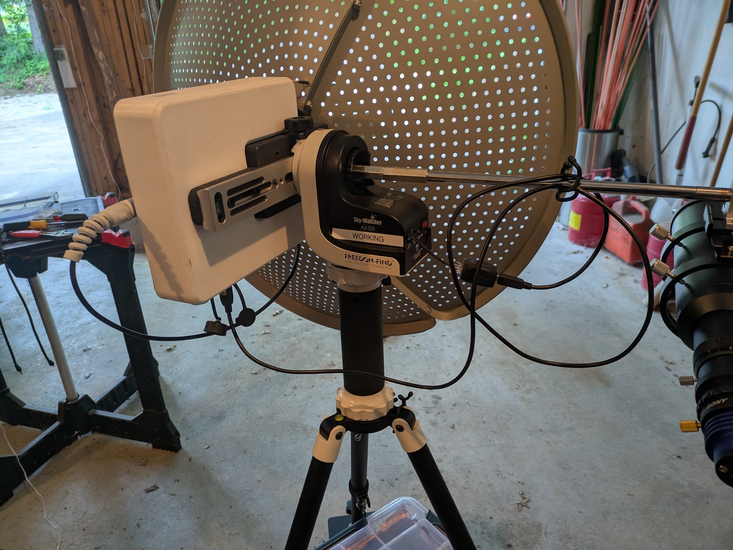
[picture p124: docs/lessons/astra-setup/img/route_mount_usb.jpg]


    f. All
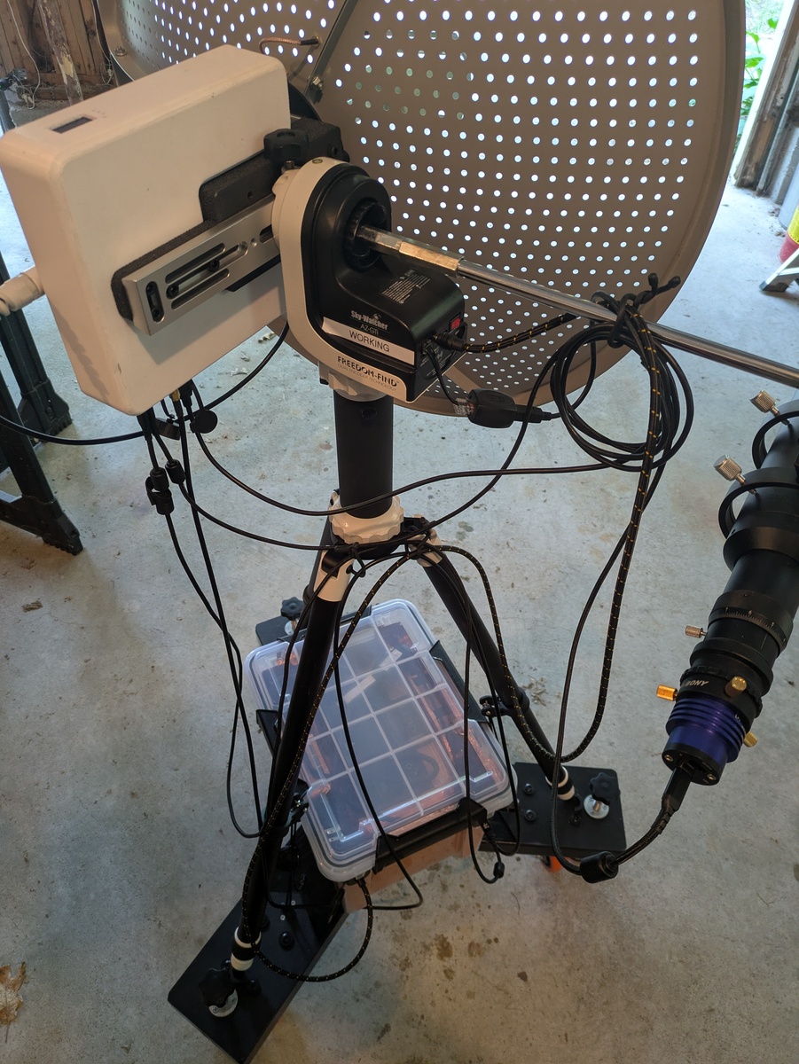
[picture p125: docs/lessons/astra-setup/img/route_all.jpg]


8. Place a level on the top of the AI and make sure it is level. Using an allen key, loosen the screw that holds the alignment of the optical telescope. Level the telescope and tighten the screw again.

## Takedown
1. Disconnect all cables that go between different modules. There should be four on the bottom of the AI, two on the mount, two on the Energy Box, and one on the CCD. Keep the cable ties where they are on the unit.
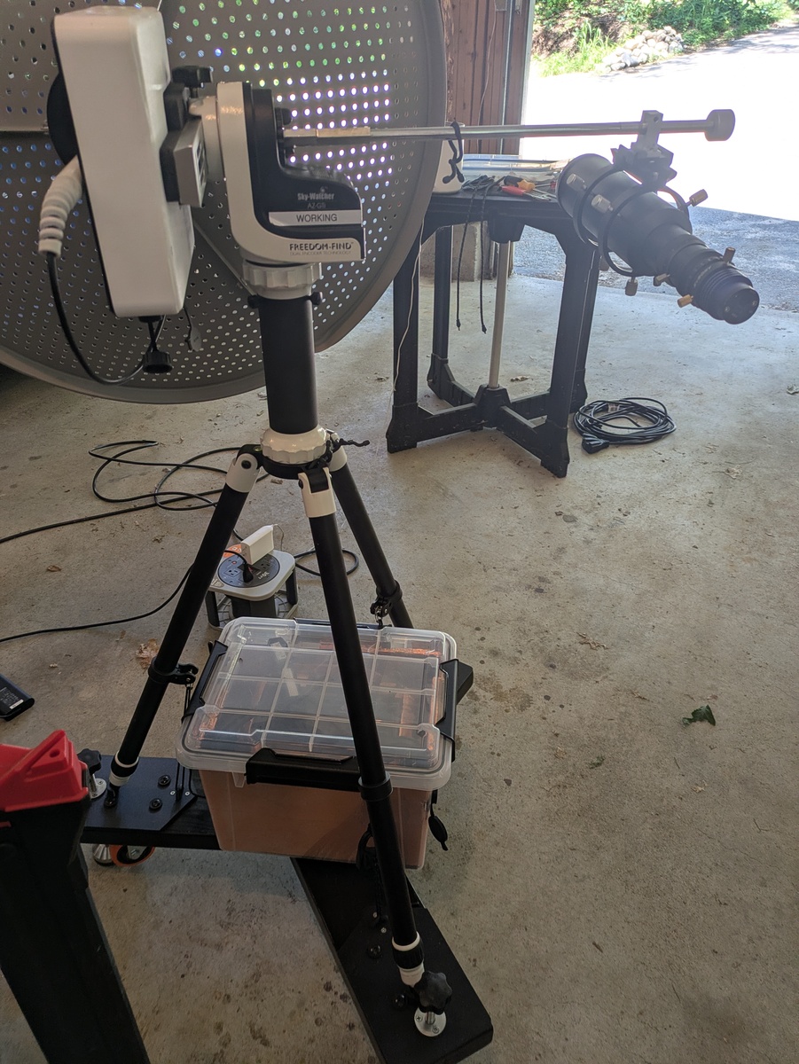
[picture p126: docs/lessons/astra-setup/img/cables_removed_3.jpg]


2. Remove the optical telescope, counterweight, and CCD by unscrewing the counterweight bar.
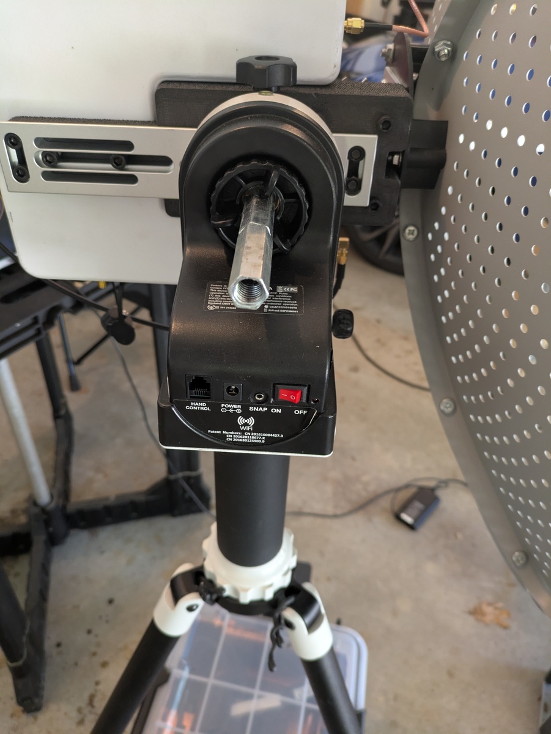
[picture p127: docs/lessons/astra-setup/img/ccd_removed.jpg]


3. Remove the AI and dish by unscrewing the set screw in the mount and sliding the whole setup out.
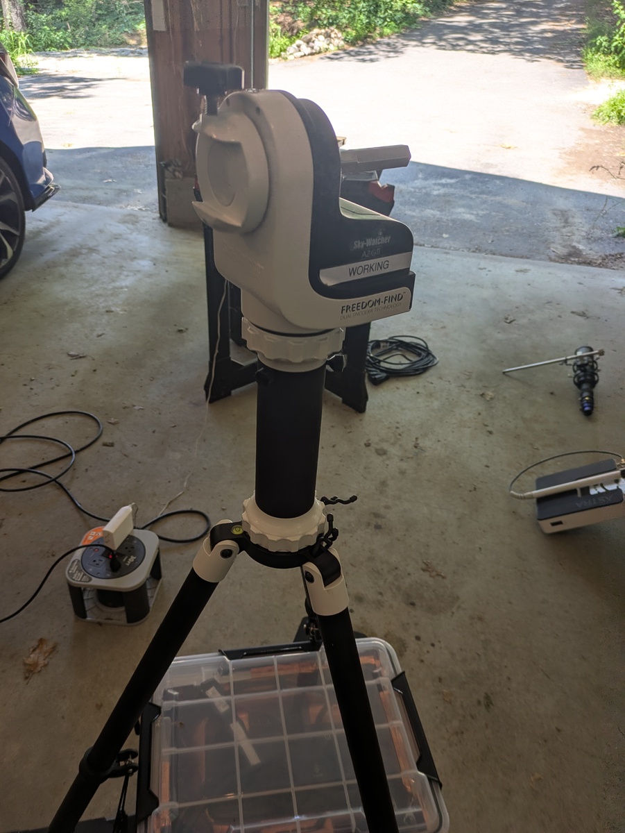
[picture p128: docs/lessons/astra-setup/img/ai_dish_removed.jpg]


4. Slide out the Energy Unit.
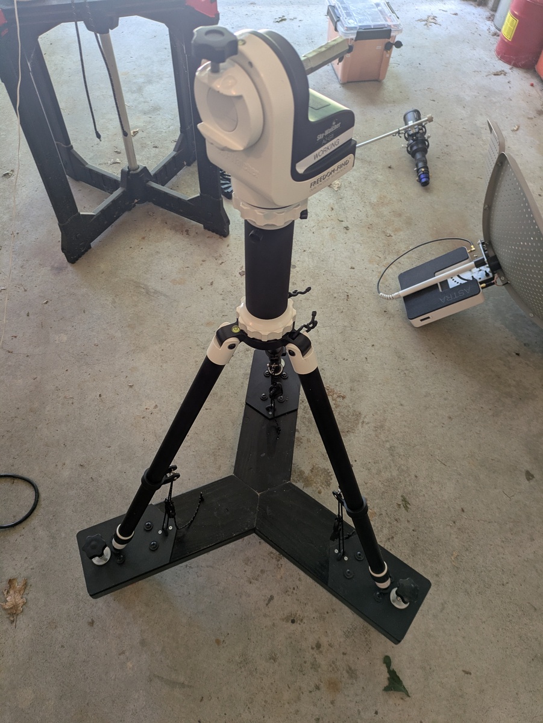
[picture p129: docs/lessons/astra-setup/img/energy_box_removed.jpg]


5. Disconnect the tripod and mount from the base by removing the rope from the jaws of the cam lock to loosen the ropes, and then removing the s-clips from the tripod.

6. Prepare the base for travel by connecting the s-clips to each other, roughly in the center of the base, and tightening the cam locks.


7. Arrange in your vehicle.
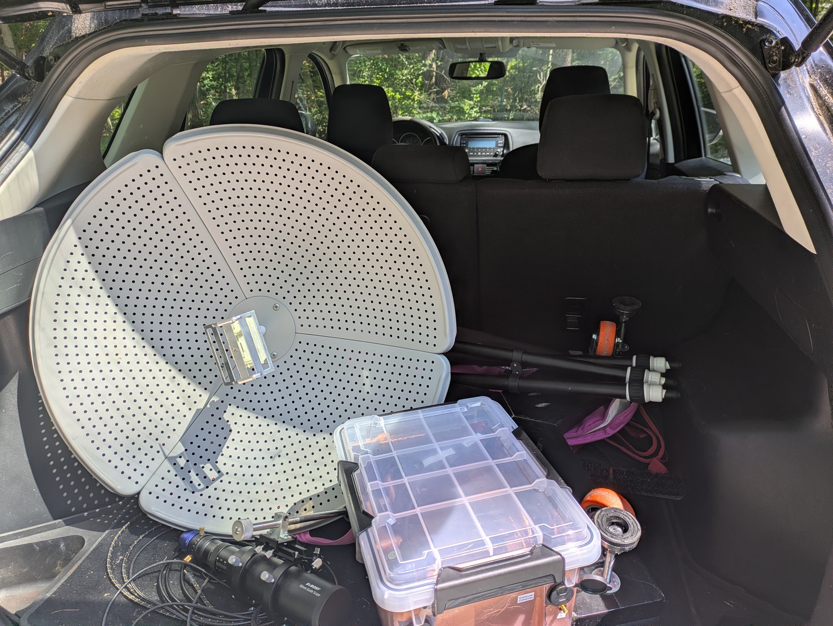
[picture p130: docs/lessons/astra-setup/img/in_car.jpg]
