MITHaystack/ASTRA/docs/hardware/img/aiu/aiu-biast-install.jpg

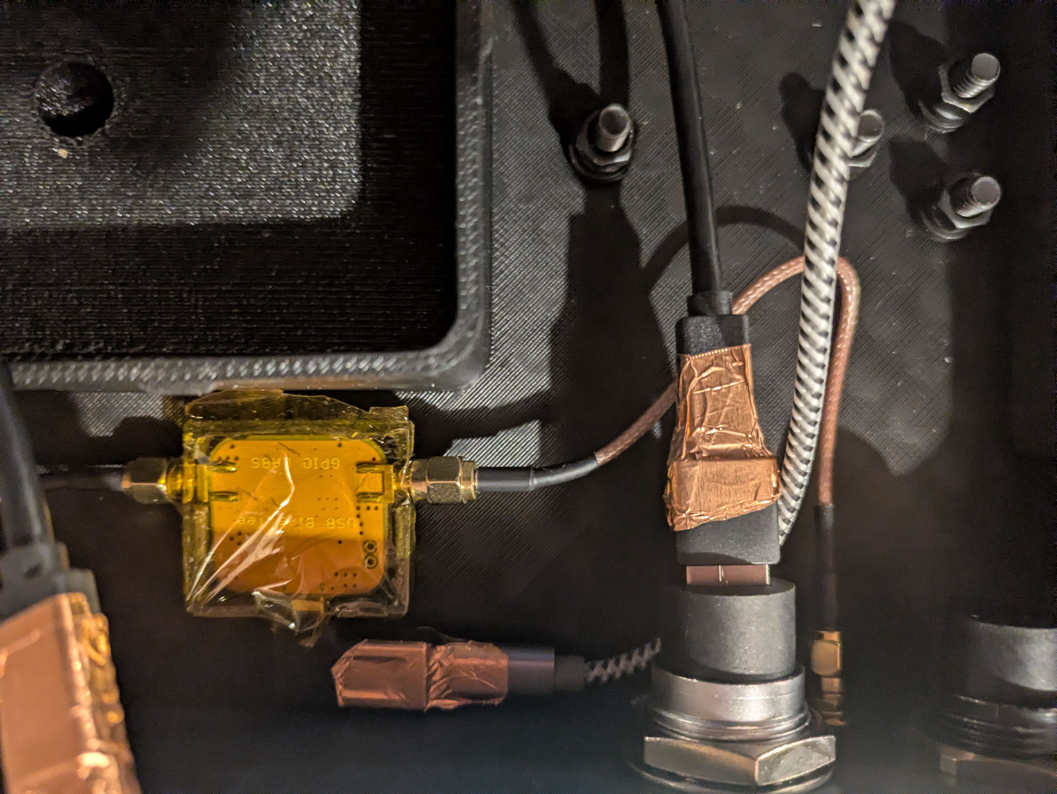
docs/hardware/img/aiu/aiu-biast-install.jpg
