MITHaystack/ASTRA/docs/hardware/img/aiu/aiu-install-cabled-back.jpg

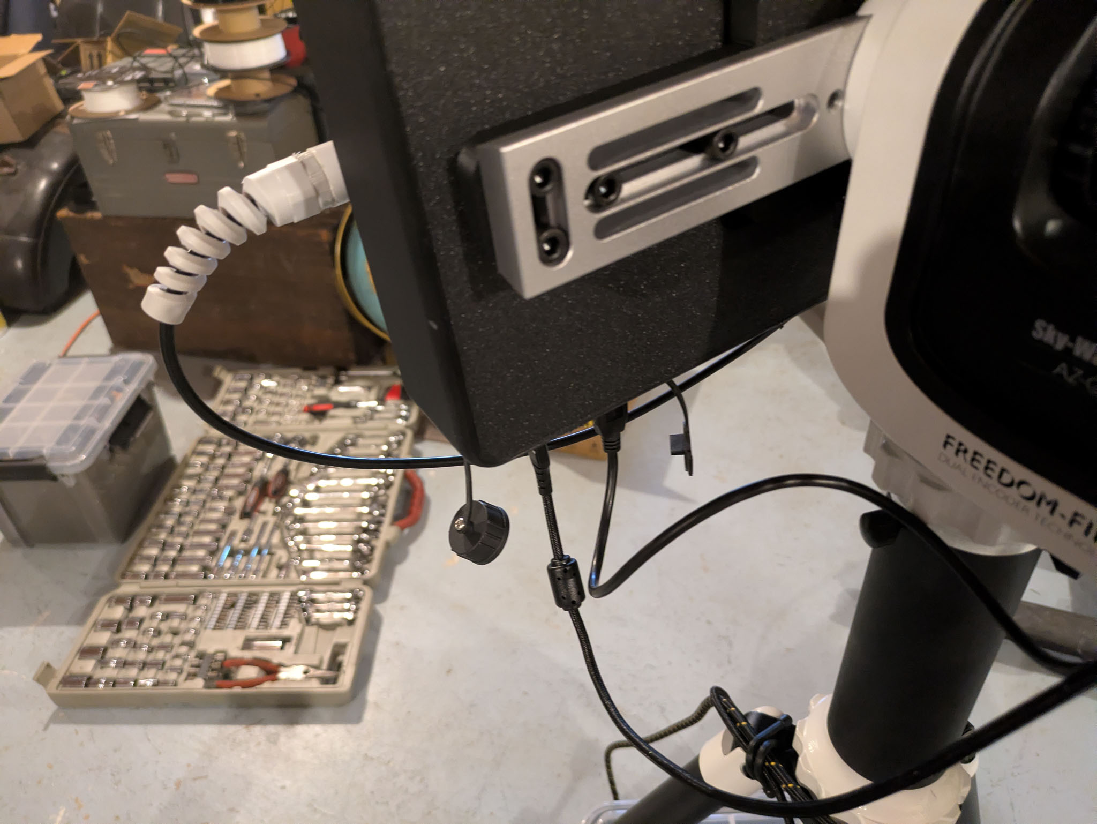
docs/hardware/img/aiu/aiu-install-cabled-back.jpg
