MITHaystack/ASTRA/docs/hardware/img/aiu/aiu-install-cabled.jpg

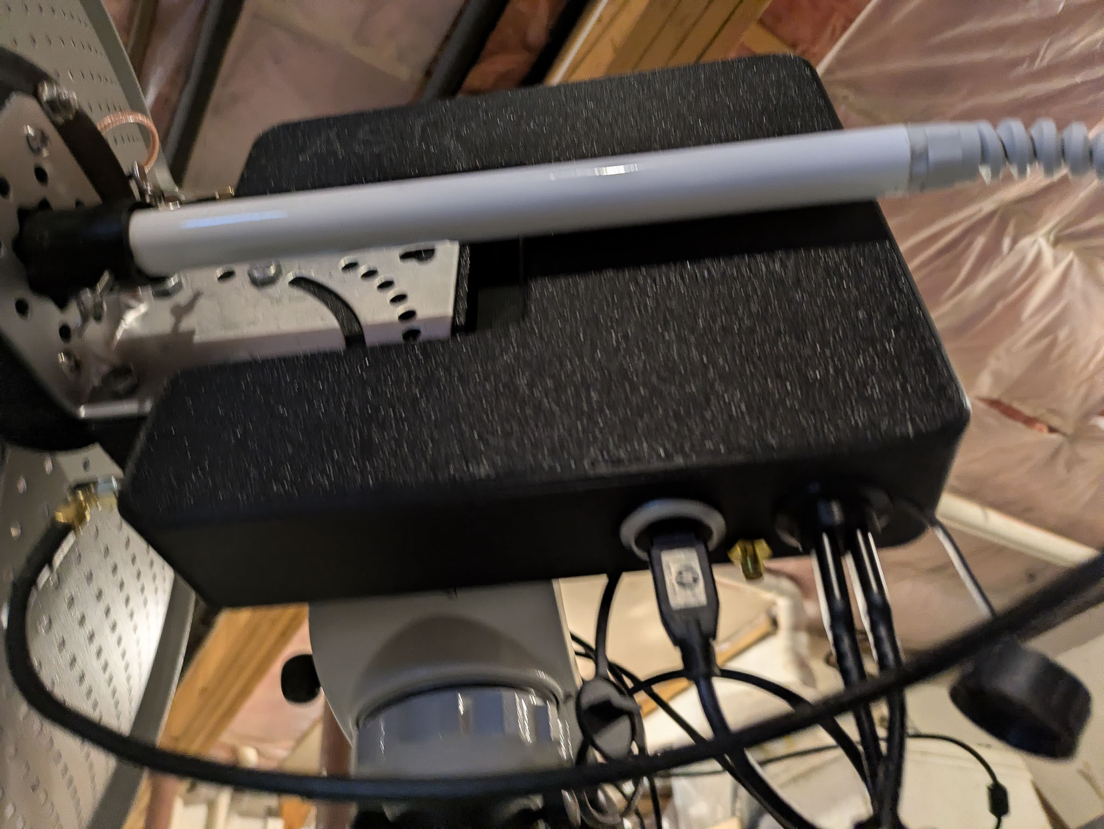
docs/hardware/img/aiu/aiu-install-cabled.jpg
