MITHaystack/ASTRA/docs/hardware/img/aiu/aiu-installed.jpg

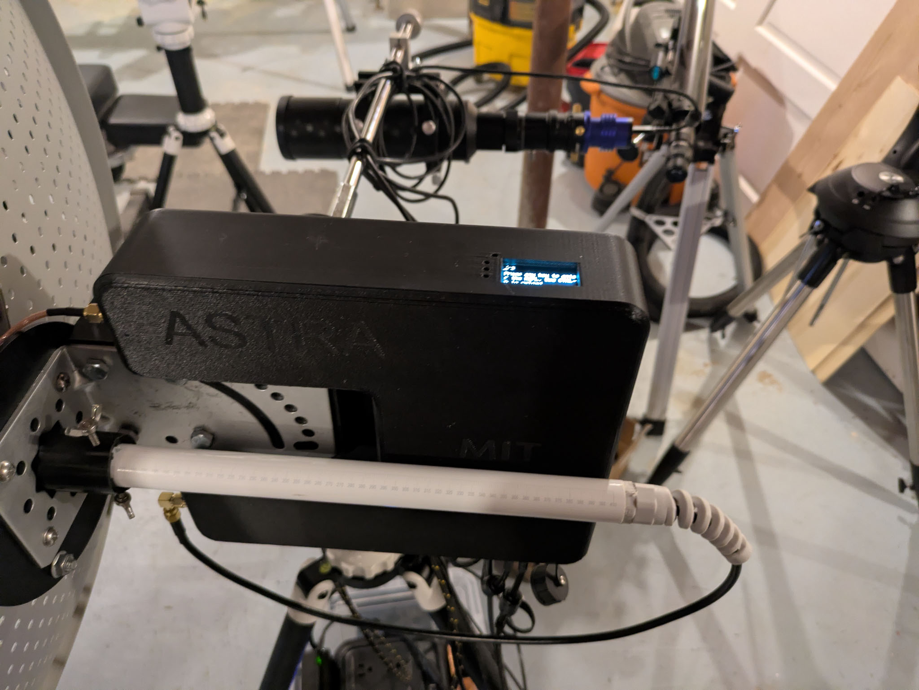
docs/hardware/img/aiu/aiu-installed.jpg
