MITHaystack/ASTRA/docs/hardware/img/aiu/aiu-internal-wiring.jpg

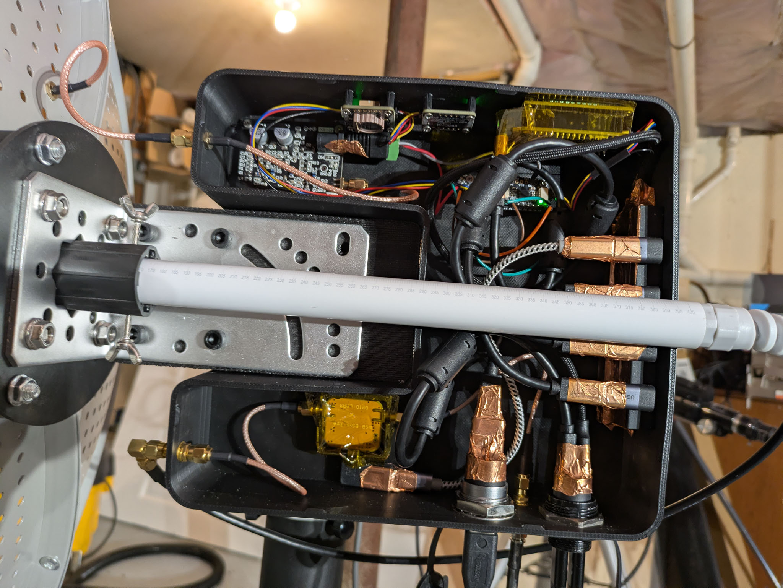
docs/hardware/img/aiu/aiu-internal-wiring.jpg
