MITHaystack/ASTRA/docs/hardware/img/aiu/aiu-rf-wiring.jpg

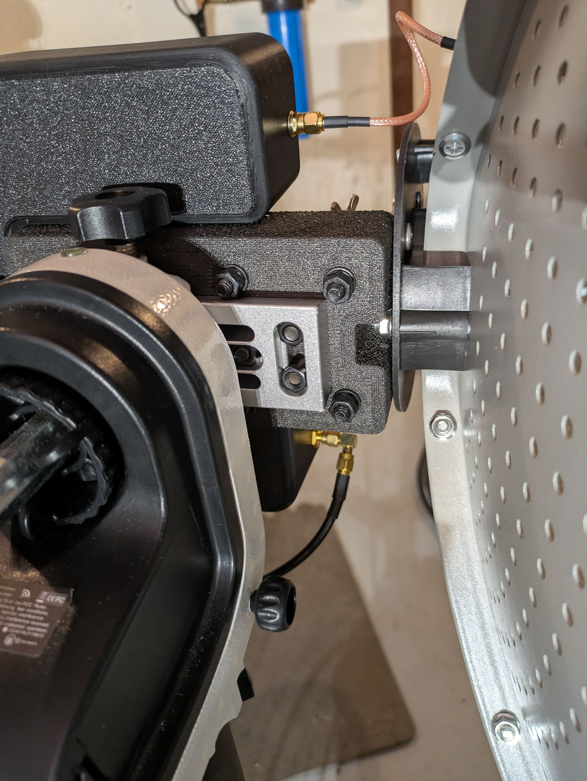
docs/hardware/img/aiu/aiu-rf-wiring.jpg
