MITHaystack/ASTRA/docs/hardware/img/aiu/aiu-sdr-bias-wiring.jpg

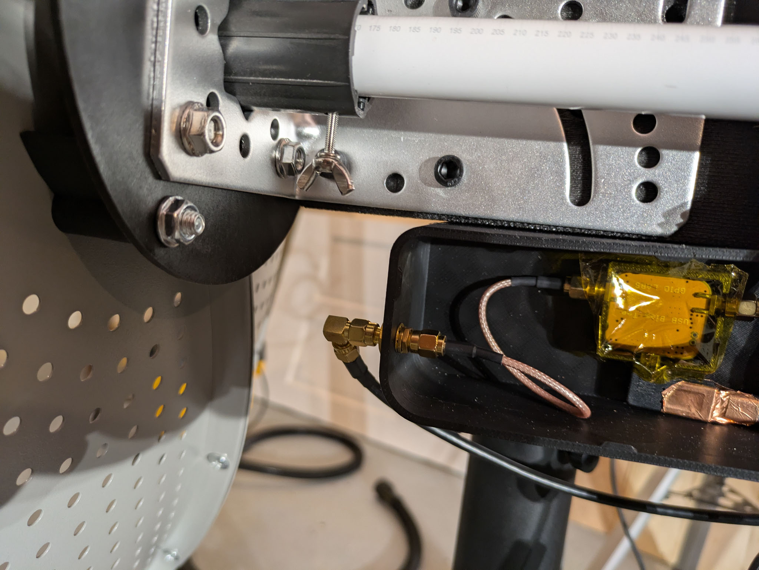
docs/hardware/img/aiu/aiu-sdr-bias-wiring.jpg
