MITHaystack/ASTRA/docs/hardware/img/antenna/antenna-feed-assembly1.jpg

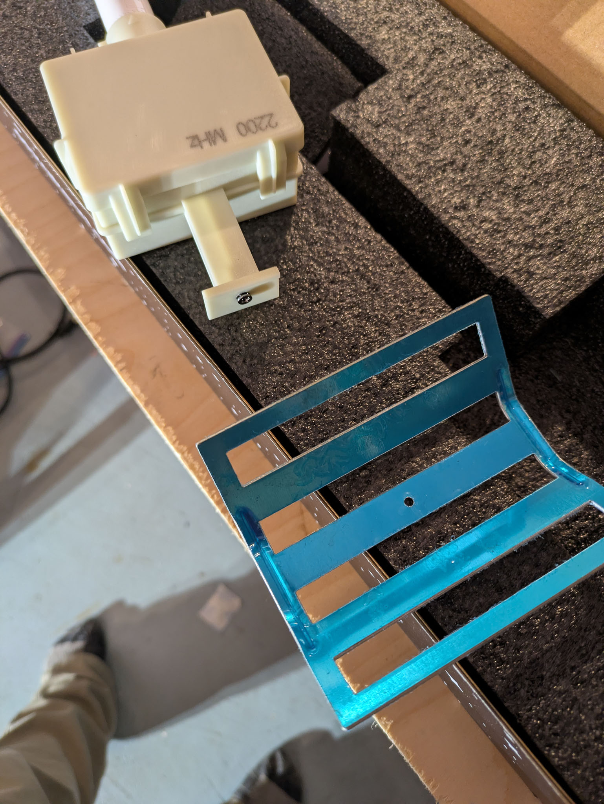
docs/hardware/img/antenna/antenna-feed-assembly1.jpg
