MITHaystack/ASTRA/docs/hardware/img/antenna/antenna-feed-assembly2.jpg

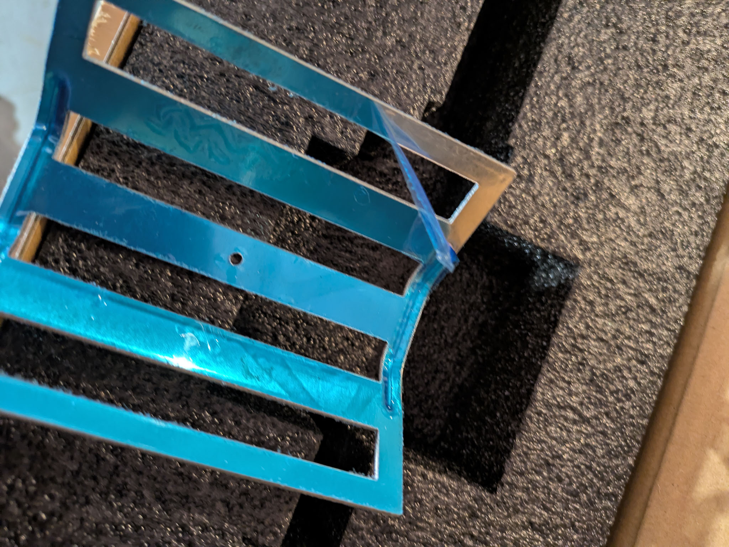
docs/hardware/img/antenna/antenna-feed-assembly2.jpg
