MITHaystack/ASTRA/docs/hardware/img/antenna/antenna-feed-assembly3.jpg

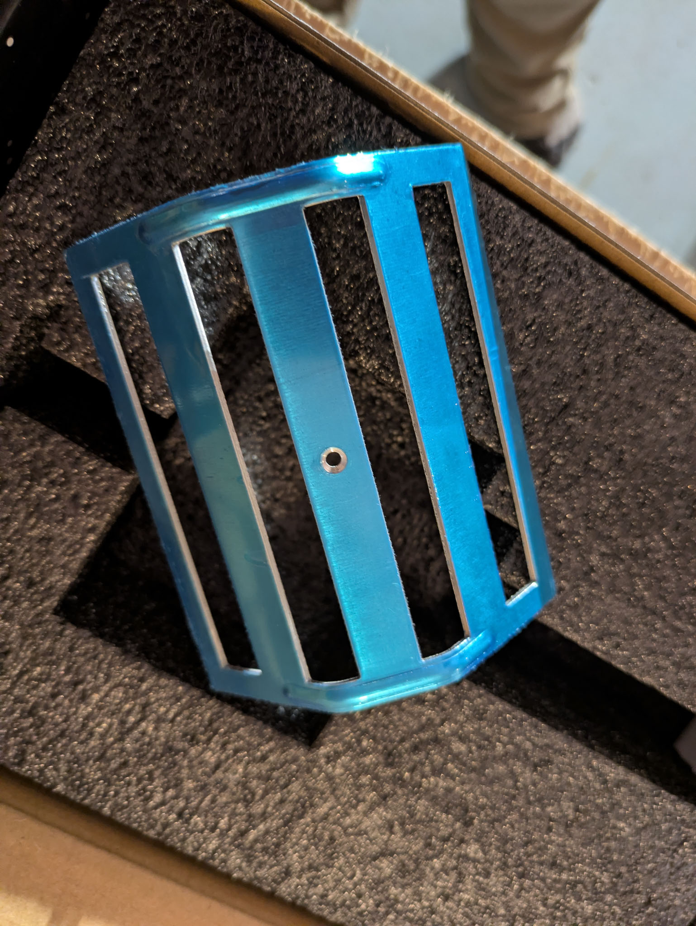
docs/hardware/img/antenna/antenna-feed-assembly3.jpg
