MITHaystack/ASTRA/docs/hardware/img/antenna/antenna-feed-assembly4.jpg

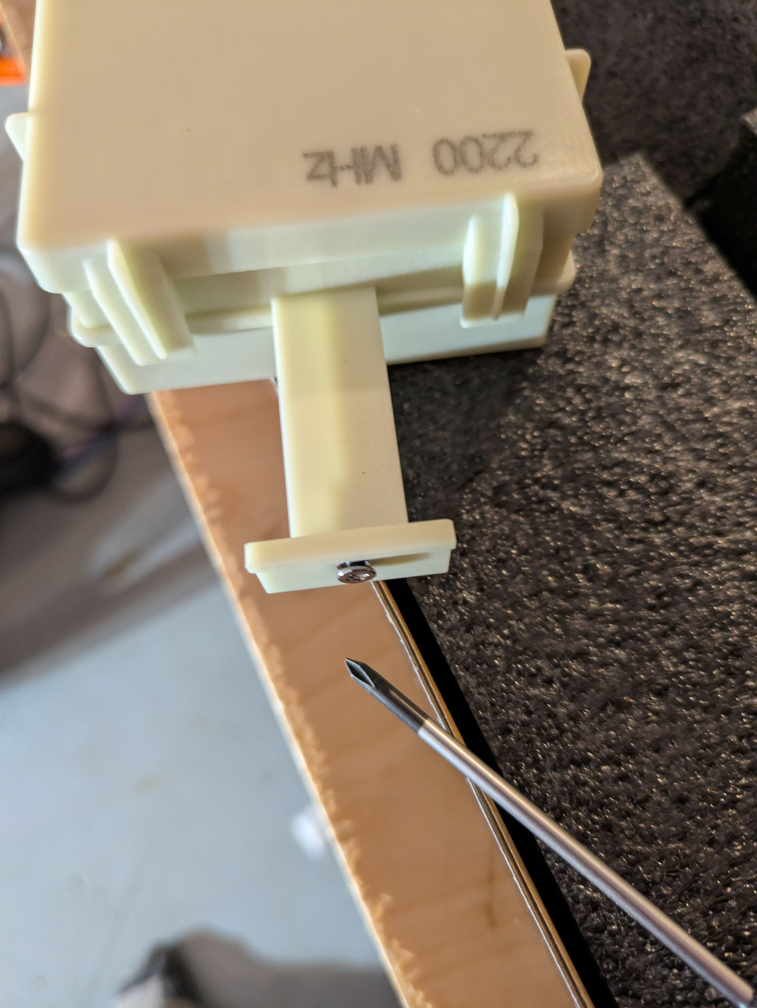
docs/hardware/img/antenna/antenna-feed-assembly4.jpg
