MITHaystack/ASTRA/docs/hardware/img/base/base-assembly-clamping.jpg

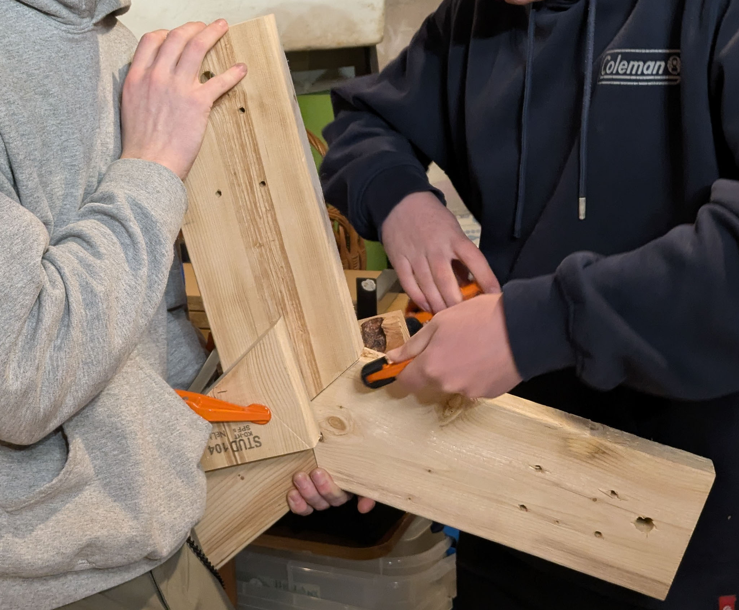
docs/hardware/img/base/base-assembly-clamping.jpg
