MITHaystack/ASTRA/docs/hardware/img/base/base-wheel-install.jpg

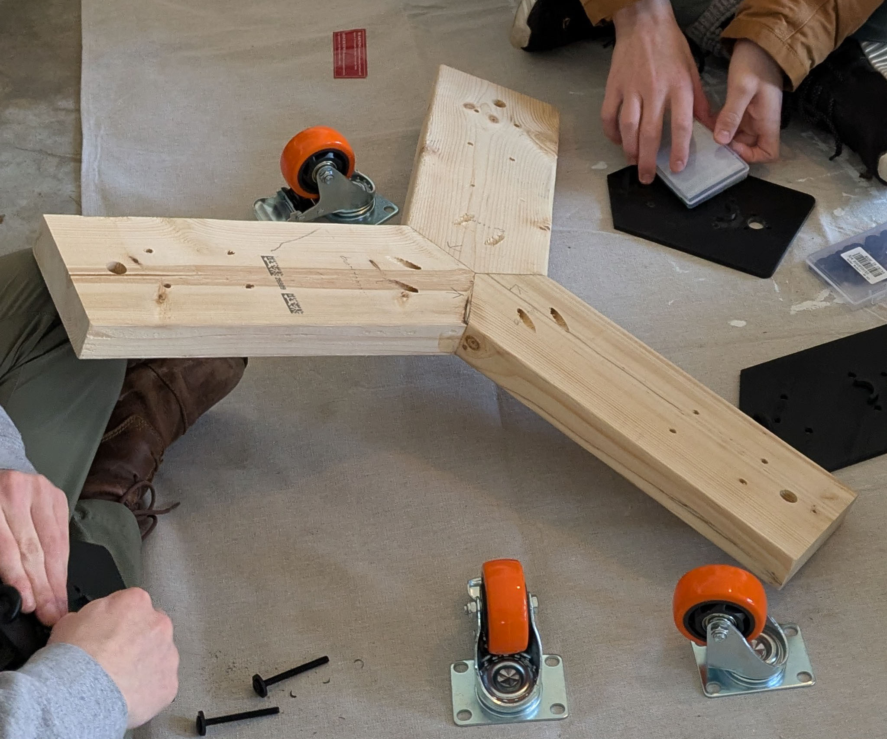
docs/hardware/img/base/base-wheel-install.jpg
