MITHaystack/ASTRA/docs/hardware/img/daq-energy/daq-drill-setup2.jpg

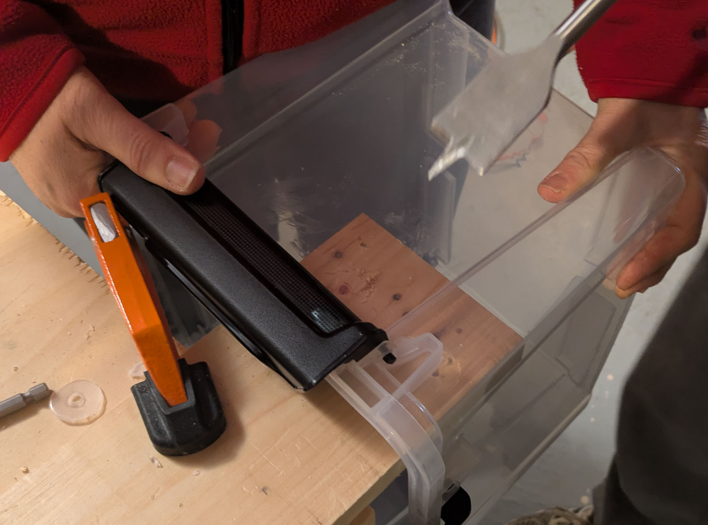
docs/hardware/img/daq-energy/daq-drill-setup2.jpg
