MITHaystack/ASTRA/docs/hardware/img/daq-energy/daq-drill-setup.jpg

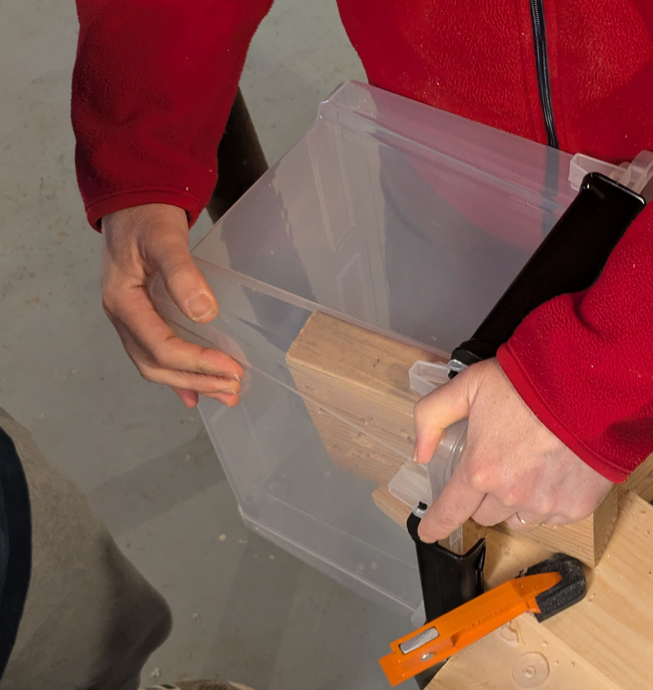
docs/hardware/img/daq-energy/daq-drill-setup.jpg
