MITHaystack/ASTRA/docs/hardware/img/daq-energy/daq-eu-installed.jpg

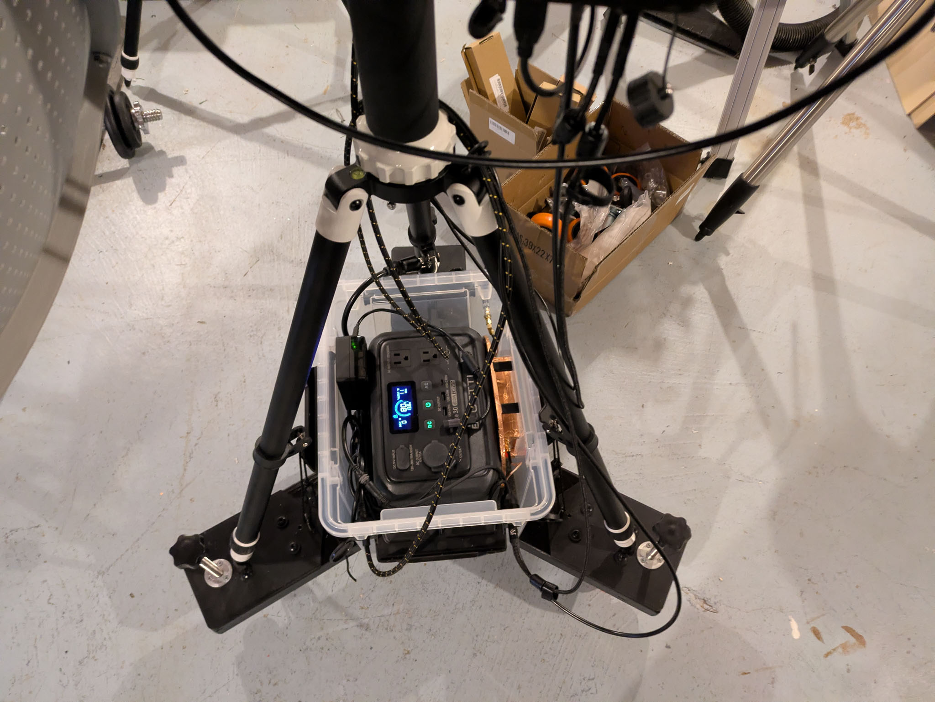
docs/hardware/img/daq-energy/daq-eu-installed.jpg
