MITHaystack/ASTRA/docs/hardware/img/daq-energy/daq-external-wiring-data-power.jpg

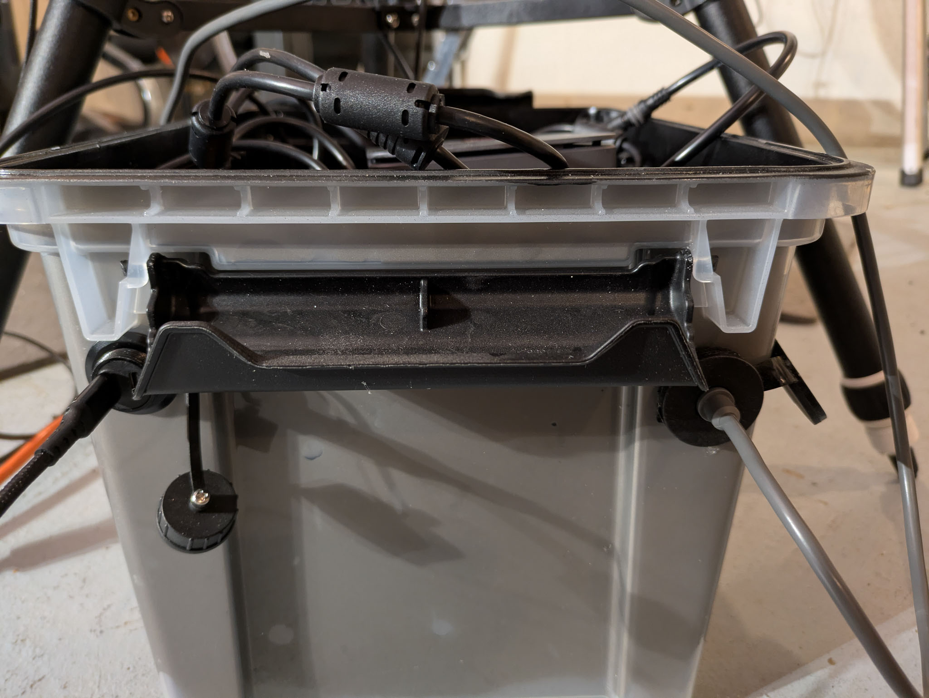
docs/hardware/img/daq-energy/daq-external-wiring-data-power.jpg
