MITHaystack/ASTRA/docs/hardware/img/daq-energy/daq-usb-aiu-wiring2.jpg

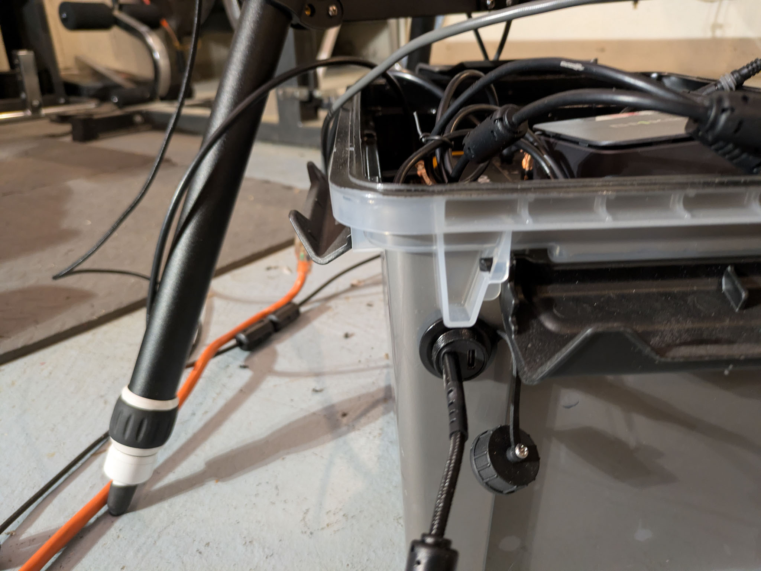
docs/hardware/img/daq-energy/daq-usb-aiu-wiring2.jpg
