MITHaystack/ASTRA/docs/hardware/img/daq-energy/daq-usb-aiu-wiring.jpg

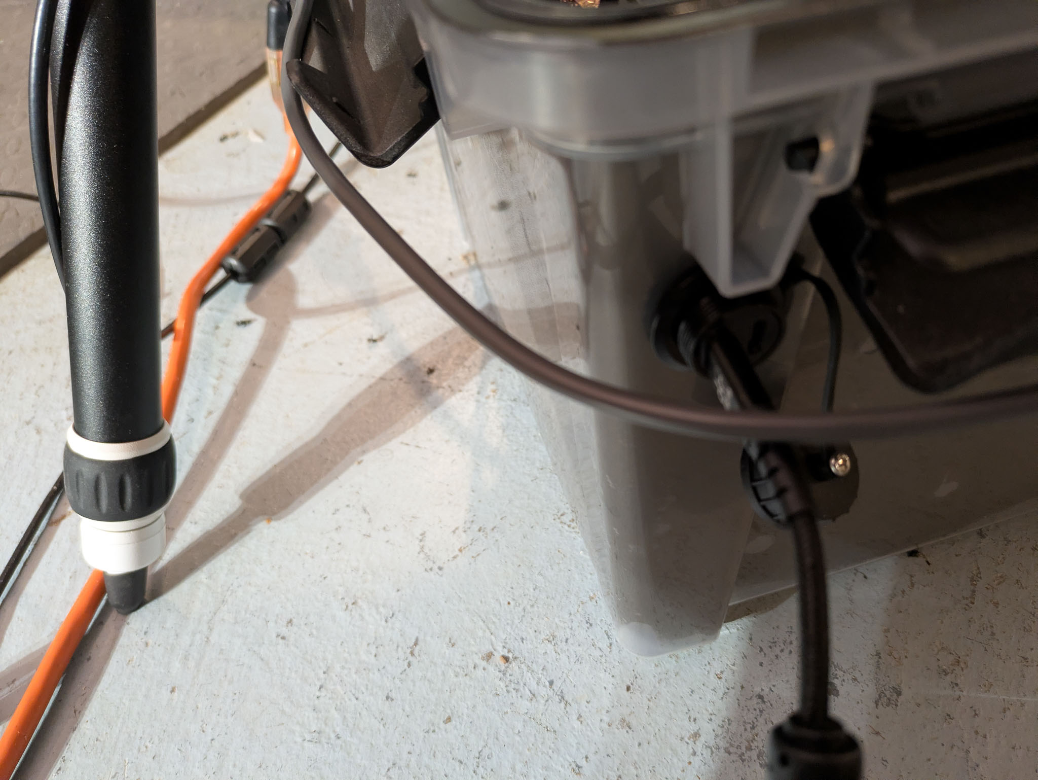
docs/hardware/img/daq-energy/daq-usb-aiu-wiring.jpg
