MITHaystack/ASTRA/docs/hardware/img/system/astra-system-setup2.jpg

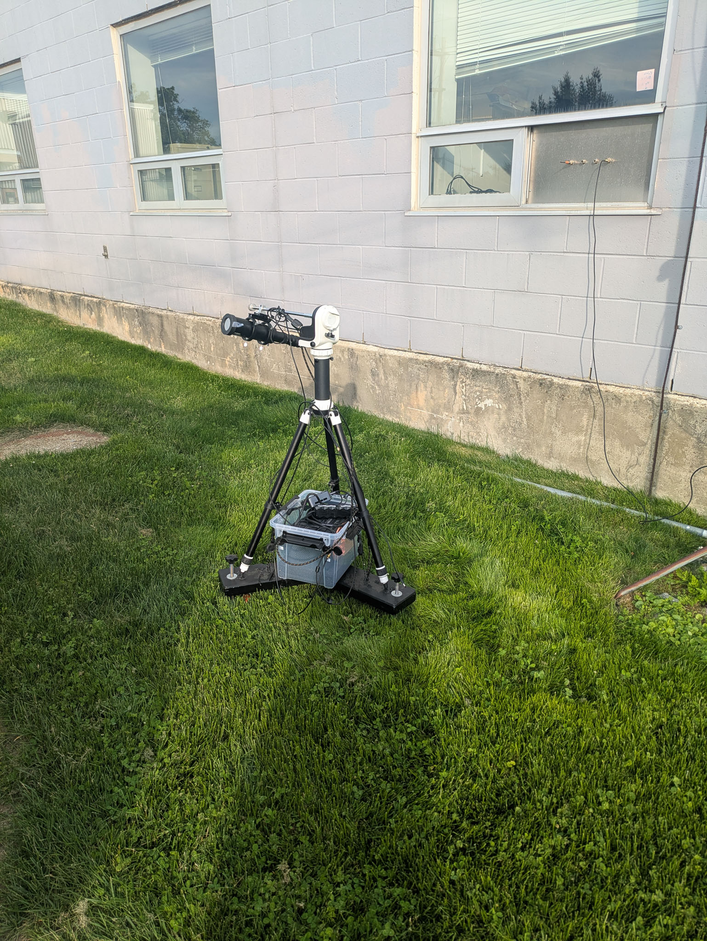
docs/hardware/img/system/astra-system-setup2.jpg
