MITHaystack/ASTRA/docs/hardware/img/aiu/aiu-calibrator-connection2.jpg

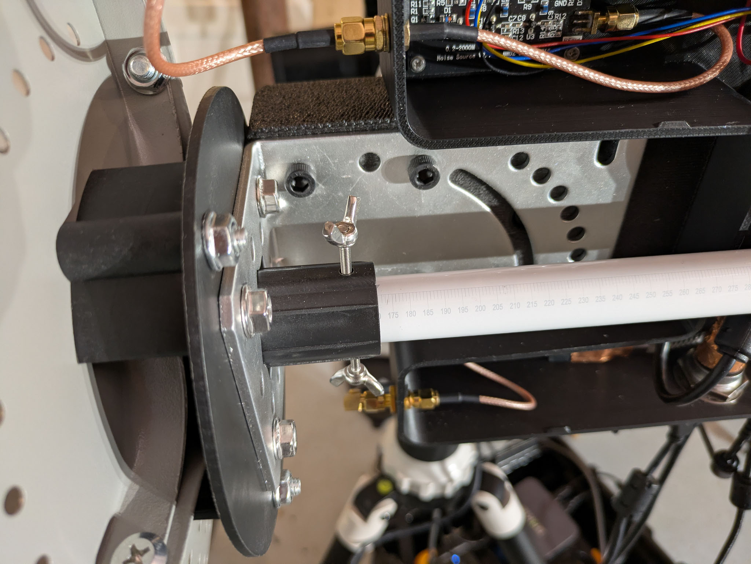
docs/hardware/img/aiu/aiu-calibrator-connection2.jpg
