MITHaystack/ASTRA/docs/hardware/img/aiu/aiu-calibrator-connection.jpg

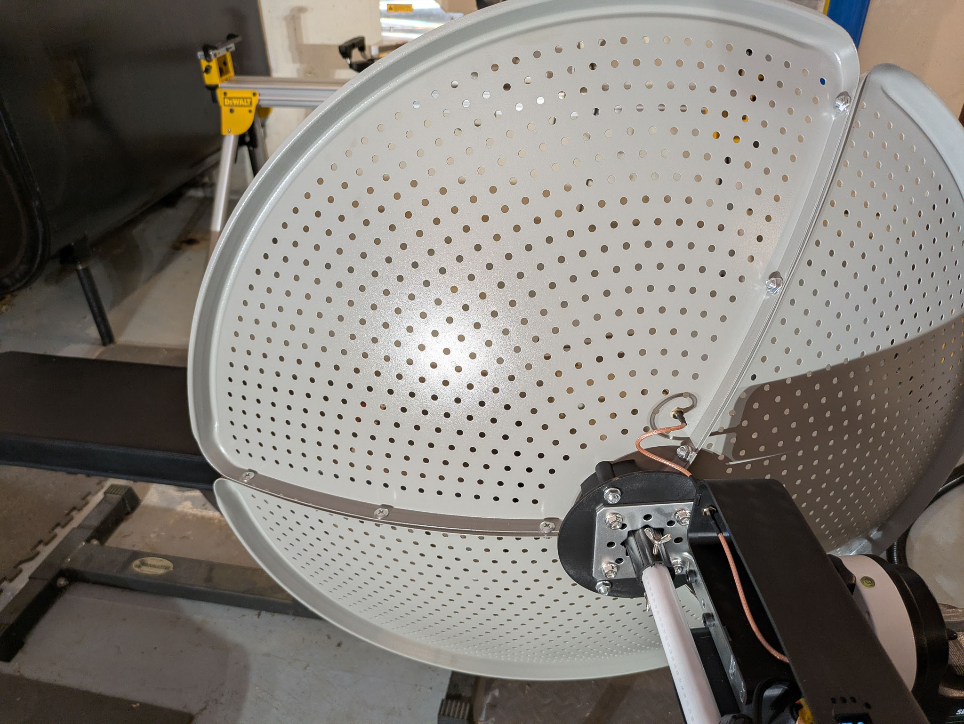
docs/hardware/img/aiu/aiu-calibrator-connection.jpg
