MITHaystack/ASTRA/docs/hardware/img/antenna/antenna-calibrator2.jpg

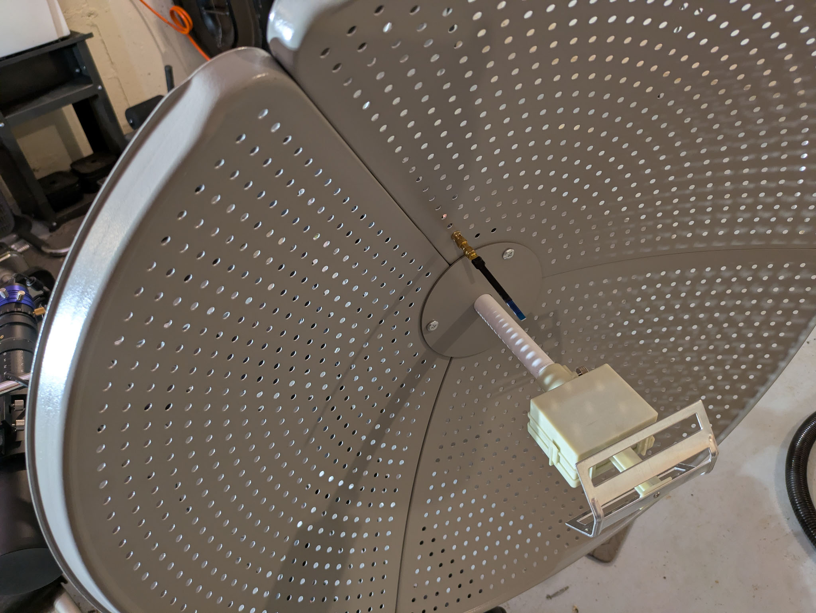
docs/hardware/img/antenna/antenna-calibrator2.jpg
