MITHaystack/ASTRA/docs/hardware/img/antenna/antenna-calibrator-connection.jpg

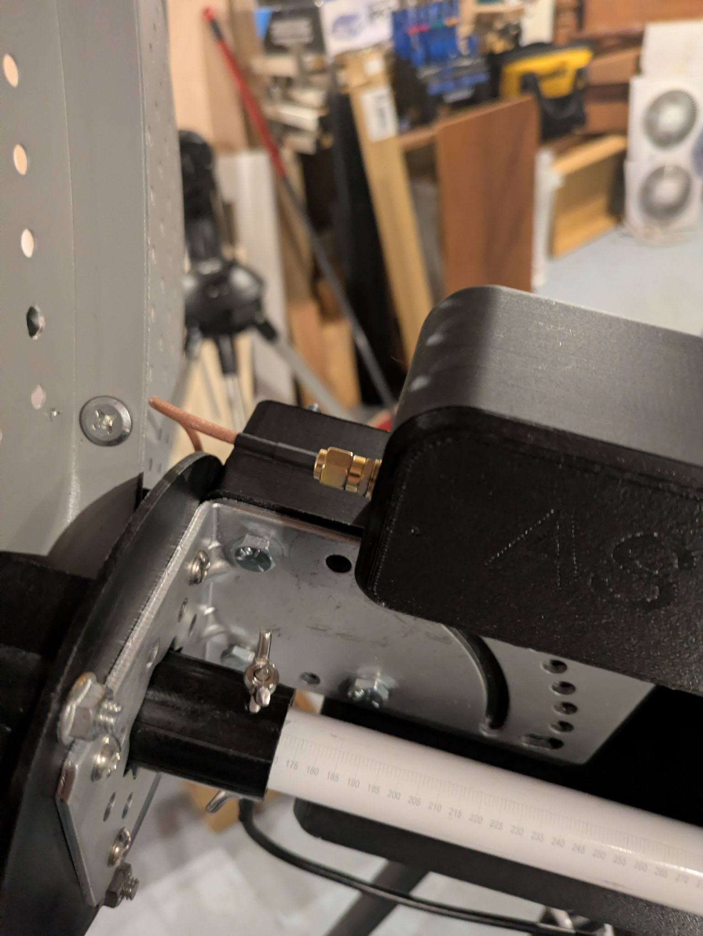
docs/hardware/img/antenna/antenna-calibrator-connection.jpg
