MITHaystack/ASTRA/docs/hardware/img/antenna/antenna-calibrator-hole-expansion2.jpg

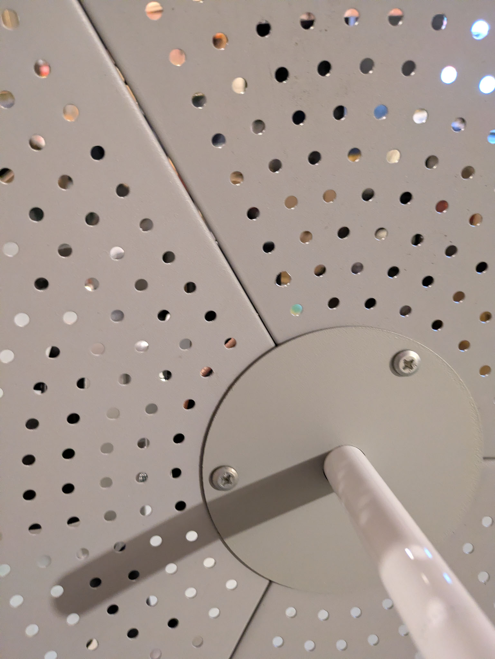
docs/hardware/img/antenna/antenna-calibrator-hole-expansion2.jpg
