MITHaystack/ASTRA/docs/hardware/img/antenna/antenna-calibrator-hole-expansion.jpg

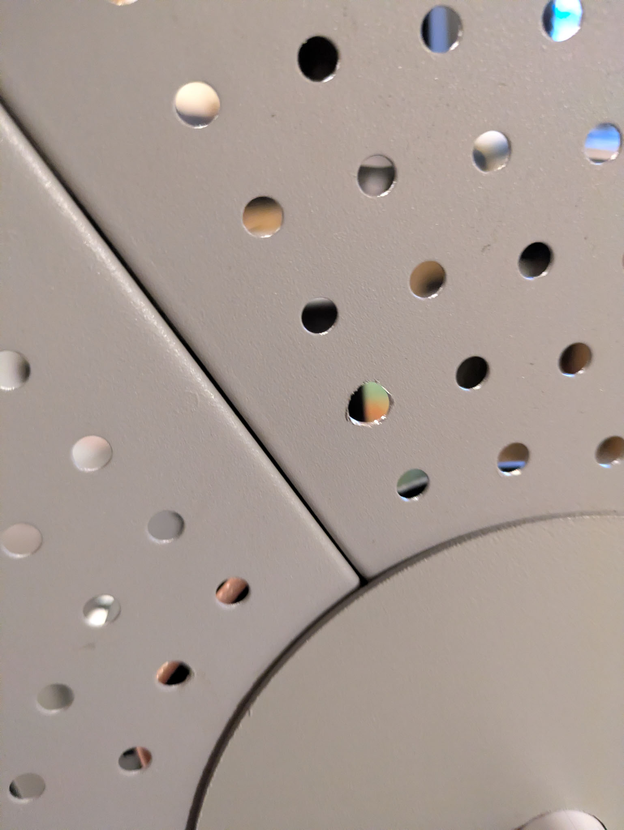
docs/hardware/img/antenna/antenna-calibrator-hole-expansion.jpg
