MITHaystack/ASTRA/docs/hardware/img/antenna/antenna-calibrator-probe.jpg

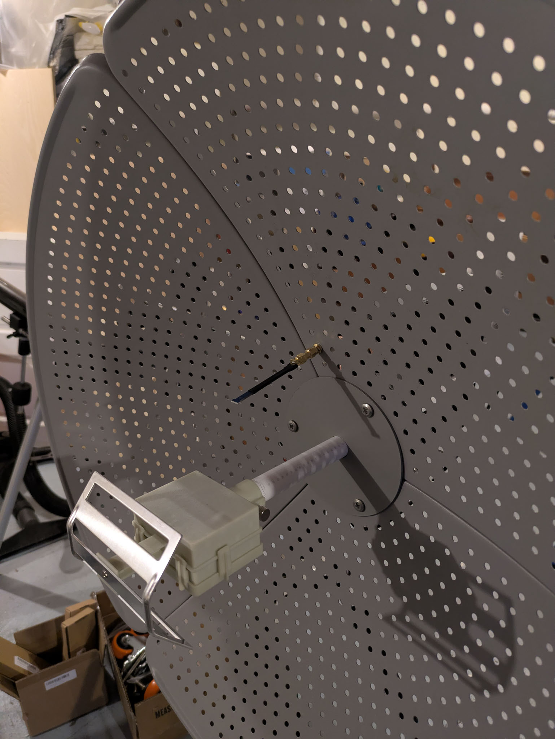
docs/hardware/img/antenna/antenna-calibrator-probe.jpg
