MITHaystack/ASTRA/docs/hardware/img/antenna/antenna-calibrator.jpg

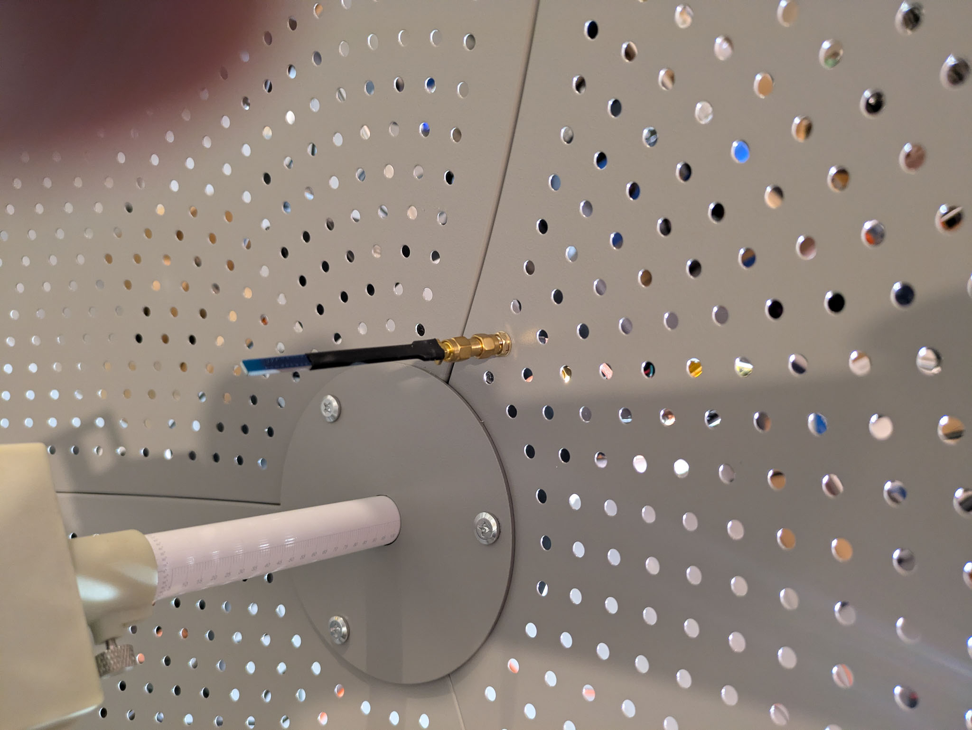
docs/hardware/img/antenna/antenna-calibrator.jpg
