MITHaystack/ASTRA/drawings/astra-architecture.pdf

## ASTRA (Automated Small Telescope for Radio Astronomy)

## Architectural Design

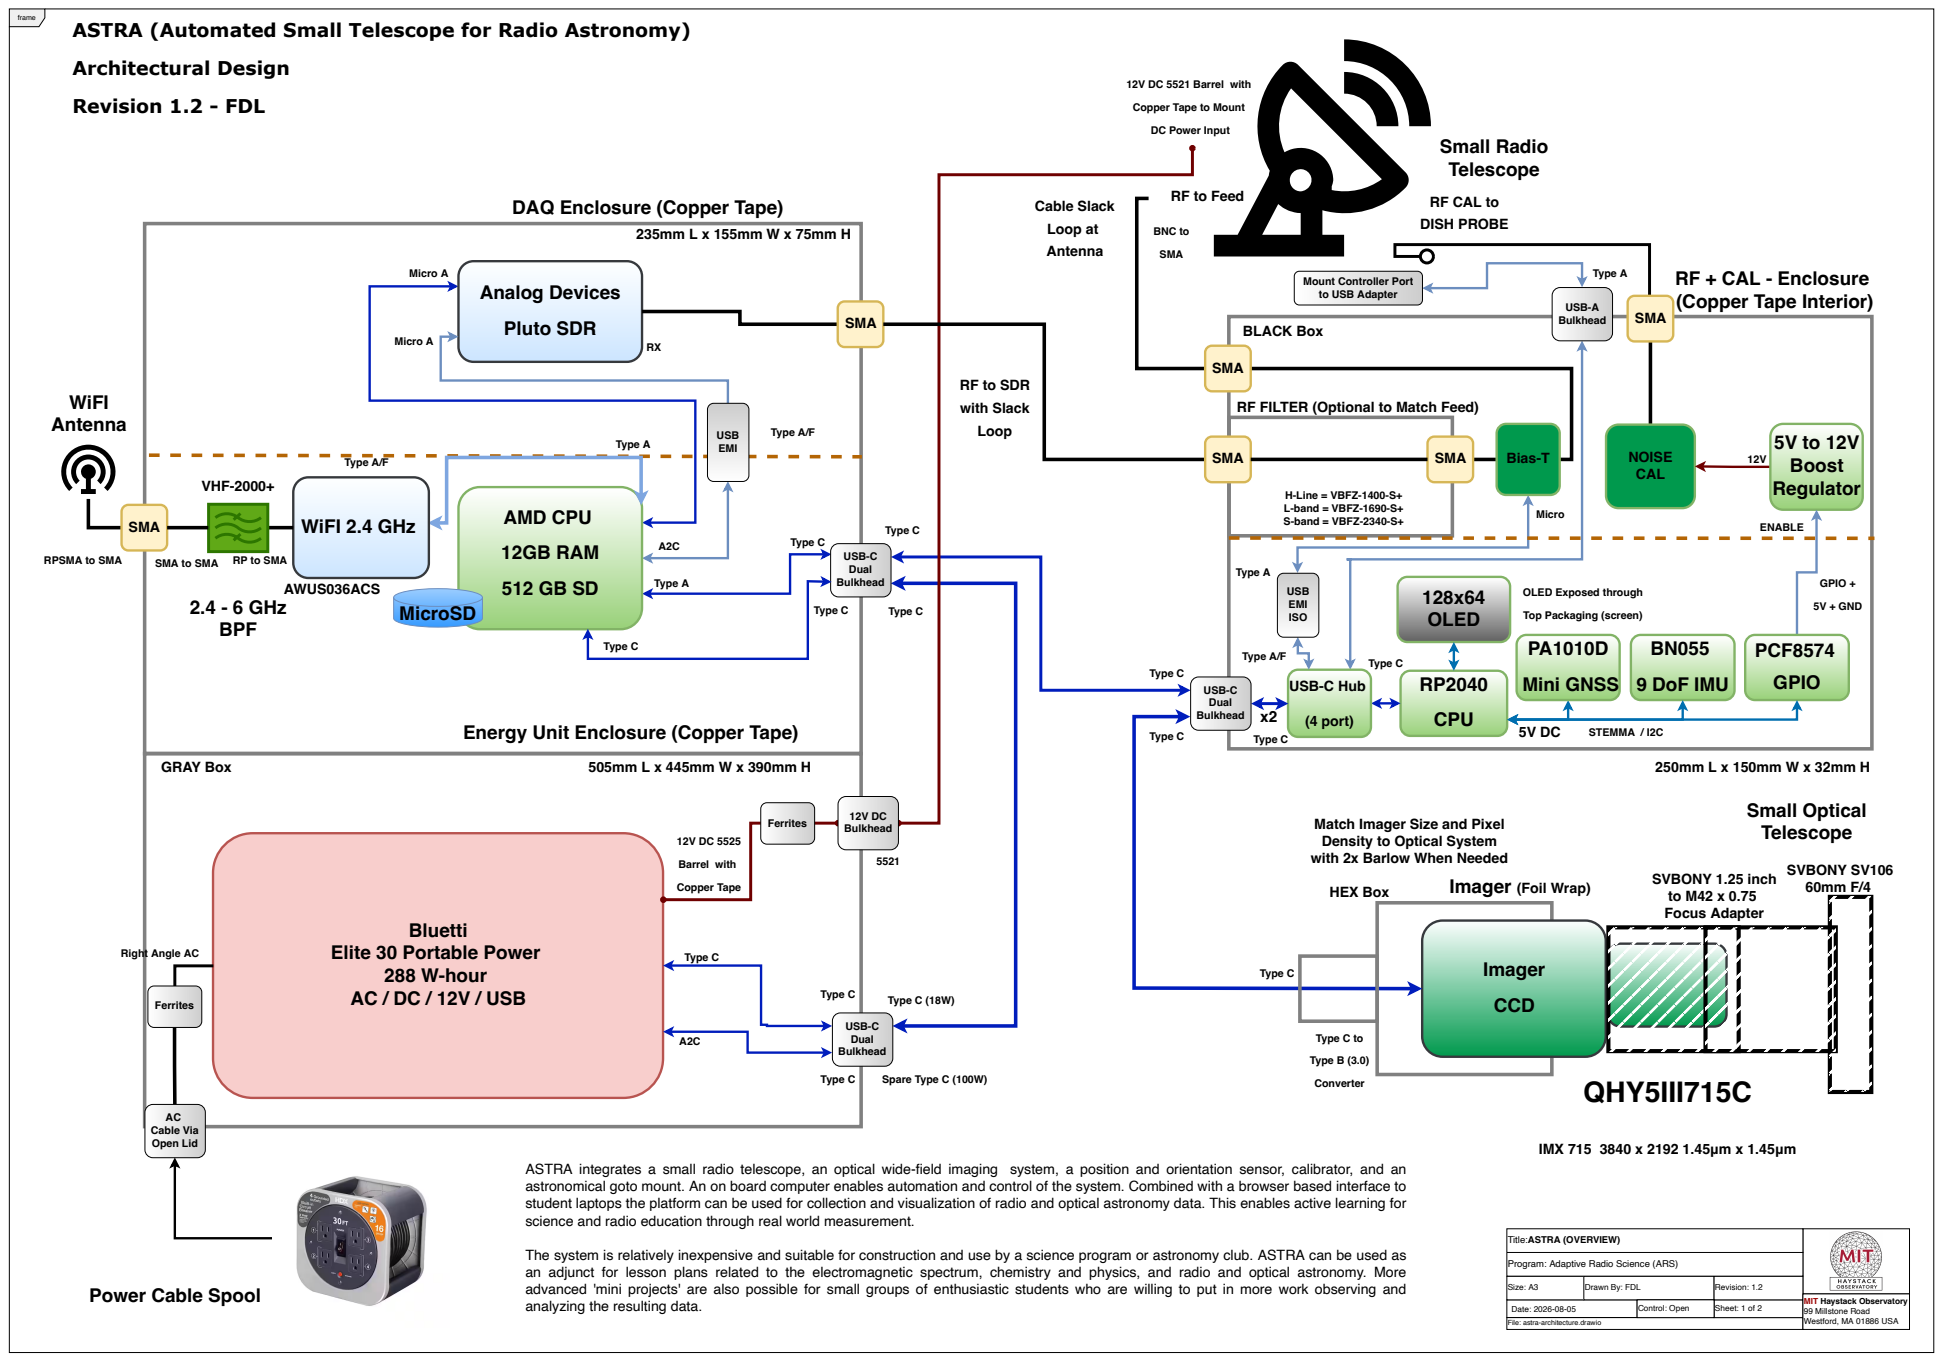
[picture p159: page 1]
frame; Revision 1.2 - FDL; Sheet: 1 of 2; Size: A3; Drawn By: FDL; Revision: 1.2; Control: Open; MIT Haystack Observatory; Date: 2026-08-05; AMD CPU; 12GB RAM; MicroSD; Analog Devices; Pluto SDR; Bluetti; SMA; WiFI 2.4 GHz; 2.4 - 6 GHz BPF; VHF-2000+; Micro A; AWUS036ACS; USB EMI; Type C; SMA to SMA; RP to SMA; USB-C; Dual; Type A; Bulkhead; Imager; CCD; WiFI Antenna; Type C to; Type B (3.0); Converter; USB-C Dual Bulkhead; Type A/F; Type C (18W) Type C; AC Cable Via Open Lid; 12V DC Bulkhead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

12V DC 5521 Barrel with

Copper Tape to Mount

DC Power Input

RF to Feed

DAQ Enclosure (Copper Tape)

RF CAL to
DISH PROBE

RF + CAL - Enclosure
(Copper Tape Interior)
SMA

Mount Controller Port
to USB Adapter

RF to SDR
with Slack
Loop

RF FILTER (Optional to Match Feed)

RPSMA to SMA

OLED Exposed through

Top Packaging (screen)

Energy Unit Enclosure (Copper Tape)

Match Imager Size and Pixel
Density to Optical System
with 2x Barlow When Needed

Imager (Foil Wrap)

Right Angle AC

Elite 30 Portable Power
288 W-hour
AC / DC / 12V / USB

ASTRA integrates a small radio telescope, an optical wide-field imaging system, a position and orientation sensor, calibrator, and an
astronomical goto mount. An on board computer enables automation and control of the system. Combined with a browser based interface to
student laptops the platform can be used for collection and visualization of radio and optical astronomy data. This enables active learning for
science and radio education through real world measurement.

Title:ASTRA (OVERVIEW)

The system is relatively inexpensive and suitable for construction and use by a science program or astronomy club. ASTRA can be used as
an adjunct for lesson plans related to the electromagnetic spectrum, chemistry and physics, and radio and optical astronomy. More
advanced 'mini projects' are also possible for small groups of enthusiastic students who are willing to put in more work observing and
analyzing the resulting data.

Program: Adaptive Radio Science (ARS)

Power Cable Spool

99 Millstone Road
Westford, MA 01886 USA

File: astra-architecture.drawio
