MITHaystack/ASTRA/src/rp2040/rp-ai-control.py

"""
    rpi-ai-control.py

    This is CircuitPython code for the Adafruit Feather Wing RP2040 board (). This code expects the RP2040 to be connected via
    pin headers to the Adafruit OLED 128x64 feather (4650) add on, a Adafruit 9-DOF Absolute Orientation IMU using the BNO055 (4646)
    using I2C, an Adafruit Mini GPS PA1010D (4415) via I2C, and a PCF8574 GPIO breakout (5545) via I2C which controls the enable of a 5V to 12V
    DC / DC converter and biases an RF noise diode source. 

"""

import board
import displayio
import terminalio
import busio
import time
import asyncio
import queue
import usb_cdc
import json
import math
import traceback

# devices - GNSS / GPS, 9 DoF IMU, GPIO
import adafruit_gps
import adafruit_bno055
import adafruit_pcf8574

# devices - 128x64 OLED display
# can try import bitmap_label below for alternative
from adafruit_display_text import label
from i2cdisplaybus import I2CDisplayBus
import digitalio

import adafruit_displayio_sh1107

VERSION = "v1.0.0b-20260802"

# Global state for use in the display routine
ai_state = {'group':'ai-state',
            'event':'status',
            'utc':"2000-01-01T00:00:00Z",
            'latitude':0.0,
            'longitude':0.0,
            'altitude':0.0,
            'sats':0,
            'fix':0,
            'temperature':0.0,
            'calibrated':0,
            'pointing':(0.0,0.0),
            'diode-state':'DISABLED'}

"""
    Convert quaternion to azimuth / altitude
    Assumes a sensor orientation with board top upward in case and adafruit logo to back near cover side.
"""
def quat_to_az_el(q, cal_info):
    w,x0,y0,z0 = q
    scale = math.sqrt(w*w+x0*x0+y0*y0+z0*z0)
    # rotate to IMU coordinates and scale
    x = x0 / scale
    y = y0 / scale
    z = z0 / scale
    # compute vectors
    #
    # note the adafruit bno055 coordinates are swapped
    # for east and north this flips everything
    #
    # transformed boresight vector is 
    Vx = 1 - 2.0 * (y**2 + z**2)
    Vy = 2.0 * (x*y + w*z)
    Vz = 2.0 * (x*z - w*y)

    # compute altaz    
    altitude = math.degrees(math.asin(Vz))
    azimuth = math.degrees(math.atan2(Vx,Vy))
    # Assumes a right-handed coordinate system where:
    #   +x is telescope boresight
    #   +y is left of antenna
    #   +z is up from gravity
    #
    # The IMU actually starts in relative mode so
    # this makes the initial coordinates align when
    # the mount is at 0.0 AZ 0.0 ALT.
    #
    # After the IMU (BNO055) sees enough motion it
    # will lock in the gyros, accelerometer, 
    # and magnetometer. We generally are not generating
    # linear motion so the accelerometer will often
    # not lock. When the magnetometer locks the unit will
    # reorient its idea of North relative to the -y axis. 
    # Our convention az +x along north for a 0.0, 0.0 
    # pointing.
    #
    # We must detect and correct prior to lock. 
    #

    # check calibration state and rotate azimuth
    try:
        if cal_info[0] == 0 and cal_info[3] == 0:
            azimuth -= 90.0
    except:
        pass

    return (azimuth, altitude)
    
    #vx = 1.0 - 2.0 * y**2 - 2.0 * z**2
    #vy = 2.0 * x * y + 2.0 * w * z
    #vz = 2.0 * x * z - 2.0 * w * y
    #azimuth = math.atan2(vy,vx)
    #elevation = math.asin(vz)
    #return math.degrees(azimuth), math.degrees(elevation)


"""
    Connect to the USB cdc path for console output and data.
    Requires a host side process to manage the associated commands and telemetry.
"""
# Needs to be in boot.py
def connect_usb_cdc():
    # grab the data serial interface
    usb_serial = usb_cdc.data
    # set timeouts to avoid blocking
    usb_serial.timeout = 0.01
    usb_serial.write_timeout = 0.05
    return usb_serial

"""
    Use the I2C bus on the RP2040 via Stemma QT to connect to the GPS.
"""
def connect_gps(logQ):
    try:
        i2c = board.STEMMA_I2C()  # For using the built-in STEMMA QT connector on a microcontroller
        gps = adafruit_gps.GPS_GtopI2C(i2c, debug=False)  # Use I2C interface
        gps.send_command(b"PMTK314,0,1,0,1,0,0,0,0,0,0,0,0,0,0,0,0,0,0,0")
        gps.send_command(b"PMTK220,1000")
    except Exception as e:
        e_event = {'event':'exception','group':'astra-gps-state','source':'connect_gps','value':f"{e}"}
        logQ.put(e_event)
        gps = None
        
    return gps

"""
    Get an update from the GPS and translate the telemetry into an associated
    python dictionary object. This will ultimately get serialized to json and
    sent back to the host. 
"""
def telemetry_gps(gps):
    
    if not gps.update():
        return
   
    gps_utc_time = "{:02}-{:02}-{:02}T{:02}:{:02}:{:02}Z".format(  
                    gps.timestamp_utc.tm_year,  
                    gps.timestamp_utc.tm_mon,  
                    gps.timestamp_utc.tm_mday, 
                    gps.timestamp_utc.tm_hour,  
                    gps.timestamp_utc.tm_min,  
                    gps.timestamp_utc.tm_sec) # no time but UTC in ISO8601

    gps_data = {
        'group' : 'astra-gps-data',
        'event' : 'telemetry',
        'utc'   : gps_utc_time,
        'adata' : gps.isactivedata,
        'fix'   : gps.has_fix,
        'fixQ'  : gps.fix_quality,
        'fixQ3d': gps.fix_quality_3d,
        'sats'  : gps.satellites,
        'track_angle_deg' : gps.track_angle_deg,
        'speed' : gps.speed_kmh,
        'hdil'  : gps.horizontal_dilution,
        'hgeoid': gps.height_geoid,
        'pdop'  : gps.pdop,
        'vdop'  : gps.vdop,
        'latitude'  : gps.latitude,
        'longitude' : gps.longitude,
        'altitude'  : gps.altitude_m,
        'nmea': gps.nmea_sentence
    }

    return gps_data

"""
    Use the I2C bus on the RP2040 via Stemma QT to connect to the BNO055 9 DoF IMU.
"""
def connect_imu(logQ):
    try:
        i2c = board.STEMMA_I2C()  # For using the built-in STEMMA QT connector on a microcontroller

        imu = adafruit_bno055.BNO055_I2C(i2c)

        imu.accel_range = 0 # 2G
        imu.mode = adafruit_bno055.NDOF_MODE

    except Exception as e:
        e_event = {'event':'exception','group':'astra-imu-state','source':'connect_imu','value':f"{e}"}
        logQ.put(e_event)
        imu = None
    
    return imu

"""
    Get an update from the IMU and translate the telemetry into an associated
    python dictionary object. This will ultimately get serialized to json and
    sent back to the host. 
"""
def telemetry_imu(imu):

    # read at once to keep consistent
    euler = imu.euler
    quaternion = imu.quaternion
    cal_info = imu.calibration_status
    pointing = quat_to_az_el(quaternion, cal_info)
    # need to figure out if this has declination to remove or not...

    imu_data = {
        'group' : 'astra-imu-data',
        'event' : 'telemetry',
        'temperature' : imu.temperature,
        'calibrated' : imu.calibrated,
        'cal_status' : cal_info,
        'euler'      : euler,
        'pointing'   : pointing,
        'gravity'    : imu.gravity,
        'gyro'       : imu.gyro,
        'acceleration' : imu.acceleration,
        'linear_acceleration' : imu.linear_acceleration,
        'magnetic'  : imu.magnetic,
        'quaternion' : quaternion,
    }
    
    return imu_data

"""
    Use the I2C bus on the RP2040 via Stemma QT to connect to the PCF8574 GPIO chip.
"""
def connect_gpio(logQ):
    #print("connect gpio")
    try:
        i2c = board.STEMMA_I2C()  # For using the built-in STEMMA QT connector on a microcontroller
        diode_gpio = adafruit_pcf8574.PCF8574(i2c)
    except Exception as e:
        e_event = {'event':'exception','group':'astra-gpio-state','source':'connect_gpio','value':f"{e}"}
        logQ.put(e_event)
        diode_gpio = None
    
    return diode_gpio

"""
    Thread that gathers GPS telemetry at a specified rate
    and pushes it to the telemetry queue. Errors are logged to 
    the log queue. 
"""
async def gps_telemetry(telemetryQ,logQ, i2cSBL, stateL, gps,gps_period):
    global ai_state
    while True:
        #print("update gps_telemetry")
        # GPS
        try:
            async with i2cSBL:
                gps_t = telemetry_gps(gps)
                if gps_t is None:
                    await asyncio.sleep(gps_period)
                    continue    

            await telemetryQ.put(gps_t)
            # update global AI state
            async with stateL:
                #print("update gps", gps_t)
                ai_state['utc'] = gps_t['utc']
                ai_state['latitude'] = gps_t['latitude']
                ai_state['longitude'] = gps_t['longitude']
                ai_state['altitude'] = gps_t['altitude']
                ai_state['sats'] = gps_t['sats']
                ai_state['fix'] = gps_t['fix']
            
        except Exception as e:
            e_event = {'event':'exception','group':'astra-gps-state','source':'gps_telemetry','value':f"{e}"}
            await logQ.put(e_event)

        await asyncio.sleep(gps_period)

"""
    Thread that gathers IMU telemetry at a specified rate
    and pushes it to the telemetry queue. Errors are logged to 
    the log queue. 
"""
async def imu_telemetry(telemetryQ,logQ,i2cSBL,stateL,imu,imu_period):
    global ai_state
    while True:
        #print("update imu_telemetry")
        # IMU
        try:
            async with i2cSBL:
                imu_t = telemetry_imu(imu)
                
                if imu_t is None:
                    await asyncio.sleep(imu_period)
                    continue

            await telemetryQ.put(imu_t)
 
            # update global AI state
            async with stateL:
                #print("update imu", imu_t)
                ai_state['temperature'] = imu_t['temperature']
                ai_state['pointing'] = imu_t['pointing']

                if imu_t['calibrated']:
                    #print("full calibration")
                    ai_state['calibrated'] = 'CAL'
                else:
                    res = "".join("+" if val >= 2 else "-" for val in imu_t['cal_status'])
                    ai_state['calibrated'] = res
                    #print("cal val" ,res)

 
        except Exception as e:
            #traceback.print_exec()
            e_event = {'event':'exception','group':'astra-imu-state','source':'imu_telemetry','value':f"{e}"}
            await logQ.put(e_event)
 
        await asyncio.sleep(imu_period)


"""
    Thread that handles noise diode commands. Currently
    this includes static enable, disable, and a pulse alternating 
    at the diode period.
"""
async def noise_diode_handler(diodeQ, logQ, i2cSBL, displayL, diode_gpio, diode_period):
    global ai_state
    diode_state = 'DISABLE'
    diode_pulse_state = 0
   
    while True:
        #print("update noise_diode_handler")

        # noise diode
        try:
            try:
                ndata = diodeQ.get_nowait()
                if ndata['mode'] == 'ENABLE':
                    diode_state = 'ENABLE'
                    status = {'event':'status','group':'astra-diode-state', 'source':'noise_diode_handler', 'value':f"enable"}
                elif ndata['mode'] == 'DISABLE':
                    diode_state = 'DISABLE'
                    status = {'event':'status','group':'astra-diode-state', 'source':'noise_diode_handler', 'value':f"disable"}
                elif ndata['mode'] == 'PULSE':
                    diode_state = 'PULSE'
                    status = {'event':'status','group':'astra-diode-state', 'source':'noise_diode_handler', 'value':f"pulse"}
                else:
                    status = {'event':'status','group':'astra-diode-state', 'source':'noise_diode_handler', 'value':f"unknown command {ndata['value']}"}

                await logQ.put(status)

            except:
                pass
            
            # lock I2C bus
            async with i2cSBL:
                # handle the state behavior
                if diode_state == 'ENABLE':
                    # turn on the diode
                    diode_gpio.write_gpio(0x01)
                elif diode_state == 'DISABLE':
                    # turn off the diode
                    diode_gpio.write_gpio(0x00)
                elif diode_state == 'PULSE':
                    # toggle the diode on and off at the update rate
                    if diode_pulse_state == 0:
                        diode_pulse_state = 1
                        diode_gpio.write_gpio(0x01)
                    else:
                        diode_pulse_state = 0
                        diode_gpio.write_gpio(0x00)

            # update global AI state
            async with displayL:
                ai_state['diode-state'] = diode_state
            
        except Exception as e:
            e_event = {'event':'exception','group':'astra-diode-state','source':'noise_diode_handler','value':f"{e}"}
            await logQ.put(e_event)

        await asyncio.sleep(diode_period)

"""
    Connect to the OLED display using Use the I2C bus on the RP2040. This is actually hard 
    wired via the pin conections between the RP2040 feather and the OLED wing board. 
"""
def connect_display(logQ):

    try:
        displayio.release_displays()
        # oled_reset = board.D9

        # Use for I2C
        b_i2c = board.I2C()  # uses board.SCL and board.SDA
        # i2c = board.STEMMA_I2C()  # For using the built-in STEMMA QT connector on a microcontroller
        display_bus = I2CDisplayBus(b_i2c, device_address=0x3C)

        # SH1107 is vertically oriented 64x128
        WIDTH = 128
        HEIGHT = 64
        display = adafruit_displayio_sh1107.SH1107(display_bus, width=WIDTH, height=HEIGHT) 
       
    except Exception as e:
        e_event = {'event':'exception','group':'astra-display-state','source':'connect_display','value':f"{e}"}
        logQ.put(e_event)
        
    return display

"""
    Thread that handles display commands. Currently
    this includes a single basic output method. 
"""
async def display_handler(logQ, displayL, display, display_period):
    global ai_state
    display_counter = 0

    # startup splash group
    splash = displayio.Group()

    # slash group
    text_area_pos1 = label.Label(terminalio.FONT, text="ASTRA", scale=2, color=0xFFFFFF, x=8, y=8)
    splash.append(text_area_pos1)
    text_area_info1 = label.Label(terminalio.FONT, text="MIT", color=0xFFFFFF, x=8, y=34)
    splash.append(text_area_info1)
    text_area_loc1 = label.Label(terminalio.FONT, text="Haystack Observatory", color=0xFFFFFF, x=8, y=44)
    splash.append(text_area_loc1)
    text_area_utc1 = label.Label(terminalio.FONT, text=VERSION, color=0xFFFFFF, x=8, y=54)
    splash.append(text_area_utc1)    

    # update group
    update_group = displayio.Group()
    text_area_pos2 = label.Label(terminalio.FONT, text="+000.0/+00.0 |CAL", scale=1, color=0xFFFFFF, x=2, y=8)
    update_group.append(text_area_pos2)
    text_area_info2 = label.Label(terminalio.FONT, text="+00.0C | 1000m | 00", color=0xFFFFFF, x=2, y=24)
    update_group.append(text_area_info2)
    text_area_loc2 = label.Label(terminalio.FONT, text="+00.00 | +000.00 | F", color=0xFFFFFF, x=2, y=34)
    update_group.append(text_area_loc2)
    text_area_utc2 = label.Label(terminalio.FONT, text="2026-01-01T00:00:00Z", color=0xFFFFFF, x=2, y=44)
    update_group.append(text_area_utc2)

    display.root_group = splash
    display_state = "STARTUP"

    # command based output
    while True:
        #print("update display_handler")
        output_data = None

        # display based on state
        # show a splash screen on startup with system info
        # transition to leveling if mount is not level
        # transition to standby if level and update overall status
        try:
            if display_state == "STARTUP":
                    #print('STARTUP')
                    if display_counter >= 5:
                        display_state = "SETUP"
            elif display_state == "SETUP":
                    #print('SETUP')
                    display.root_group = update_group
                    display_state = "UPDATE"
            elif display_state == "UPDATE":
                    #print('UPDATE')
                    async with displayL:
                        #print(ai_state['calibrated'])
                        if ai_state['calibrated']:
                            cinfo = ai_state['calibrated']
                        else:
                            cinfo = '   '

                        #print(ai_state['pointing'])
                        az,el = ai_state['pointing']
                        text_area_pos2.text = f"{az:+6.1f}/{el:+5.1f} |{cinfo}"
                        
                        #print(ai_state['temperature'],ai_state['altitude'],ai_state['sats'])
                        degC = ai_state['temperature']
                        alt = ai_state['altitude']
                        sats = ai_state['sats']
                        text_area_info2.text = f"{degC:+5.1f}C | {alt:4.0f}m | {sats:02d}"

                        #print(ai_state['latitude'],ai_state['longitude'])
                        lat = ai_state['latitude']
                        lon = ai_state['longitude']
                        if ai_state['fix'] > 0:
                            finfo = 'F'
                        else:
                            finfo = '-'
                        text_area_loc2.text = f"{lat:+6.2f} | {lon:+7.2f} | {finfo}"
                        
                        text_area_utc2.text = f"{ai_state['utc']}"

        
            display_counter += 1

            # report handler status
            status = {'event':'status','group':'astra-display-state','source':'display_handler', 'value':f"({display_state},{display_counter})"}
            await logQ.put(status)

        except Exception as e:
            e_event = {'event':'exception','group':'astra-display-state','source':'display_handler','value':f"{e}"}
            await logQ.put(e_event)

        await asyncio.sleep(display_period)
    
"""
    The command handler takes in an event if available and dispatches it to the
    appropriate handler. 
"""
async def command_handler(eventQ, logQ, diodeQ, cmd_period):
    while True:
        #print("update command handler")
        try:
            cmd = eventQ.get_nowait()
            if cmd['group'] == 'astra-ai-diode-cmd':
                await diodeQ.put(cmd)
            elif cmd['group'] == 'astra-ai-print-cmd':
                print(cmd['value'])
            
            status = {'event':'status', 'group':'astra-command-state', 'source':'command_handler', 'value':f"dispatched {cmd}"}
            await logQ.put(status)

        except:
            pass


        await asyncio.sleep(cmd_period)

"""
    The usb communications thread takes telemetry and log information and outputs it
    to the USB CDC data interface. Incoming data are also read in a single line format
    and the associated command is converted from a json to python object and queued for
    command processing. The associated timeouts of the usb_cdc interface are assumed to be
    set to prvent blocking. If the bus is not connected telemetry and log data are output to the 
    REPL as normal print out of the associated objects. No attempt to read a command is made
    for a disconnected bus. 
"""
async def usb_communications(telemetryQ, eventQ, logQ, usb_serial, com_period):
    while True:
        #print("update usb_communications")
        # send telemetry if available
        try:
            tdata = telemetryQ.get_nowait()
            if tdata is not None:
                tdata_json = json.dumps(tdata)
                if usb_serial.connected:
                    usb_serial.write(tdata_json)
                    usb_serial.write("\n")
                else:
                    print(tdata)
        except Exception as e:
            pass

        # send log data if available
        try:
            ldata = logQ.get_nowait()
            if ldata is not None:
                ldata_json = json.dumps(ldata)
                if usb_serial.connected:
                    usb_serial.write(ldata_json)
                    usb_serial.write("\n")
                else:
                    print(ldata)
        except:
            pass
        
        line = None
        # get a python dictionary command as a json object
        try:
            if usb_serial.connected:
                try:
                    line = usb_serial.readline()
                except:
                    pass
                if line is not None and len(line) > 0:
                    cmd = json.loads(line)
                    await eventQ.put(cmd)
        except ValueError as e:
                print(f"JSON syntax error: {line}")
        except Exception as e:
                e_event = {'event':'exception','group':'astra-usb-state','source':'usb_communications','value':f"{e}"}
                await logQ.put(e_event)

        await asyncio.sleep(com_period)

"""
    Primary Thread Startup 
"""
async def main():
    print("rp-ai-control startup")

    print("create async control")
    eventQ = queue.Queue()
    telemetryQ = queue.Queue()
    logQ = queue.Queue()
    diodeQ = queue.Queue()
    i2cSBL = asyncio.Lock()
    stateL = asyncio.Lock()

    print("set update periods")
    # set update periods in seconds
    com_period = 0.1
    gps_period = 0.5
    imu_period = 0.5
    cmd_period = 0.1
    diode_period = 0.25
    display_period = 0.25
 
    # connect data path via USB, expects serial handler device on other end
    # some of this happens in boot.py, timeouts get set here...
    print("connect usb serial")
    usb_serial = connect_usb_cdc()
 
    print("activate interfaces")
    # activate the display interface
    display = connect_display(logQ)
    # activate the GPS interface
    gps = connect_gps(logQ)
    # activate the IMU interface
    imu = connect_imu(logQ)
    # activate the GPIO interface
    diode_gpio = connect_gpio(logQ)

    print("setup asyncio tasks")
    clients = [asyncio.create_task(usb_communications(telemetryQ, eventQ, logQ, usb_serial, com_period))]
    clients.append(asyncio.create_task(gps_telemetry(telemetryQ, logQ, i2cSBL, stateL, gps, gps_period)))
    clients.append(asyncio.create_task(imu_telemetry(telemetryQ, logQ, i2cSBL, stateL, imu, imu_period)))
    clients.append(asyncio.create_task(command_handler(eventQ, logQ, diodeQ, cmd_period)))
    clients.append(asyncio.create_task(noise_diode_handler(diodeQ, logQ, i2cSBL, stateL, diode_gpio, diode_period)))
    clients.append(asyncio.create_task(display_handler(logQ, stateL, display, display_period)))

    print("run")

    await asyncio.gather(*clients)


asyncio.run(main())
