MITHaystack/ASTRA/(commit log)

2026-08-05 quick and mostly right bom as markdown and csv
    [astra-bom.csv]
2026-08-05 Stage directories for lessons.
2026-08-12 Latest code base updates and fixes
    [astra-motion.py, azgti.py]
2026-08-13 Updates to add features and fix bugs.
    [astra-motion.py, main.py]
2026-08-16 Stage changes to correct file.
2026-08-17 Fixup links and remove DSO call from catalog building due to threading bug.
2026-08-18 Move BOM to hardware
    [astra-bom.csv]
2026-08-18 Reduce print verbosity.
2026-08-18 Fixup extra print statements.
    [azgti.py]
2026-08-18 Switch to port 80
2026-08-19 Push first fix for nicegui version update
    [main.py]
2026-08-19 Try pushing a longer timer interval for spectrometer
2026-08-20 Fixup button sizing.
2026-10-19 ASTRA 3D Models for Printing
2026-10-19 ASTRA 3D Printing Models
2026-10-19 Additional 3D printing files
2026-10-19 Modified 3D print list
2026-10-20 More 3D print links.
